HKUSTGZ-ROBOMASTER-PNX/RM25_SC5.5_OpenSource/README.md

# __RM2025赛季香港科技大学（广州）PnX战队 超级电容控制板开源文档__

# __目录__

- [__RM2025赛季香港科技大学（广州）PnX战队 超级电容控制板开源文档__](#rm2025赛季香港科技大学广州pnx战队-超级电容控制板开源文档)
- [__目录__](#目录)
  - [__序言__](#序言)
  - [__超级电容控制基本原理__](#超级电容控制基本原理)
  - [__工程原理图设计__](#工程原理图设计)
    - [__供电部分__](#供电部分)
    - [__MCU部分__](#mcu部分)
    - [__模拟部分__](#模拟部分)
    - [__DCDC部分__](#dcdc部分)
  - [__工程PCB设计__](#工程pcb设计)
    - [__区域划分__](#区域划分)
    - [__功率部分__](#功率部分)
    - [__供电部分和模拟部分__](#供电部分和模拟部分)
    - [__其他部分__](#其他部分)
  - [__代码设计__](#代码设计)
    - [__基本架构__](#基本架构)
    - [__外设配置__](#外设配置)
      - [__时钟__](#时钟)
      - [__HRTIM__](#hrtim)
      - [__ADC__](#adc)
      - [__其他外设__](#其他外设)
    - [__控制部分__](#控制部分)
      - [__Debug模式和拟合计算__](#debug模式和拟合计算)
      - [__闭环控制__](#闭环控制)
      - [__Buck与Buck-Boost与Boost切换__](#buck与buck-boost与boost切换)
  - [__测试纪录__](#测试纪录)
    - [__供电纹波__](#供电纹波)
    - [__栅极驱动__](#栅极驱动)
    - [__SW振荡__](#sw振荡)
    - [__自举电容__](#自举电容)
  - [__加工焊接测试流程__](#加工焊接测试流程)
    - [__PCB+SMT加工要求__](#pcbsmt加工要求)
    - [__焊接测试顺序__](#焊接测试顺序)
  - [__问答讨论__](#问答讨论)
  - [__版本迭代__](#版本迭代)

## __序言__

本项目为RM2025赛季香港科技大学（广州）PnX战队南部区域赛上车版本超电电容控制板（以下简称超电）开源。项目关键词：极高转换效率，低静态功耗。

PnX战队的英雄机器人、全向轮步兵、并联腿步兵、哨兵上安装了此版本超电，全向轮步兵和并联腿步兵经过电控调试后具备场上快速移动和飞坡能力。
针对RM25赛季的底盘20000J总能量限制，本项目重点优化了静态功率和转换效率，实测可以实现实现空载0.8W（24V输入，25.1V输出，所有功能与上车时相同），全负载范围97.6%效率（24V输入，12V输出，去除线损，45W-200W），峰值98.2%(24V输入，12V输出，去除线损，100W)，20A最大输出电流。

本项目为某队21年未开源版本超电的终极升级版，某队21年在没有超电的情况下惜败于湖北站3V3决赛后，笔者痛定思痛花2个月时间，参考安和科技F334 BuckBoost Demo板，完成了初版超电的软硬件设计，初版只有8A最大电流、1.7W空载功率、93%左右效率，在21赛季处于够用水平，但是不符合25赛季的性能要求。
经过多个版本迭代优化，最终在5.5版本实现了所需功能，版本迭代记录在文档中有详细记录。

***

##  __超级电容控制基本原理__

本项目的超级电容控制基于理想情况（忽略所有内阻）下的2个前提条件：

    1.电容端的电压可以通过输入电压和BuckBoost占空比直接计算
    2.电容端的功率可以通过电容端电压变化速率（dv/dt）直接控制

条件1不能理解，输出电压本来就可以通过输入电压和占空比直接计算，考虑到元器件和PCB内阻带来的压降，实测值和理论值会有一点点误差。

条件2不难证明，按照南方科技大学2024技术方案开源，电容端功率 $P = CV \frac{dV}{dt}$，其中$C$为容组电容大小，$V$为容组电压，在固定控制频率$f$下 $dt$可以转化为$\Delta{t}= \frac{1}{f}$，因此方程转化为$\Delta{V}=\frac{P}{CVf}$，这样对应任意的所需电容功率$P$，都可以计算出对应的$\Delta{V}$，最终根据条件1计算出占空比的变化$\Delta{\eta}$。

理论计算的结果就是功率控制可以由等式计算得来，无需使用PID等反馈控制方法。实际上因为存在能量损失和采样误差，最好还是以理论公式为前馈，使用PID补足误差。

*** 

## __工程原理图设计__

###  __供电部分__

供电比较常规，没有使用隔离电源或者电荷泵之类的花活。从Chassis口引24V经过一个SS210的二极管做防反接，这里没有直接在Bat输入口使用NMOS或者PMOS之类做更复杂的防反接保护，是为了避免引入额外损耗。过二极管得到的24V只用于降10V给板子上其他部分供电，所以电流很小，损耗可以忽略不计，防反接只是为了避免把MCU全部干穿，万一反接了还是依靠电池本身的短路保护。

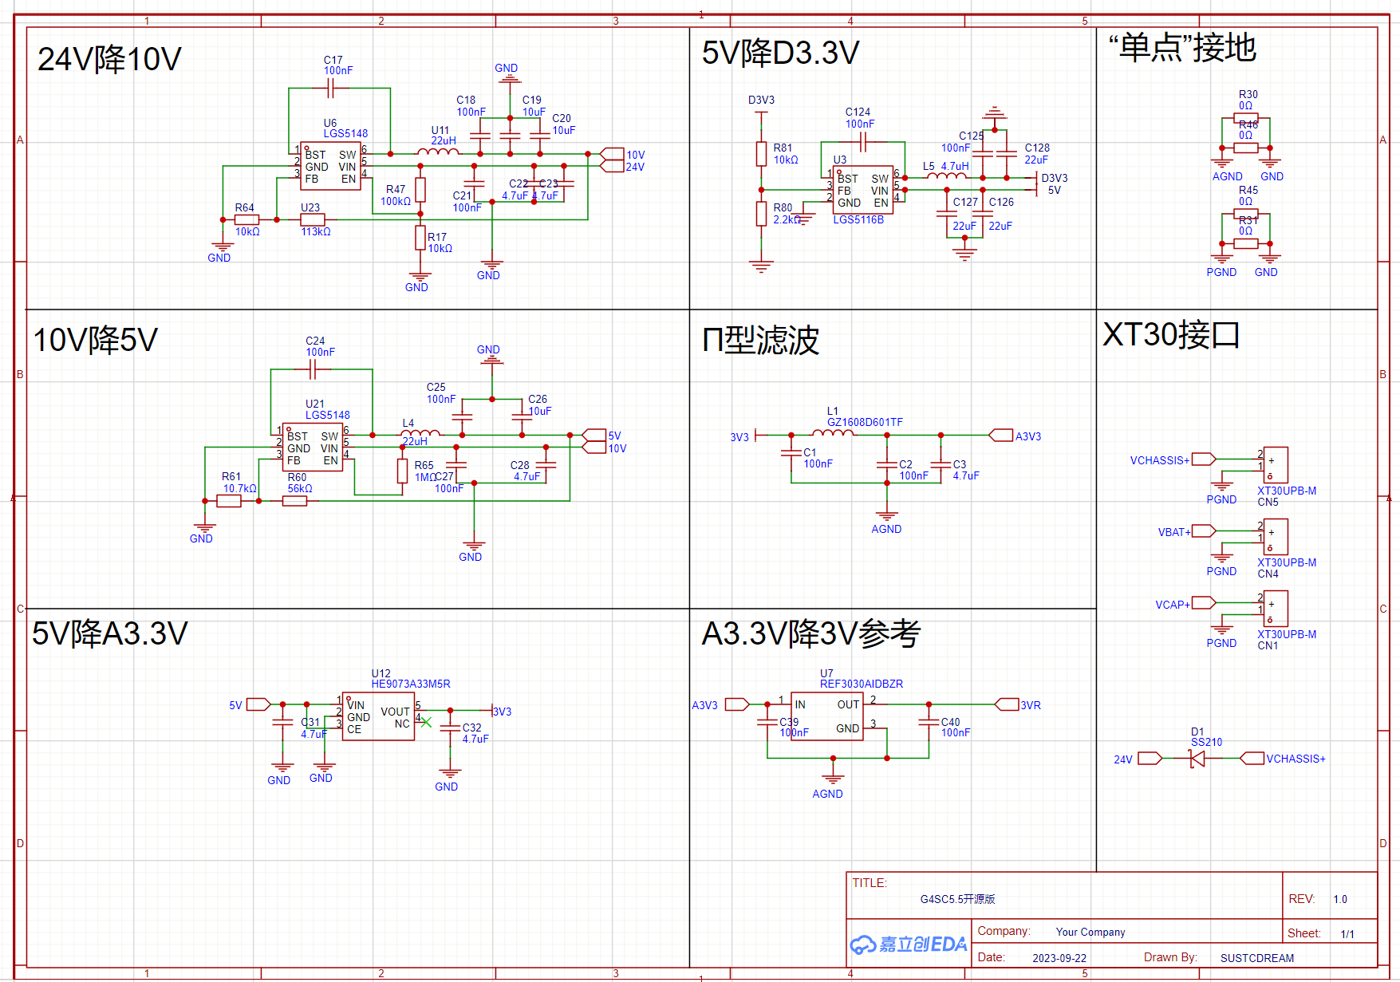
[picture p1: 图片/Markdown图片/2供电.png]
  

24V降10V和10V降5V都使用了国产LGS5148，主要是看重它48V耐压和极高的轻载效率，有群友说测得轻载下纹波非常大，甚至干扰了栅极驱动，本工程中没有出现这类问题，详情请见测试纪录部分。10V主要用于MOS栅极驱动供电，5V主要用于CAN通讯，<span style="color: red;">注意</span>24V降10V需要设置EN分压，大概设置到17V左右启动即可，从根源上避免推车等意外上电情况。注意LGS5148曾经发生过断货，如果实在买不到可以用SY8301替代。

5V降D3V3使用了同厂商的LGS5116B，主要是因为更便宜、有现货、在其他设计中使用了、买了很多没用完，D3V3是5.5版本新加的设计，之前一直是LDO出3V3。D3V3专门给MCU供电，可以略微降低静态功耗和减少对模拟部分的干扰，有些开源设计中担心24V降10V降5V降3V3的连续3个Buck降压会引入很大的纹波，本工程中没有出现这类问题，详情请见测试纪录部分。

5V降3V3使用了国产LDO HE9073A33M5R，它的PSRR在100KHz以上显著好于AMS1117，比RT9193好一点点，比TI的LP5907差一些，因为Vref+有专门的芯片提供，这里影响不大。

3V3经过Π型滤波后得到A3V3，提供给各个模拟部分供电。A3V3再过REF3030得到3V参考电压，暂时找不到性价比相对REF3030更好的替代品。

这里解释一下为什么模拟部分的供电比较复杂，按照TI的文档给出的公式，ADC总噪声中可以通过供电部分优化的是供电噪声和电压基准噪声，供电噪声受PSRR作用而一般影响不大，所以LDO部分相对随意，而电压基准噪声非常关键所以要专门处理。

  

各自用2个0Ω电阻做PGND、GND、AGND之间单点连接，所谓“单点”只是区域和区域之间的泛指，用2个电阻主要是为了防止虚焊或者电阻失效情况，具体设计在PCB部分。

***

###  __MCU部分__

MCU部分比较常规，G474相对于F334在性能、价格、开发难度的综合指标上更优，G4的Pinout都比F3更合理，而且F334没有独立的Vref+引脚。<span style="color: red;">注意</span>G474RBT6比G474CBT6便宜，5.5版本改为G474CBT6完全是为了缩尺寸。

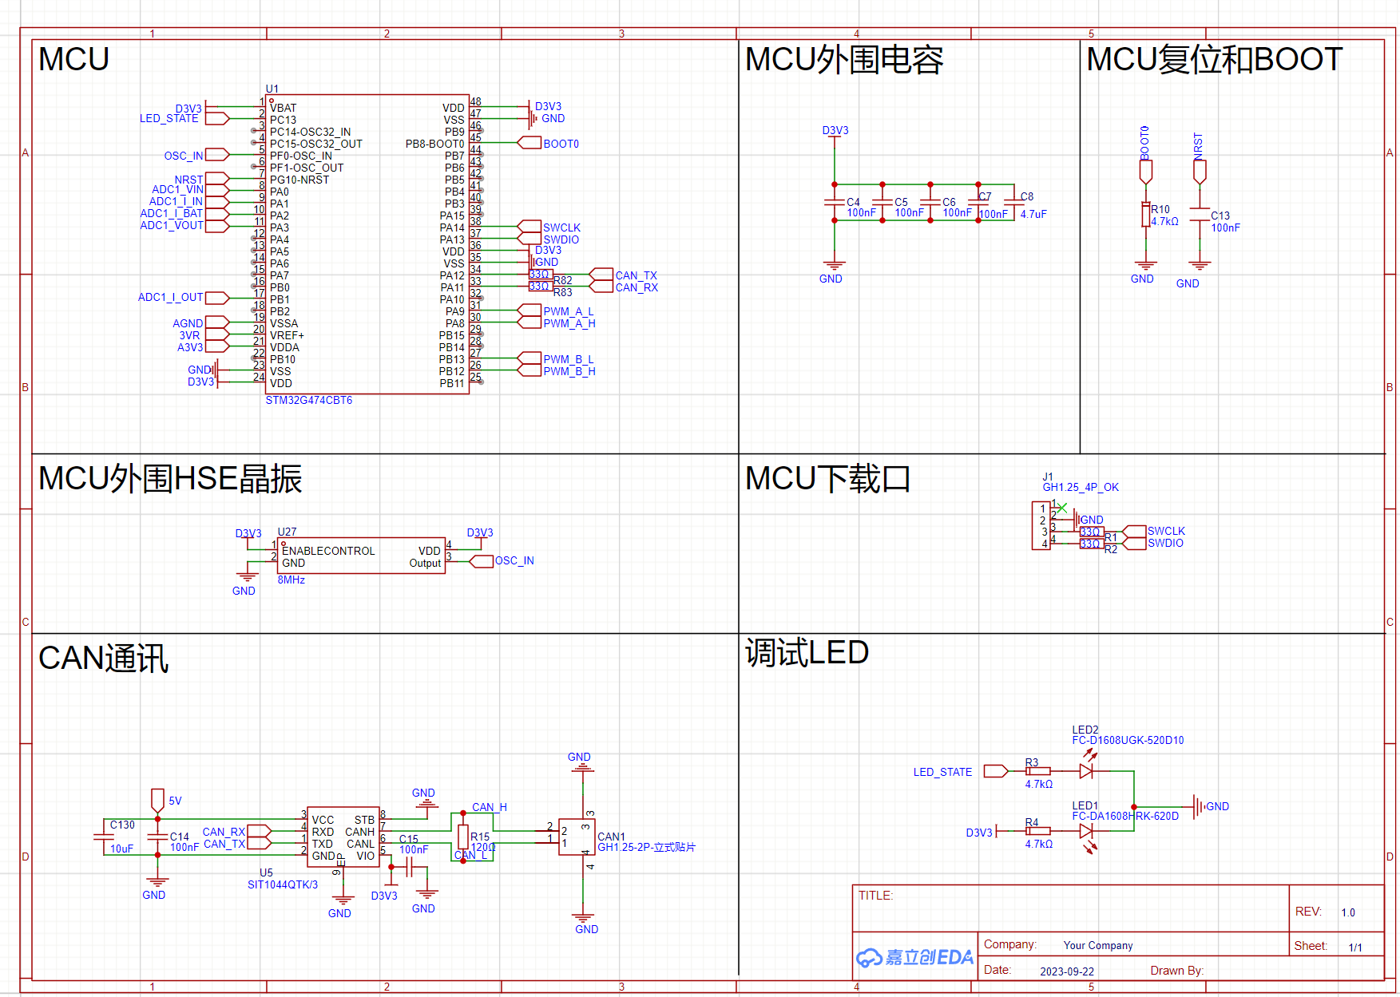
[picture p2: 图片/Markdown图片/4MCU.png]
  

HSE使用了8MHz有源晶振，主要是因为某队某年的第一版超电用无源晶振不起振，代码上临时改为HSI，后续替换为有源晶振但是代码忘记改回去了，直到2年后才发现。无源晶振便宜很多而且EMI友好，有兴趣可以改用无源晶振。

SWCLK和SWDIO串了33Ω电阻，实测可以明显提高DCDC开启时的Debug连接稳定性和代码下载成功率。外置BOOT0下拉电阻和NRST滤波电容，这里没有使用按键复位，主要是为了避免调试过程中手欠，系统复位需要通过Debug或者上下电。供电LED和调试LED用于指示系统状态，消耗不到0.1W静态功耗得到2个独立关键状态指示是完全可以接受的，某些情况下可以通过抓LED高低电平计算CPU占用率。

CAN收发器使用了国产SIT1044QTK/3，5V供电，3.3Vio，QFN小封装，面向未来的5Mbps CAN-FD，不使用NXP完全是因为立创商城要签什么出口禁制声明。1042相对1044的CAN_H CAN_L耐压更高（±70V相对于±40V），如果有48V系统会考虑使用SIT1042。

***

###  __模拟部分__

模拟部分上了点狠活，虽然超电的控制精度要求和STM32G474不到11 ENOB的ADC不需要这么高规格的电压电流采样。

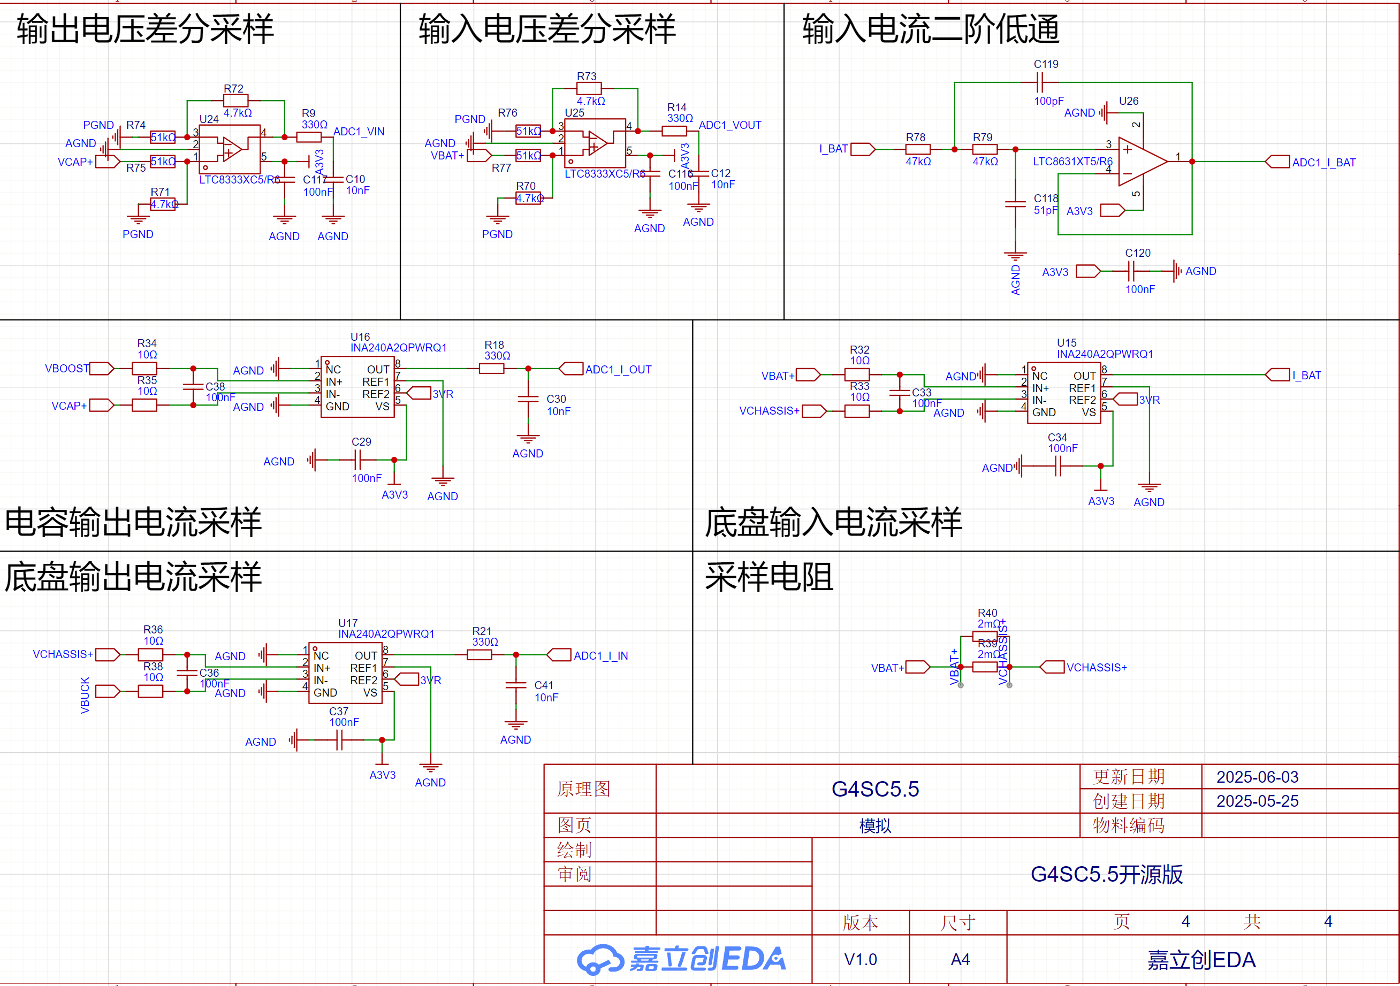
[picture p3: 图片/Markdown图片/5模拟.png]


电压采样有三种方案，电阻分压、电阻分压接电压跟随器、差分放大电路，电阻分压方案因为对ADC采样不友好(输入阻抗太大)；使用MCU内置运放或者外置运放搭建电压跟随器可以改善阻抗问题，但是大电流下受GND压差影响会产生一点点误差；差分放大电路配合layout设计可以提高采样精度和线性度，这种方案对运放的性能要求比较高，一般是用Vos低的精密运放，一些开源设计使用的是OPA2350UA/2K5，相对于LM321这类普通运放，Vos从TYP 2mV降低到了150μV，但是OPA2350UA/2K5的带宽还是太大了(38MHz)，如果使用先积集成(国产小ADI)的LTC8333XC5/R6，Vos可以降到3μV，同时350kHZ的带宽也够用。注意使用高精度低温漂电阻。

电流采样使用常规的INA240A2，万一TB上便宜货某天买不到了再考虑换CSA240或者TPA2296F。输入端加了点基本没用的差模滤波，采样电阻是2个0805 0.5W并联，相当于1个反极性的0810 1W电阻，换0612电阻会好焊接一些，但是有点贵，检测电流范围±30A，分辨率约0.015A(按ADC12bits计算)。<span style="color: red;">注意</span>INA240的输出能力极弱，如果接RC低通滤波可能需要调大截止频率(调大电阻，调小电容)，按照手册数据，输出电流最好不超过2mA，否则会直接震荡，表现为输出3V到0V的锯齿波。DCDC输入电流和电容端输出电流不参与控制，48kHz截止频率一阶RC完全够用。输入电流采样非常重要，按TI的文档搭了个二阶Sallen-Key低通滤波，截止频率约47kHz，运放要求压摆率0.88V/μs 带宽4.7MHz，实际选型为8.5V/μs 9MHz的LTC8631XT5/R6，滤波效果可能不明显，但是能极大提高INA240的输出能力。

***

###  __DCDC部分__

DCDC部分非常常规，没有多管并联，没有TOLL，没有隔离电源，没有电荷泵，没有GaN，没有多项，没有铝基板。CSD18540(或HYG025N06LS1C2)+SLM27211+PQ2918的性能目前足够满足RM的需求。(忽略原理图中的BSC028N06NS)

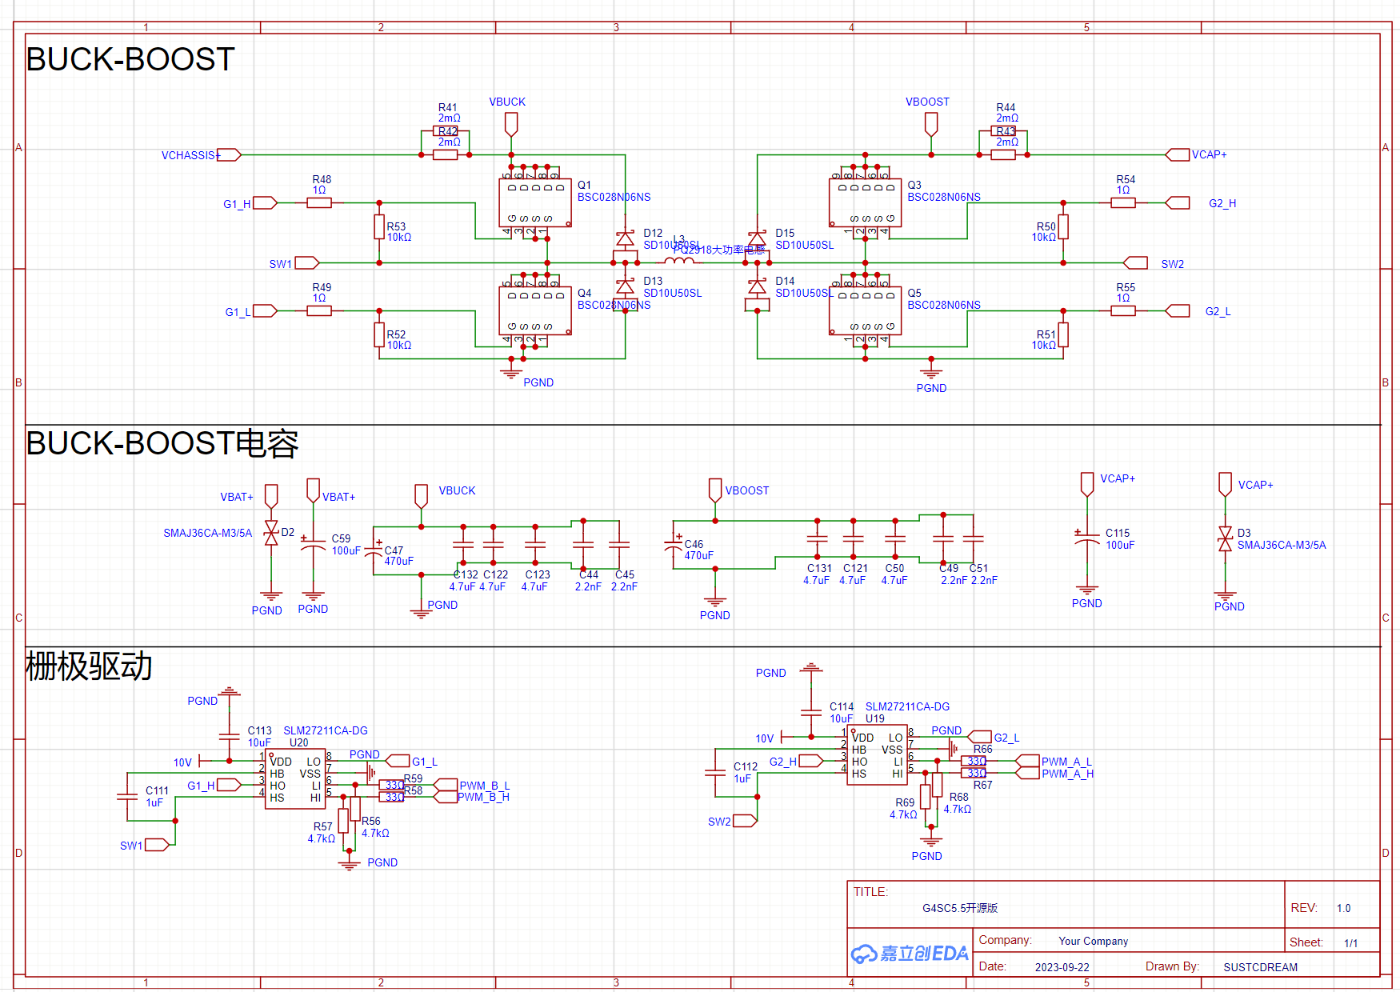
[picture p4: 图片/Markdown图片/6DCDC.png]


<span style="color: red;">注意</span>海量个例表明UCC27211有严重的UVLO问题，表现为上管驱动波形不正常，作为十多年前的老芯片，TI官方也不推荐在新设计中使用UCC27211，尤其是TB上几乎无法买到低价正品。好在有国产SLM27211可以直接等效替换，或者说SLM27211可以视为完全正常的UCC27211。如果有新设计，用MPS的也行。

<span style="color: red;">注意</span>栅极驱动的三个原理图设计问题：自举电容给多大？电源去耦电容给多大？VSS怎么接？自举电容理论上可以通过开关频率和MOS参数计算，实测100kHz开关频率下CSD18540加10kΩ栅极下拉的自举电容在330nF到1μF都可以正常驱动，这里取1μF以适配Boot Refresh功能；惯例上电源去耦电容取自举电容的10倍，也就是10μF；VSS一定要接GND，听起来就和机器人一定要能动一样是句废话，但是如果分割了PGND和GND（即使不分割，后续PCB设计还会碰到这个问题），VSS接哪里就变成选择输入PWM回路优先，还是栅极驱动回路优先。从Innoscience的驱动设计制导中不难看出，栅驱的VSS和下管S极越近越好（或者说回路越短越好，上管S级和栅驱HS同理），栅极VSS必然接PGND。栅驱输入串了33Ω，再加点下拉电阻，PGND和GND单点连接合理的情况下不会出问题。

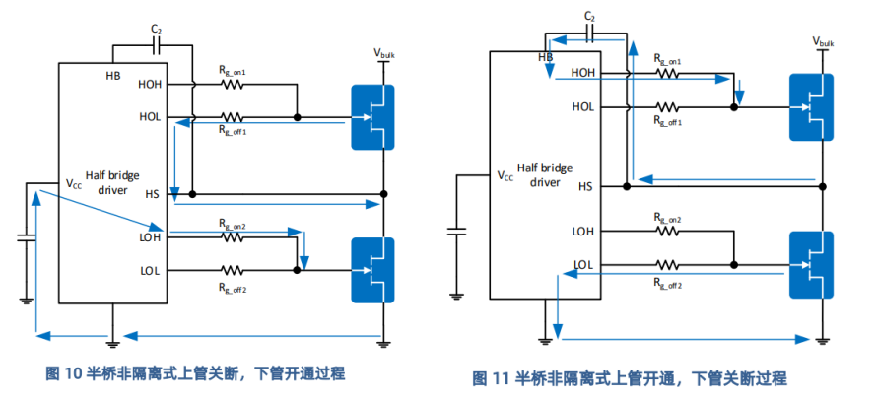
[picture p5: 图片/Markdown图片/7栅极驱动.png]


BUCK-BOOST输入输出电容的最小容值可以根据设计的纹波大小和开关频率进行计算，实际上只要PCB上空间充足，大部分方案都是2倍冗余以上的堆料王。放多少电容才够？放什么类型的电容？电容位置是怎样排列的？都是值得深思的问题，这里提供两种理解思路。

假设MOS开关足够快，考虑到输入电源回路的寄生参数，可以把输入电容当成滤波器（去耦电容），用于消除MOS开关的方波干扰，方波傅里叶变换出低频、中频、高频部分，考虑到电容的ESL和ESR参数，电解电容的ESL和ESR偏大（固态电容是上位替代，ESR小很多），只在低频范围有明显效果；MLCC的ESL相对小，和封装与频率有关，一般是1206封装在中频作用，0603封装在高频作用，如果要追求最好的高频效果，需要使用C0G材质0603封装。方波傅里叶变换的幅值是低频>中频>高频，所以电容容量也是对应递减。考虑到PCB寄生参数，远近关系也是电解最远，小封装MLCC最近。

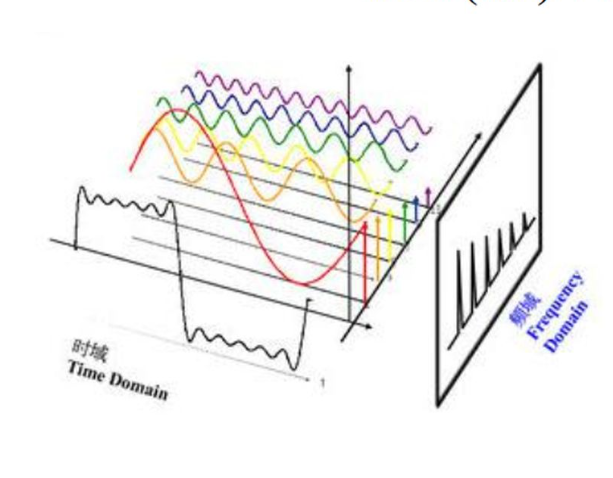
[picture p6: 图片/Markdown图片/8方波.png]


另一种思路更加直接，根据纹波电流来设计电容作用（滤波电容用法）。模型代替大脑，公式代替思考，直接使用最强电源设计工具TI Power Stage Desiger Tool。

输入超电参数，得到Cin的RMS Current，打开Tool->Capacitor Calculator，分别套用固态电容、1206 MLCC、0603 MLCC的参数（ESL为估计值），得到各自的RMS Current。
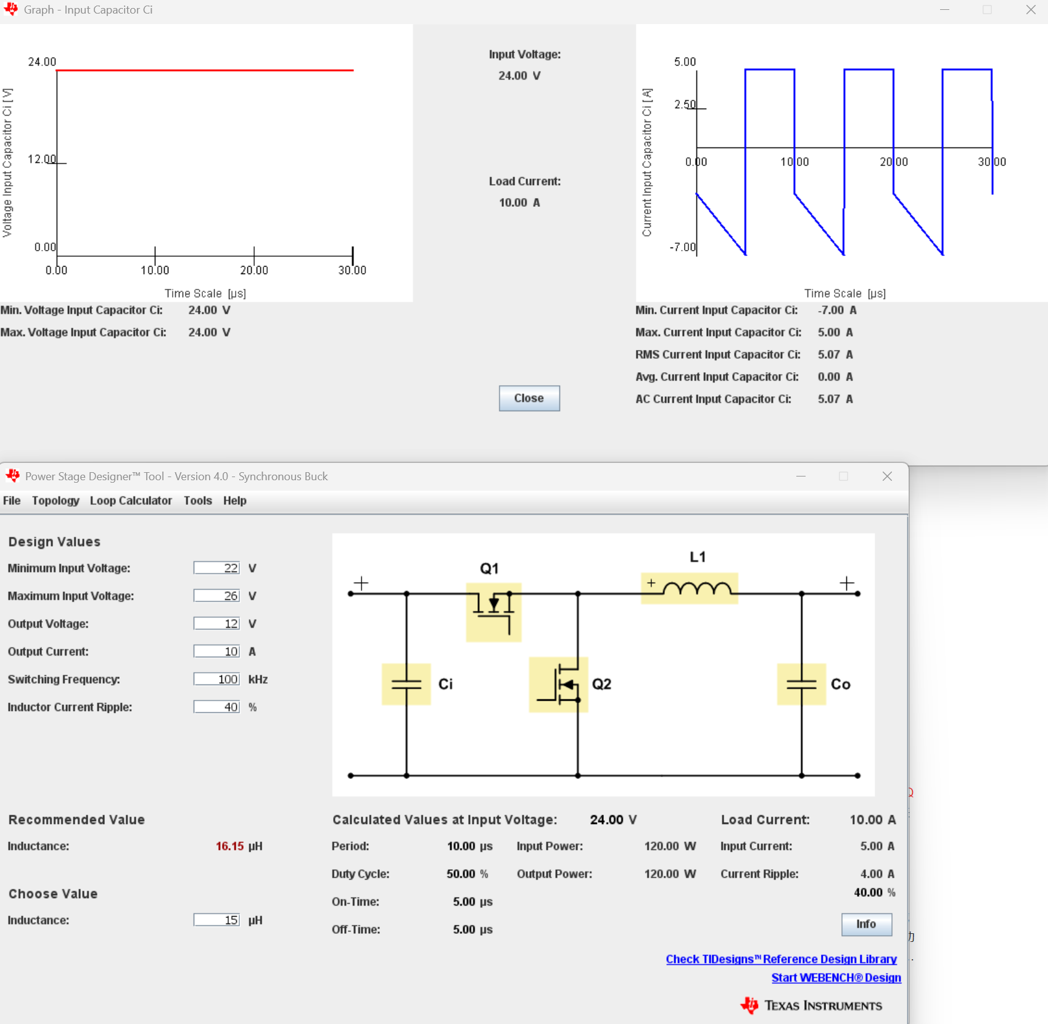
[picture p7: 图片/Markdown图片/9Cin.png]

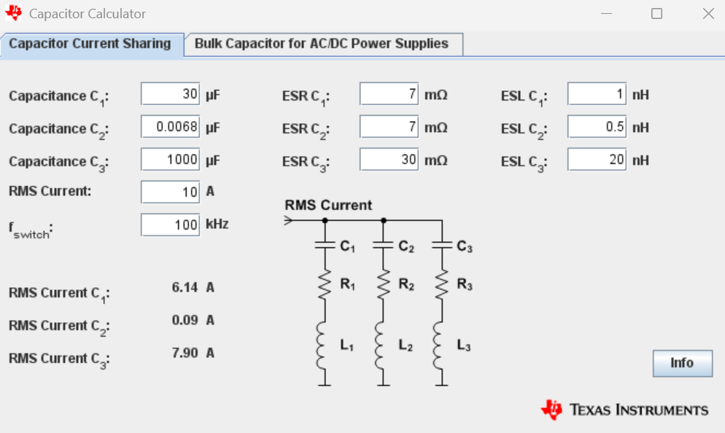
[picture p8: 图片/Markdown图片/10CinCurrent.png]


主要是固态电容和大封装MLCC的纹波电流比较大，查阅各自数据手册，额定纹波电流不够就并联。以此类推，本项目采用1000uF * 1+4.7uF * 3+2.2nF * 2的设计，具体物料在BOM表中，忽略原理图中的型号。

MOS部分比较常规，串联1Ω的作为占位符，根据实测波形进行调整，下拉10kΩ保证安全，4个TO-277肖特基二极管辅助续流和分担MOS压力（一般是放在Buck下管和Boost上管，双向就全放了），大部分方案的MOS选型趋同于使用白嫖物料、拆机CSD18540或者全新HYG025N06LS1C2，新系列和新结构的MOS一般性能更好，而且MOS价格可能与市场供求关系有关，不是越贵越强。

不用花太多时间在MOS选型上，一般是定个耐压，然后选个平衡价格、内阻、栅极电荷的物料。<span style="color: red;">注意</span>有些国产型号的参数虚标（主要是Qg），有些国产型号的Gate Charge Characteristics与手册参数不符（点名表扬SP60N02BGNK，图上44nC，手册101nC）。

 型号 | 耐压/V | Typ.导通内阻@10V/mΩ |Typ. 栅极电荷@10V/nC|工艺|
| :-----:| :----: | :----: | :----: | :----: |
| HYG025N06LS1C2 |60 | 2.1| 59.5 | SGT |
| HYG022N04LS1C2 |40 | 2.2| 29 | SGT |
| CSD18540Q5B |60 | 1.8 | 41 | NexFET™ |
| BSC066N06NS |60 | 5.5 | 17 | Trench  |
| BSC028N06NS |60 | 2.5 | 37 | Trench  |
| WSD40120DN56G |40 | 1.4 | 45 | SGT  |

电感选型比较简单，计算公式、TI设计工具或者MPS官网选型工具算出来都是100kHZ对应10~15μH，然后选个额定电流和温升电流都够的就行。某些情况下，电感可以充当MOS的散热片，本项目使用SER2918H-153。

 型号 | 封装 | 内阻/mΩ |额定电流@30%drop/A|温升电流@ΔT=40℃/A|
| :-----:| :----: | :----: | :----: | :----: |
| 凯必达PQ2918-15μh |PQ2918 | 5(实测1.4)| 21 | 30 |
| SER2918H-153 |PQ2918 | 2.6| 21.9 | 28 |
| FXL2213-150-M |SMD,23.5x22mm| 6.12 | 18 | 26 |
| PD2923B-153KL | PD2923,插件 | 2.2 | 24.4 | 28 |

***

##  __工程PCB设计__

PCB设计只设置了两个硬性要求：PCB可以使用任意角度通过两个装甲支架间并用螺丝固定，可以用嘉立创四层券免费打样。使用立创EDA（专业版）绘制，实际的PCB尺寸为68mm*45mm，有3个M3固定孔，顶层底层元器件丝印编号放不下就全删了，在位号图里。

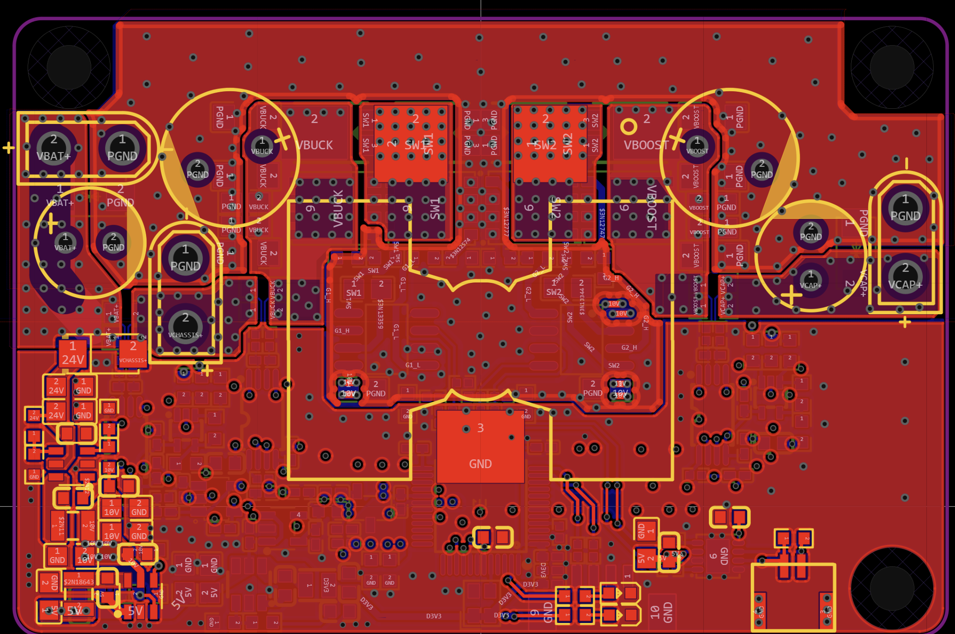
[picture p9: 图片/Markdown图片/11Top.png]

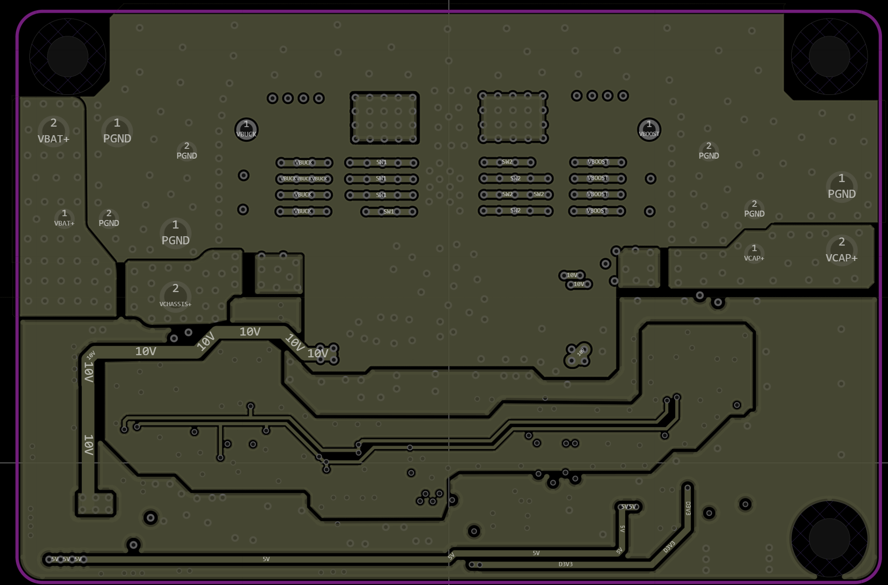
[picture p10: 图片/Markdown图片/12In1.png]

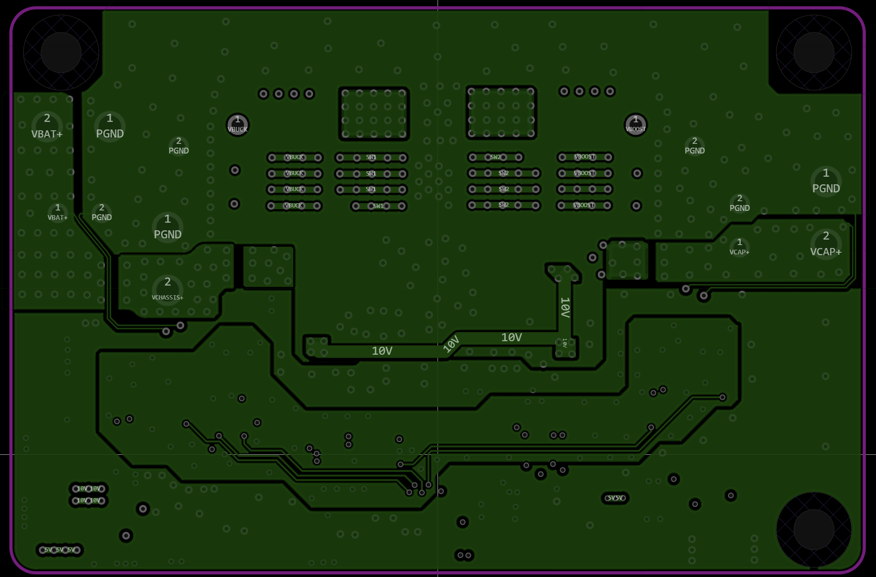
[picture p11: 图片/Markdown图片/13In2.png]

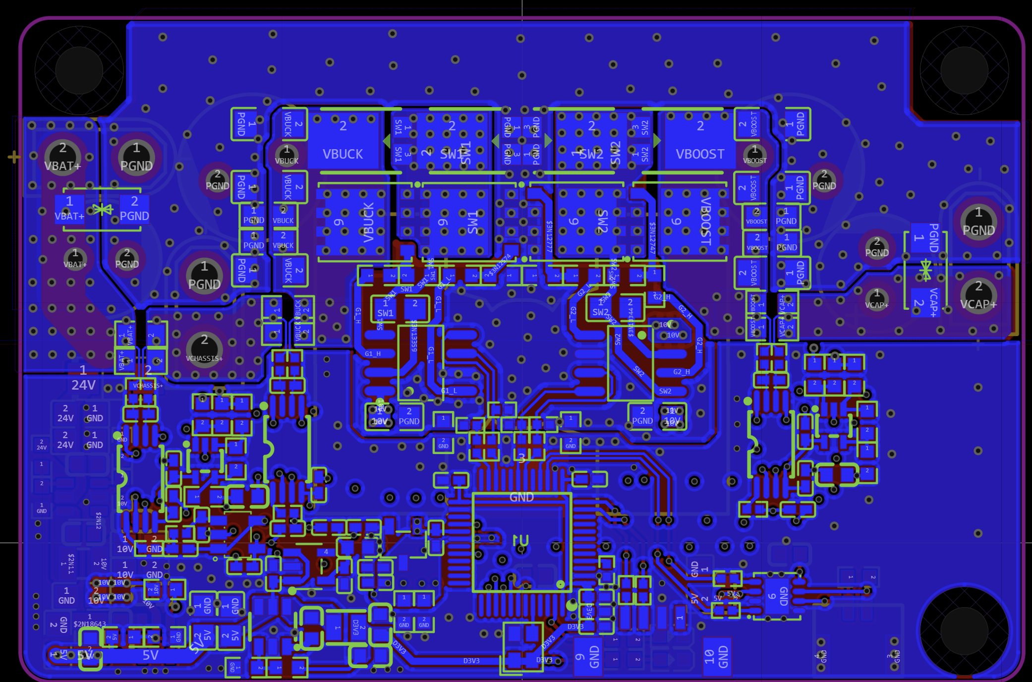
[picture p12: 图片/Markdown图片/14Bottom.png]


***

###  __区域划分__

区域划分涉及到元器件布局和之后走线铺铜的优先级。区域的优先级为功率>模拟>>供电>其他。尤其是功率部分和模拟部分，二者之间设计上尽可能分隔，完全没有相邻或者重叠的部分。

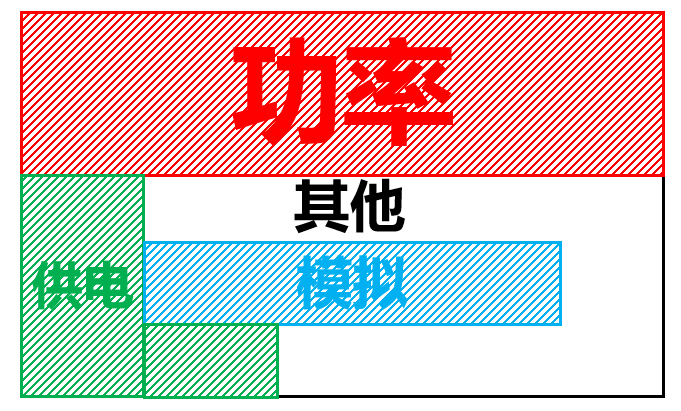
[picture p13: 图片/Markdown图片/15PCB布局.png]


***

###  __功率部分__

功率部分参考Innoscience的《InnoGaN Layout 设计指导》和《InnoGaN热设计指导》中的思路和数据，魔改了一下TI的《Improve High-Current DC/DC Regulator EMI Performance for Free With Optimized Power Stage Layout》中的布局。所谓垂直功率回路（TI称Vertically Oriented Switching Loop）就是上管、下管和电容排成一列，下管GND和电容GND在两端，靠大量过孔走内层GND连接，Innoscience没给具体布局样例（目前没有DFN5*6封装的低压GaN），TI给了具体样例。

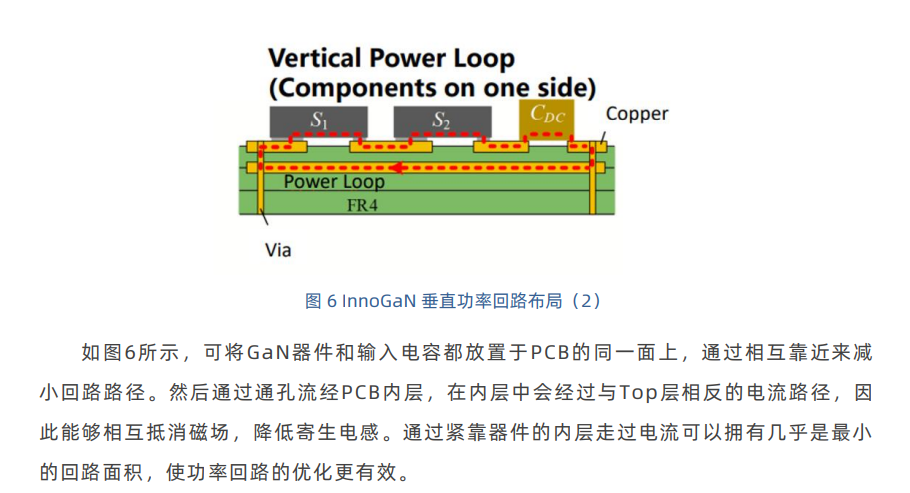
[picture p14: 图片/Markdown图片/16Inno.png]

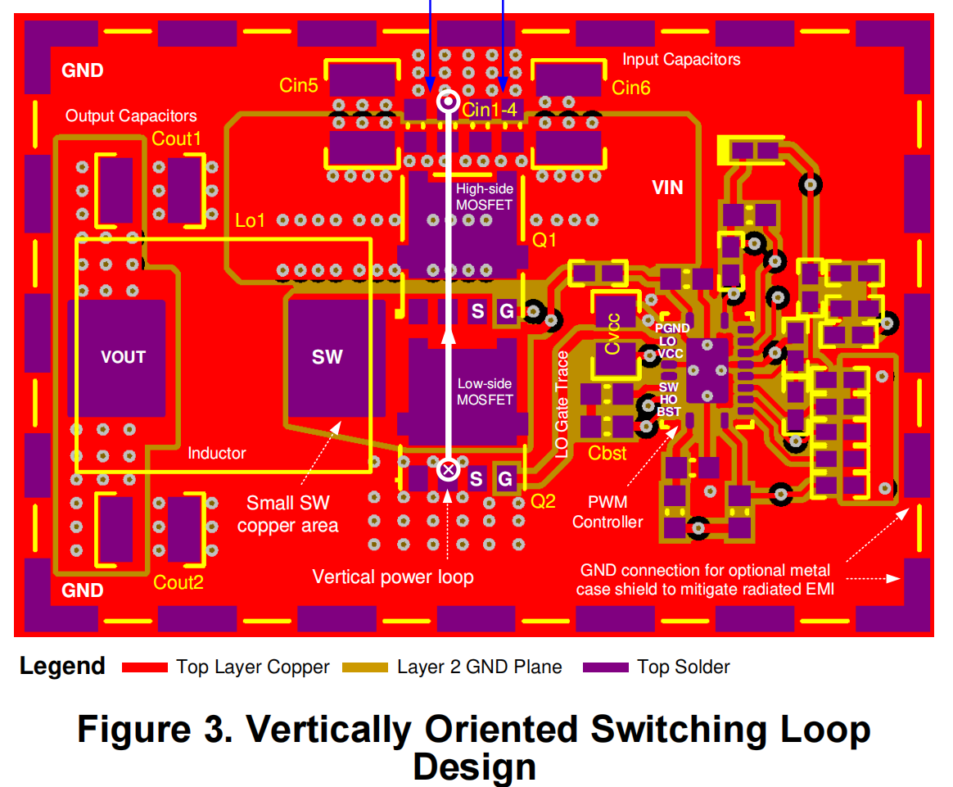
[picture p15: 图片/Markdown图片/17TI.png]


实际设计中进行了一些调整。众所周知，嘉立创不加钱的情况是内层是0.5Oz，正常情况下不适合走电源，而Innoscience和TI的设计中只用到了两层，对四层板来说有点浪费，所以本项目实际上是对称设计，即两个内层都走GND，两个外层都铺回路；同时也在外层保留了正常规格的平面回路，以分担内层的过电流压力。实际设计中有一个很大的问题，为了配合电感和MOS不在一面的设计，以及把底面的回路导到正面，MOS上打了一堆过孔（过孔数量和尺寸与热设计有关），结果把两个内层的GND平面切的稀碎。综合考虑后暂时维持这个设计，如果有后续版本会考虑删掉一半过孔，再进行对比测试。

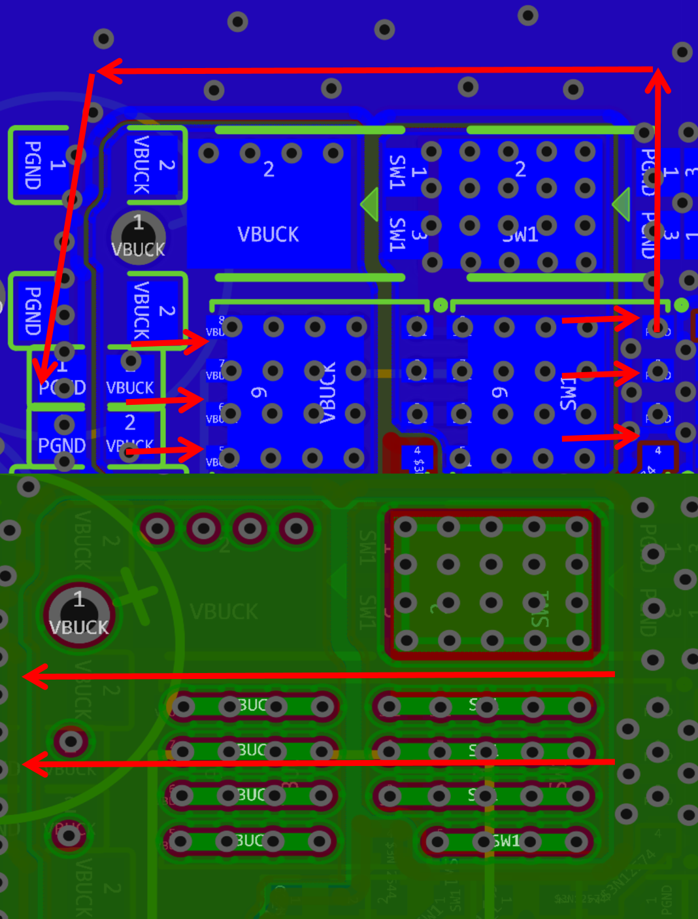
[picture p16: 图片/Markdown图片/19Loop.png]


栅极驱动想办法降低环路电感，有些开源设计只管驱动输出到MOS栅极的布线，忽视了上管栅极到SW、下管栅极到GND的布线。

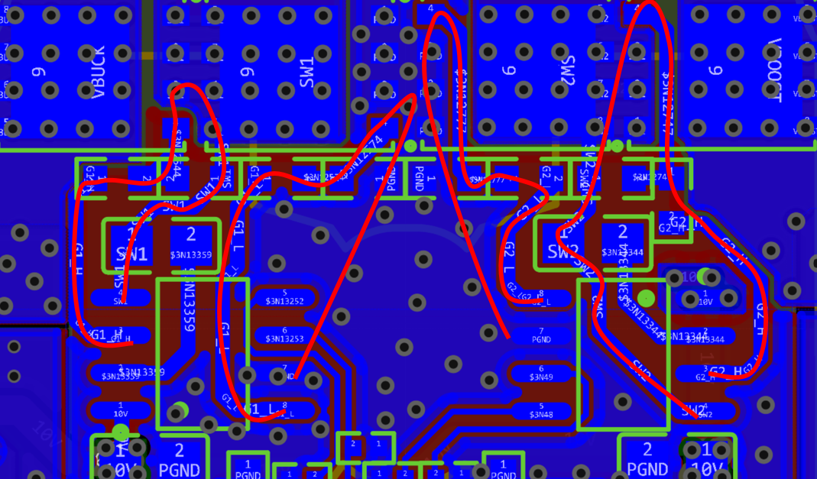
[picture p17: 图片/Markdown图片/20Driver.png]


***

###  __供电部分和模拟部分__

24V降10V、10V降5V、5V降3.3V的供电部分为了避让功率和模拟部分，以L型布局放在了板子边缘，5V降3.3V放背面主要是怕被正面的2918大电感干扰，总的来说就是妥协layout换空间。

模拟部分首先考虑的是STM32的PINOUT设计，STM32G474系列可以很自然的分出数字部分和模拟部分，考虑到多对VDD和VSS，数字部分还可以进一步细分。底层和两个内层都遵循这个原则，顶层使用完整GND进行屏蔽，一层内层走模拟供电和参考电压，一层内层走模拟信号，内层铺AGND，如果有数字部分导线经过模拟区域，使用AGND交替进行屏蔽，这样做的好处是最大限度减少功率部分和数字信号部分对模拟部分的干扰。

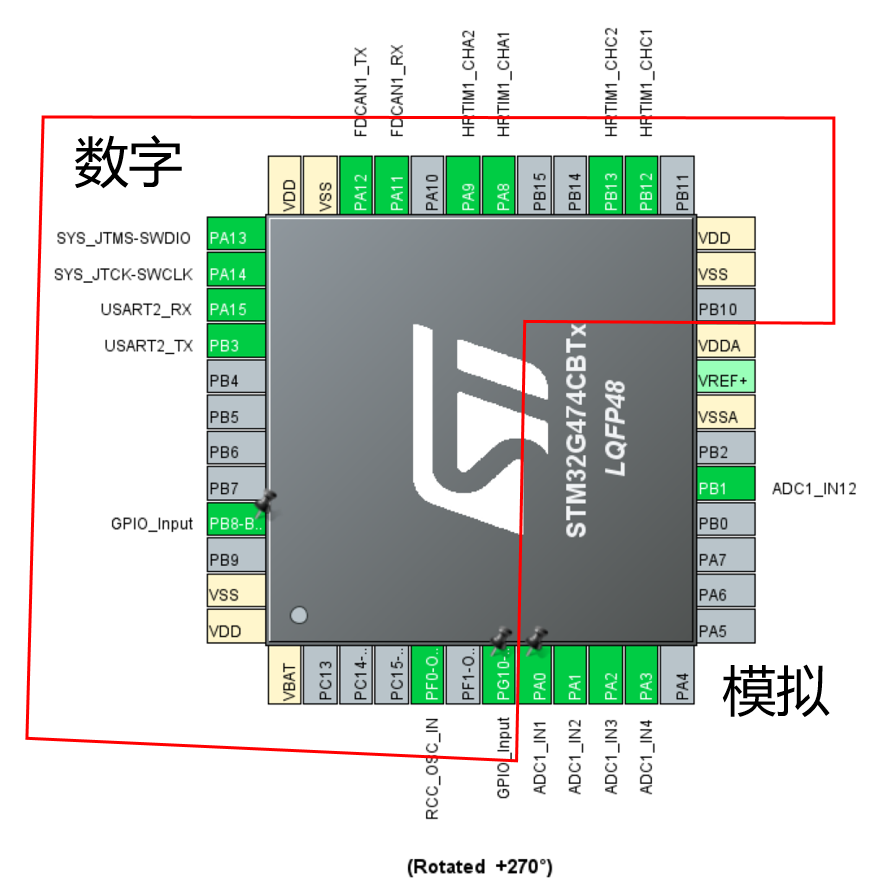
[picture p18: 图片/Markdown图片/21STM32.png]

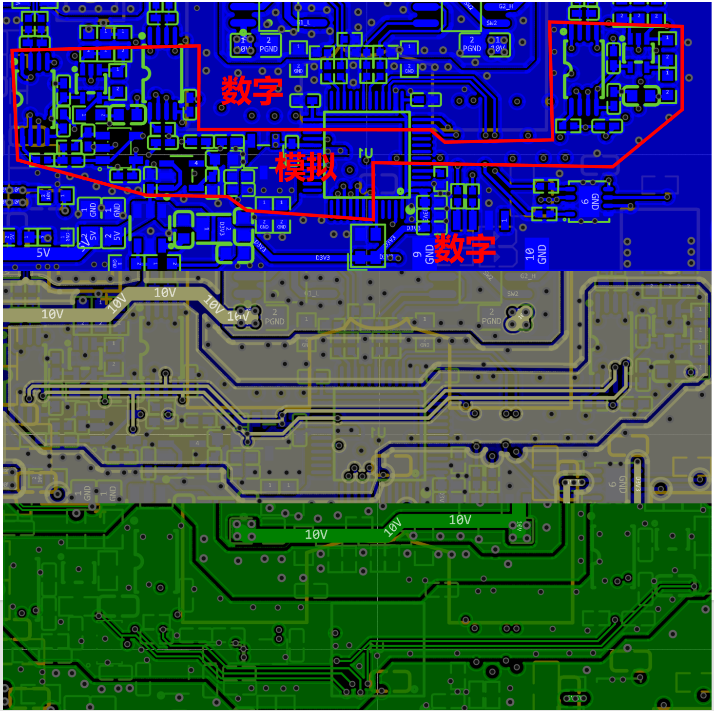
[picture p19: 图片/Markdown图片/22AD.png]


电压采样和电流采样都走的开尔文接法，电压采样注意连接大电容两脚附近或者XT30两脚附近，否则会失去差分的意义。

***

###  __其他部分__

GH1.25打一排过孔，可以大大强化连接强度，防止被拽下来，适用于所有分电板。
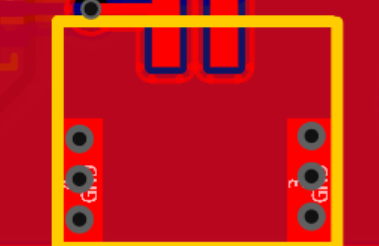
[picture p20: 图片/Markdown图片/23GH125.png]


正反面阻焊开窗，插件阻焊拓展到0.5mm，可以增强焊接后的过流能力，以及防止插件虚焊，适用于所有分电板。
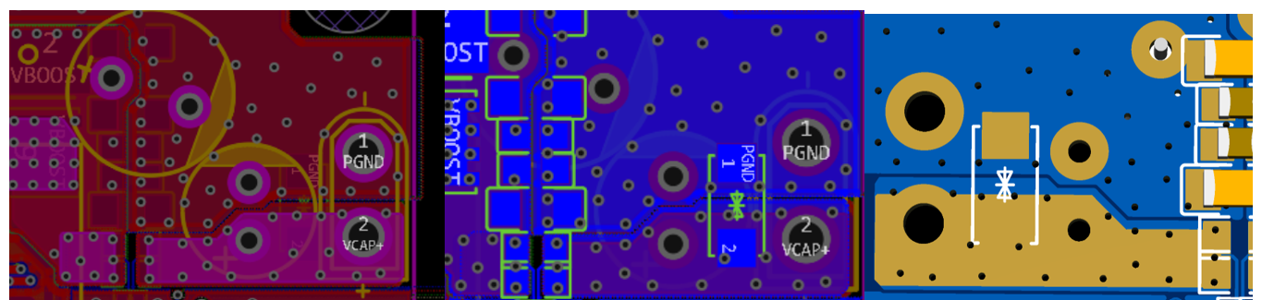
[picture p21: 图片/Markdown图片/24Z.png]


固定孔位留足禁止区域（M3孔位留直径6），就算机械安装在碳板上，把PCB拧爆都不会导电。对机械友好的PCB圆角边缘，和整数毫米的孔位间距。
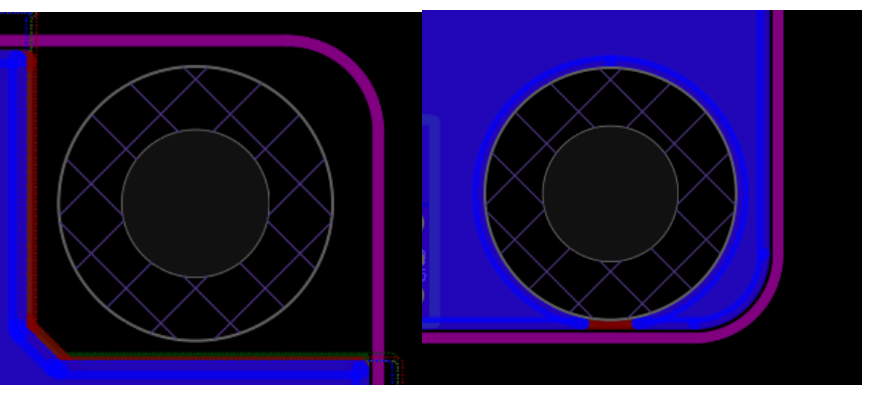
[picture p22: 图片/Markdown图片/25M3.png]

***

##  __代码设计__

代码部分迟迟没有开源，是因为原版代码只是实现了控制功能，代码架构和控制方法基本上没有参考价值，在外设配置和中断设计上存在很大问题，例如因为搞不定Hrtim触发ADC，单独开了一个TIM；因为感觉控制计算时间不可控可能影响Hrtim运行，单独开了另一个TIM的50K中断里放控制代码；因为ADC采样时间点不确定导致电感纹波电流干扰严重，只能把ADC触发频率改为1/7开关频率，使用软件滤波处理；因为搞不定FDCAN的过滤器所以没开，板间通信中无关的数据也会触发超电CAN中断;为了减少开关损耗，开了Hrtim的100KHz中断控制输出，达到近似于上管常开的效果，但是比较浪费性能。

总结以上问题，最主要是没有很好利用Hrtim本身的硬件功能。如果能够利用Hrtim的Burst mode控制输出，利用Hrtim的某些event触发ADC采样，可以极大的简化外设配置，同时提高性能。主要困难在于LL库配置Hrtim的这些功能基本上没有代码可以参考，实际上是靠看手册查寄存器反查代码的方法，还遇到了很多奇妙问题。

***

### __基本架构__

代码结构比较松散，ADC采样计算、功率控制、板间通讯分别在不同的中断里执行。控制部分其实可以整合进HRTIM的repetition中断里，但是HRTIM的配置和控制部分执行频率一直在修改，单独开个Timer8方便调试。

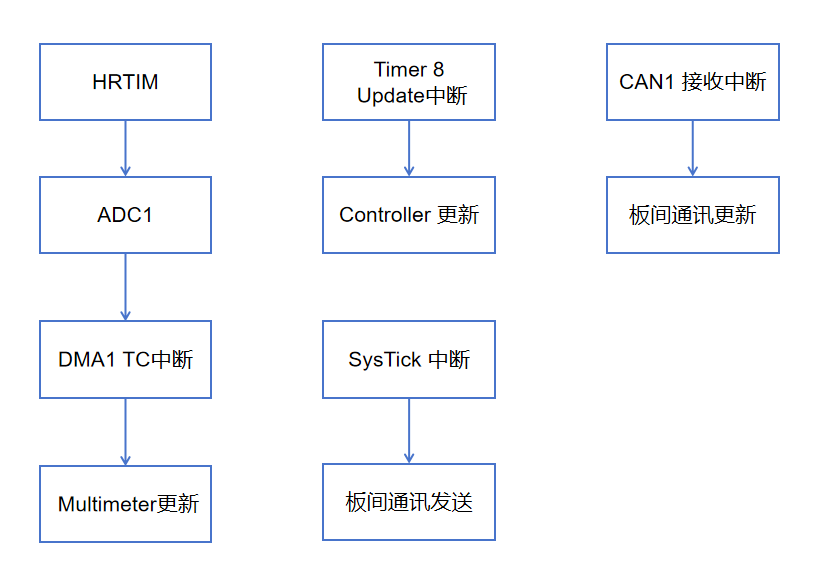
[picture p23: 图片/Markdown图片/33中断.png]

<center>中断</center>
<br><br>
由于外设之间的组合关系和部分外设特殊的配置要求，外设的初始化和使能顺序有严格的要求(在具体外设配置部分简要说明)，如果需要调整相关代码，建议自己画一块G474的最小系统板，不要直接在超电控制板上更改外设部分。

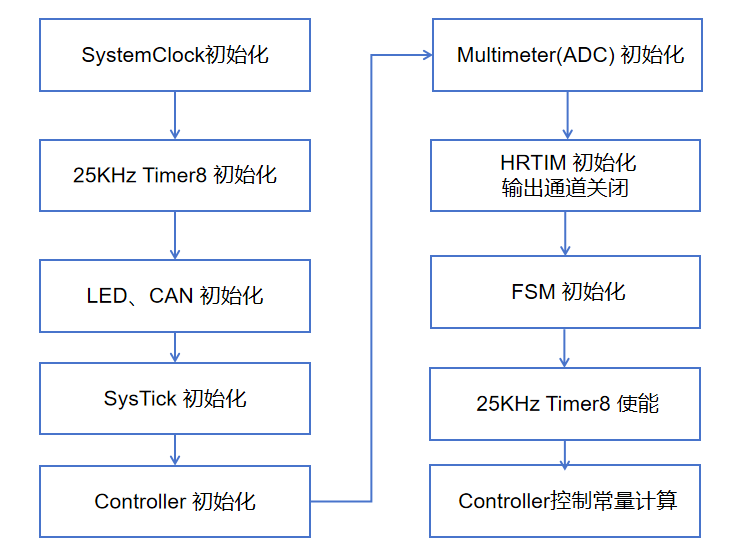
[picture p24: 图片/Markdown图片/34初始化.png]

<center>外设初始化</center>
<br><br>

控制部分代码由cpp编写，把继承、多态等特性去掉后，本质上C with class和纯C + struct差不多。还是简要说明一些概念以便理解：controller指的是升降压控制器（步兵上就是底盘控制器、云台控制器之类），controller总揽外设以外的所有控制部分；FSM指有限状态机，FSM是controller中的一个组件，负责功率环、电流环的执行和切换。

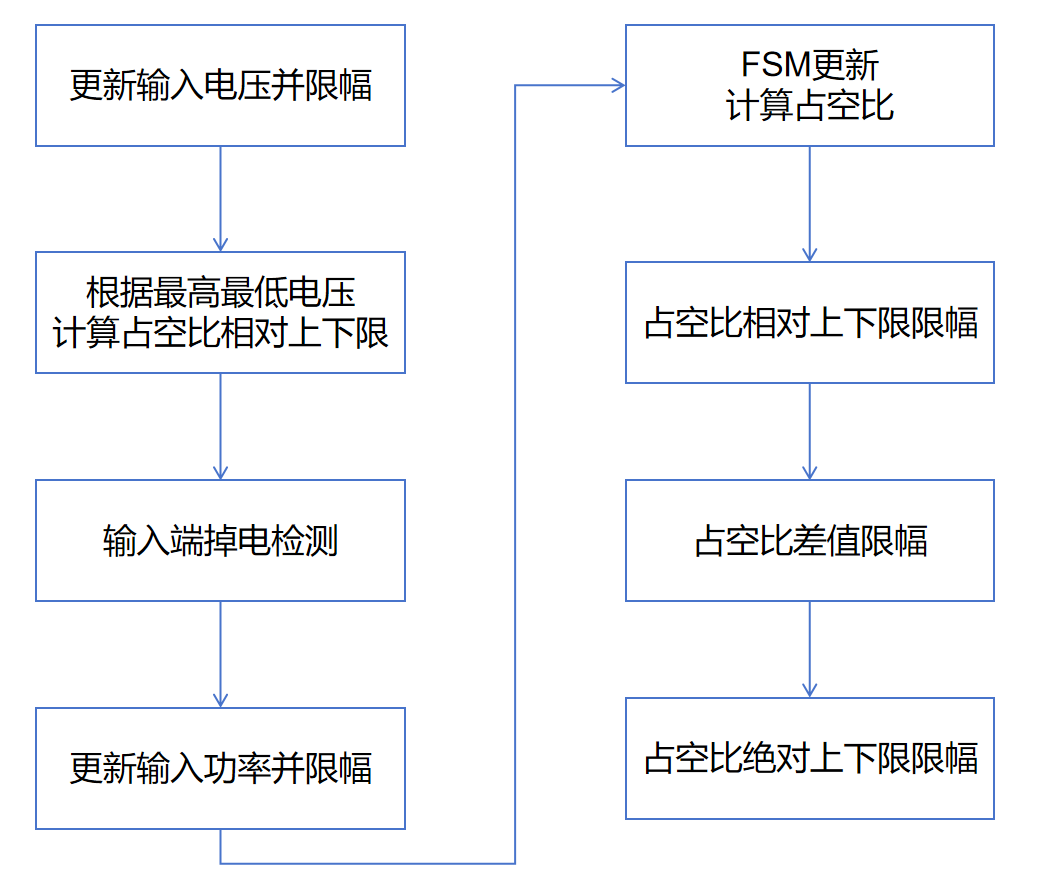
[picture p25: 图片/Markdown图片/35controller.png]

<center>controller执行</center>
<br><br>
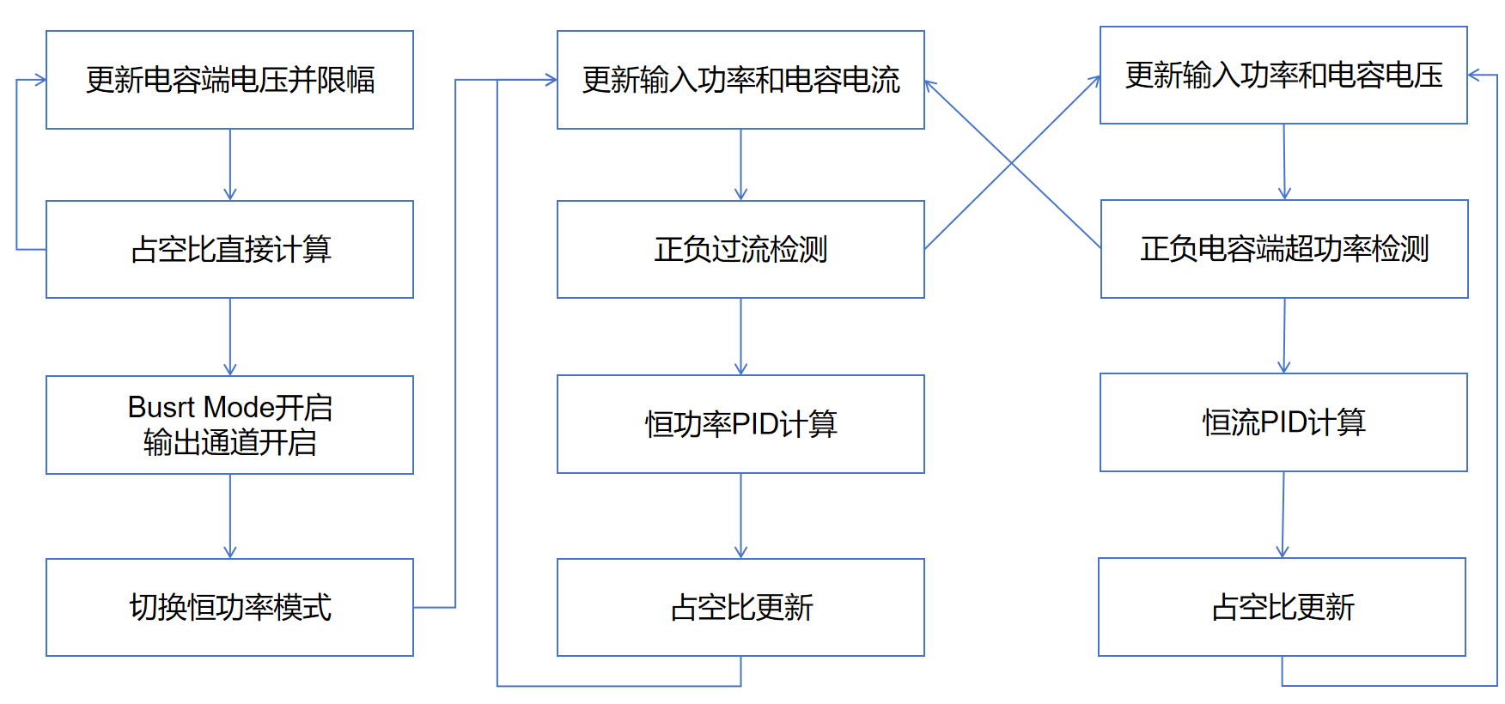
[picture p26: 图片/Markdown图片/36FSM.png]

<center>FSM执行</center>

***

###  __外设配置__

#### __时钟__

众所周知，STM32外设耗电量与时钟频率成正比，而耗电大户HRTIM在CubeMX的时钟下限为100MHz(实际上应该可以更低)，从省电又不损失太低性能的角度分析，配置SYSCLK为100MHz可以达到极限省电同时满足控制要求（F334的72MHz都够用）。将主时钟从170MHz降低到100MHz还有3个好处：可以从Range1 Boost模式（Vcore = 1.28V）切换到Range1模式（Vcore = 1.2V），进一步省电；ADC时钟从4分频 42.5MHz提高到 2分频 50MHz，提高采样速度；从Flash Latency 4降低到Flash Latency 3，减少频率降低带来的计算性能损失。详细时钟配置在main.cpp的SystemClock_Config中。

***

####  __HRTIM__

HRTIM（高分辨率定时器）是ST数字电源系列（F334，G474，H743）最核心的外设，单纯使用HRTIM或者将HRTIM和ADC、COMP组合都可以实现数字电源控制。但是ST的HRTIM好像有什么大病，有些关键的功能非常难用，不知道是硬件bug还是feature。

本项目配置HRTIM为fHRTIM = 100MHz，16倍频得到fHRCK = 1.6GHz，4倍频得到fDTG = 400MHz(即死区时基为2.5ns)，Master Timer Period = Timer A Period = Timer C Period = 16000，得到PWM频率为 100KHz，Burst Mode下 RUN:IDLE = 1:15，即常开侧开关频率降低至1/16即6.25KHz同时占空比提高，其他配置此处不赘述，下面具体说明Burst Mode配置。

理论上HRTIM的功能可以参考下图（以HPM6P00为例），理论上Burst的功能和后续部分不会出现什么干扰


<center>PWMv2</center>
<br><br>

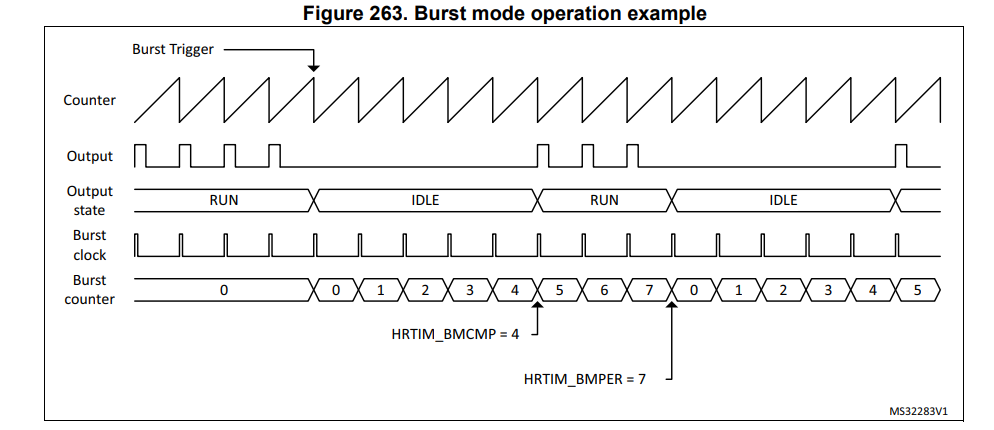
[picture p27: 图片/Markdown图片/39Burst.png]

<center>Burst在RUN:IDLE = 3:5下的功能</center>
<br><br>

而在STM32G474下Burst Controller处在一个“我很神秘”的老六位置，结果就是Burst的配置会同时干扰前面部分Set/reset corssbar中对死区时间的控制，和后面部分Output stage对初始空闲状态输出电平的控制。建议在最小系统板上使用逻辑分析仪或示波器调试。

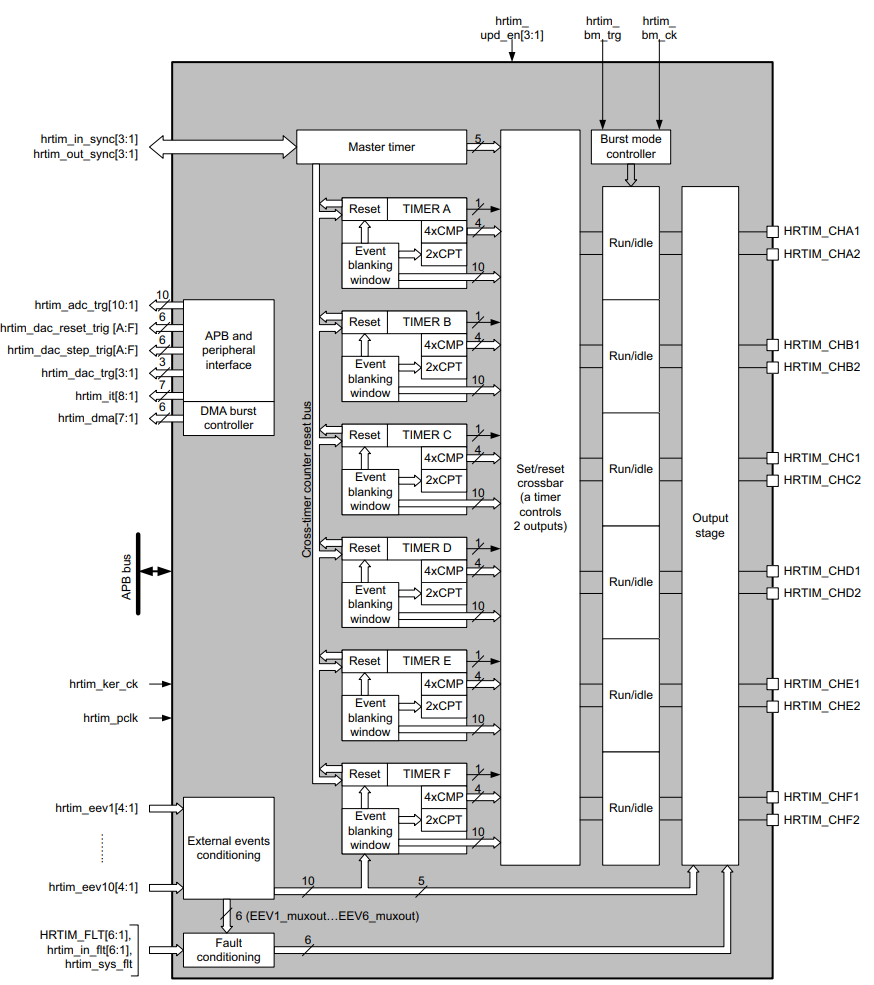
[picture p28: 图片/Markdown图片/38ST.png]

<center>HRTIM</center>
<br><br>

Burst对死区时间的干扰主要为原有死区时间减小和其他地方出现本不该有的死区，具体表现如下，后面的死区直接消失了，同时高电平时间被延长。

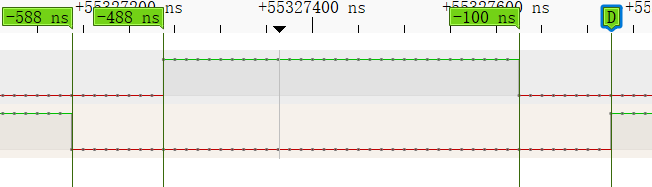
[picture p29: 图片/Markdown图片/40DT1.png]

<center>TA1 TA2 正常死区</center>

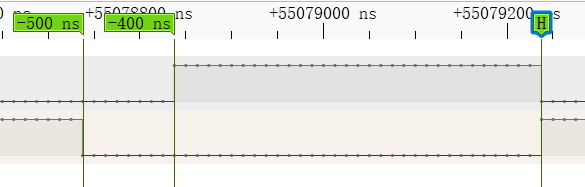
[picture p30: 图片/Markdown图片/41DT2.png]

<center>TA1 TA2 异常死区</center>
<br><br>

通过设置LL_HRTIM_OUT_SetBMEntryMode(HRTIM1, LL_HRTIM_OUTPUT_TA1, LL_HRTIM_OUT_BM_ENTRYMODE_DELAYED) 和 LL_HRTIM_OUT_SetBMEntryMode(HRTIM1, LL_HRTIM_OUTPUT_TA2, LL_HRTIM_OUT_BM_ENTRYMODE_DELAYED)可以实现正常的死区时间，大致原理是Deadtime和Burst之间存在相互覆盖的问题，设置Deadtime的优先级更高即可，在官方手册28.3.10和28.3.15中有具体说明。

实际上此功能在Timer A和Timer C中有不一样的表现（可能和Set Reset的顺序有关），在Timer C中进行以上设置反而会触发问题，表现为第一个死区时间偏短，之后一段时间莫名其妙插入一个正常死区。不进行配置反而正常，但是会略微影响Timer A和Timer C的时序，破坏中心对齐。（ST官方：我不希望用户拿到我的芯片可以直接使用）



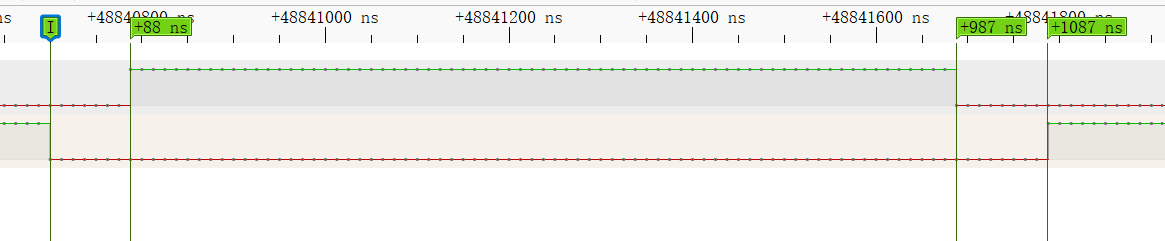
[picture p31: 图片/Markdown图片/43DT4.png]



<center>TC1 TC2 异常死区</center>

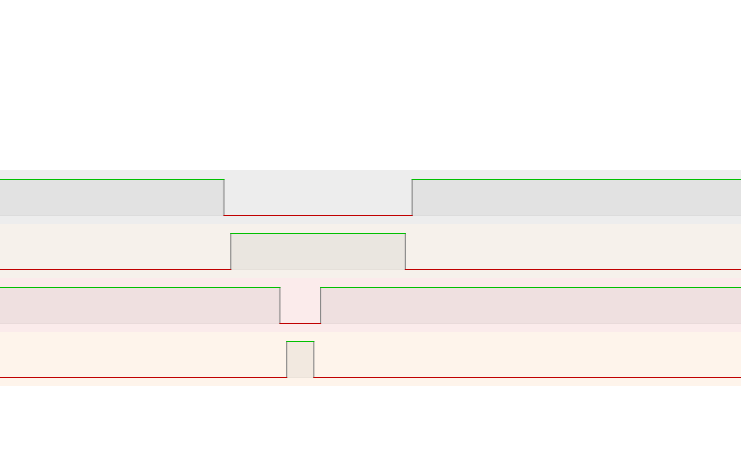
[picture p32: 图片/Markdown图片/47OUT3.png]

<center>中心不对齐</center>
<br><br>

Burst对输出电平的干扰主要为，初始化后未使能Output时电平不受控拉高，导致上管或下管直接开启。大致原因为Burst的LL_HRTIM_OUT_SetIdleLevel会直接覆盖掉输出，即使Output没有使能。解决方法就是调整Burst Mode的初始化顺序，单独拎出来放到最后一步，和使能Output一起执行

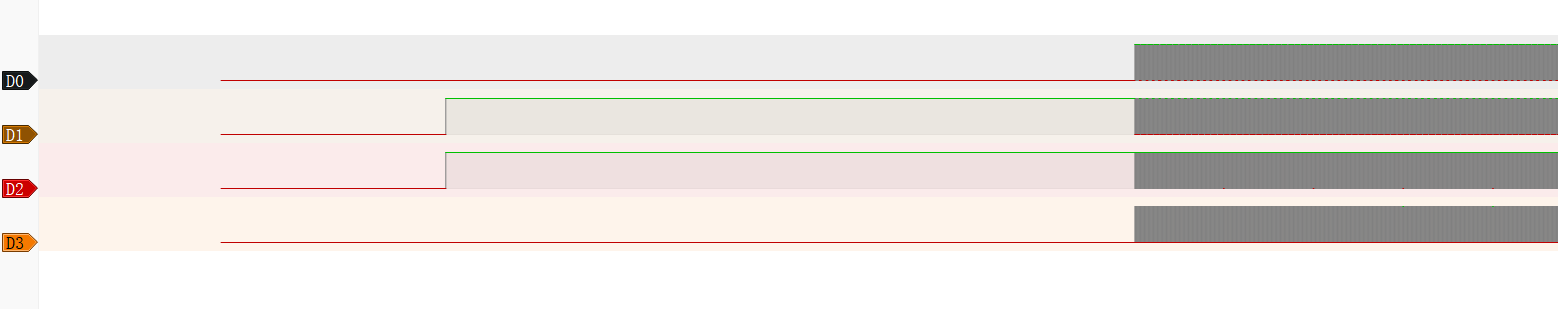
[picture p33: 图片/Markdown图片/45OUT1.png]

<center>异常输出</center>

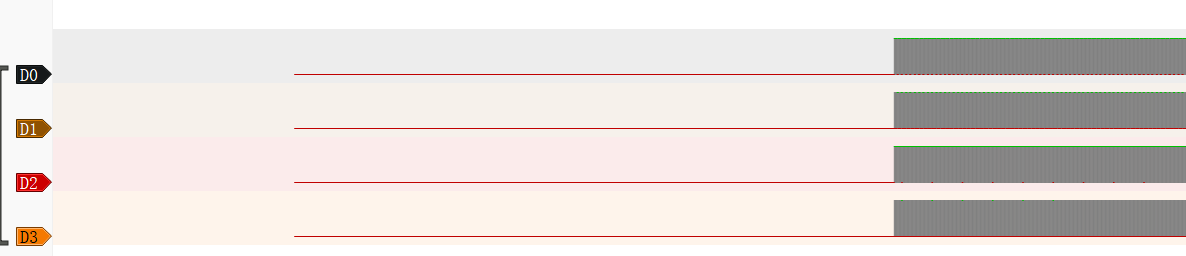
[picture p34: 图片/Markdown图片/46OUT2.png]

<center>正常输出</center>
<br><br>

***

####  __ADC__

ADC配置为HRTIM的master period触发，按照HRTIM的配置，应该是采样点设置在Boost上管开启的中点，理论上可以较准确的避开MOS开关和电感充放电时的电流电压波动。

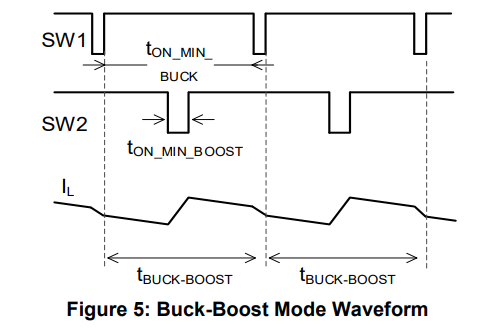
[picture p35: 图片/Markdown图片/48IL.png]

<center>电感电流</center>
<br><br>

采样配置上采用了比较特殊的规则，设置rank数为5并开启scan mode，开启discontinuous mode并设置为1 rank，即每次ADC触发时只采样转换1个通道，具体功能如下

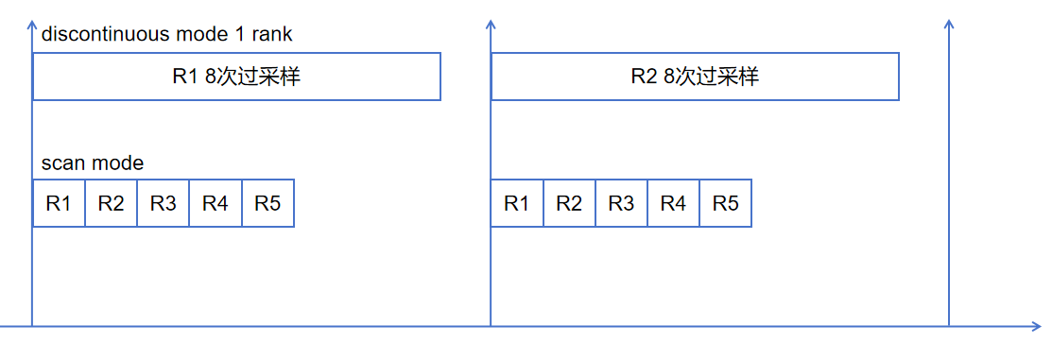
[picture p36: 图片/Markdown图片/49ADC.png]

<center>ADC采样</center>
<br><br>

这种配置的好处在于可以兼顾regular通道的scan功能并使用DMA自动传输，同时开启过采样功能提高ADC的ENOB，最终效果就是稍微加点软件滤波后，可以实现电压采样0.01V@0~35V和电流采样0.02A@±30A左右的精度，接近12bits的理论值，代价就是5次ADC触发才有1次DMA传输和计算，实际上采样更新频率是20KHz。改进方法就是把对应输入电流采样的PA1引脚从ADC1_IN1改为ADC2_IN2并配置ADC2，对功率控制最重要的输入电流独享100KHz更新，理论上可以提高控制响应速度。暂时还没有比较评估开启ADC2的必要性。

***

####  __其他外设__

FDCAN没什么好说的，时序算一算再开AutoRetransmission就行，filter很有用但是没开，等电控组的主控配好了再抄。

***

### __控制部分__

#### __Debug模式和拟合计算__

在BuckBoostController.cpp有debug_flag和debug_check_flag两个调试开关。设置debug_flag为true可以启用固定占空比调试模式，输出电压受debug_pwm_set控制（范围为29000到12500，在24V输入下对应输出电压为3.5V到25.2V左右）。设置debug_check_flag为true控制关闭掉电检测功能。

在新板子焊好后，设置debug_pwm_set为29000，开启两个调试开关后编译下载代码，重新上电后如果一切正常，可以测得输出电压为3.5V，可以开始拟合ADC和控制部分参数。

ADC部分需要拟合5个参数，输入电压、输出电压、BAT输入电流，DCDC输入电流，电容输出电流。每个参数取5个点位（例如输入电压取22.00V、23.00V、24.00V、25.00V、26.00V），使用$y = a*x+b$ 进行拟合，$y$为实际值，$x$为ADC读数滤波后测量值。在测试记录中有某次拟合测试的Mathematica文件PDF版，用python、excel或者其他什么软件工具都可以。

除了拟合ADC部分，还要拟合占空比和输入电压、输出电压的3个公式，都是$f(a,b)=c$，分别为$f(\eta，V_{in})=V_{buckout}、f(\eta，V_{in})=V_{boostout}、f(\Delta V_{out},V_{in})=\Delta \eta$，前两个分别用于直接计算最低电压和最高电压对应占空比，只算一个公式也行，另一个计算会有0.1V左右误差。最后一个公式目前没有实装，需要配合功率的前馈控制使用，至少要等到26赛季联盟赛实际上车测试后才会更新。这种多参数的拟合方法和ADC基本相同，详细过程在南方科技大学2024年开源技术报告里有，这里不再赘述。

***

#### __闭环控制__

闭环控制部分比较简单，过完初始化后，有限状态机里放了两个状态模式，输入功率控制模式实际上是输入电流控制，输出电流控制模式实际上是动态输出功率控制，这样两套PID的参数基本相同。具体计算过程中的正负号不要动，示波器接电流探头简单调调PID就行。

有限状态机里每个状态有4个函数，Init()，Enter()，Execute()，Exit()，其中Init()在Controller::Init()中执行，Execute()在Controller::Update()中buckBoostFsm.Update()执行，当发生ChangeState()时，先执行上一个状态的Exit()，然后马上执行当前状态的Enter()。理论上可以把很复杂的机器人控制行为分解成很多个状态相互组合，在超电控制上有点大炮打蚊子。

目前开源部分的代码只是在可调电源和电子负载上进行过测试，实际上车效果无法完全保证，预计12月底可能会更新一版实装前馈计算和完整板间通信的版本。

***

#### __Buck与Buck-Boost与Boost切换__

在实现近似上管常开的过程中，也遇到了和港科24开源一样的问题，在Buck上管常开切换到Boost上管常开的过程中（或者反向切换），不可避免的出现电压跳变。解决方法就是添加一个Buck-Boost中间状态，微调两个半桥的占空比实现电压平滑过渡。具体代码在bsp_hrtim_set中。同时还包含了Burst mode的调节。

***

##  __测试纪录__

###  __供电纹波__

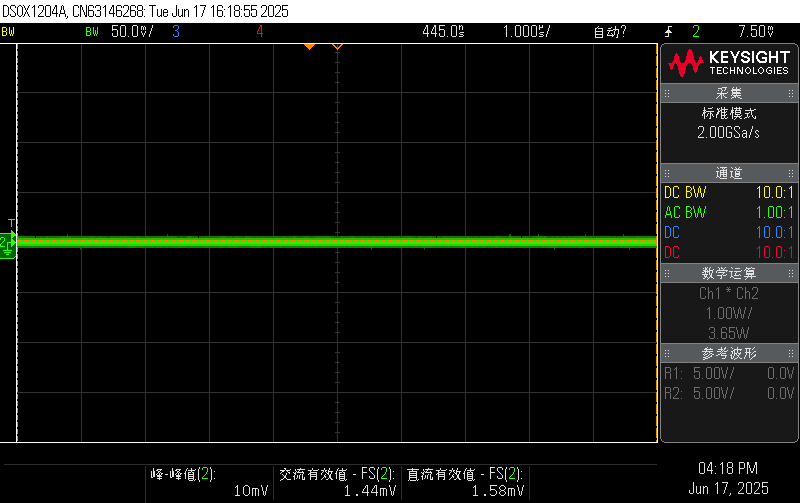
[picture p37: 图片/示波器截图/纹波/底噪.png]

<center>底噪</center>

<br><br>

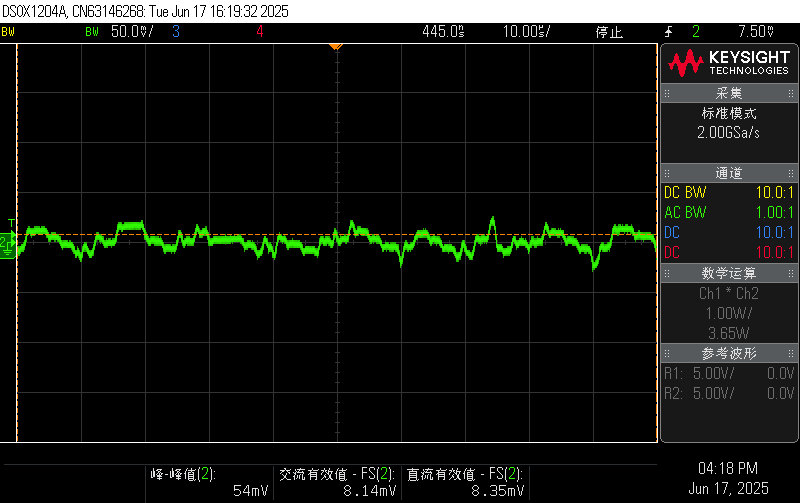
[picture p38: 图片/示波器截图/纹波/10V.png]

<center>10V输出电容</center>

<br><br>

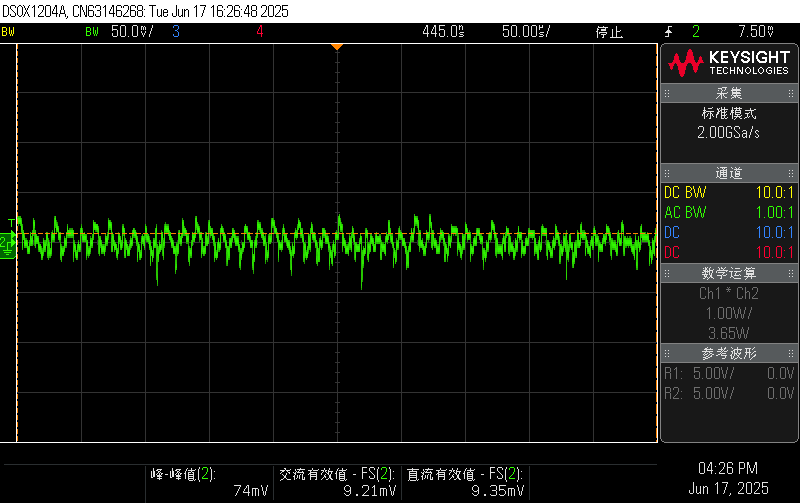
[picture p39: 图片/示波器截图/纹波/10V栅极驱动滤波电容.png]

<center>10V栅极驱动滤波电容</center>

<br><br>

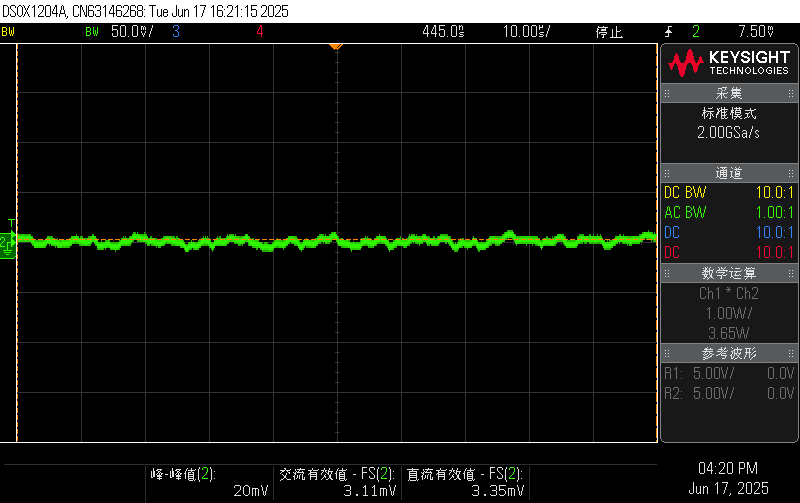
[picture p40: 图片/示波器截图/纹波/5V.png]

<center>5V输出电容</center>

<br><br>

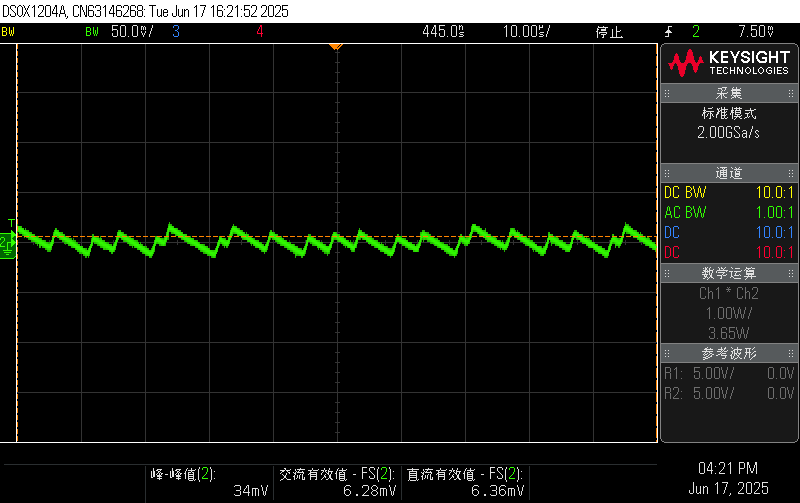
[picture p41: 图片/示波器截图/纹波/D3V3.png]

<center>D3V3输出电容</center>

<br><br>

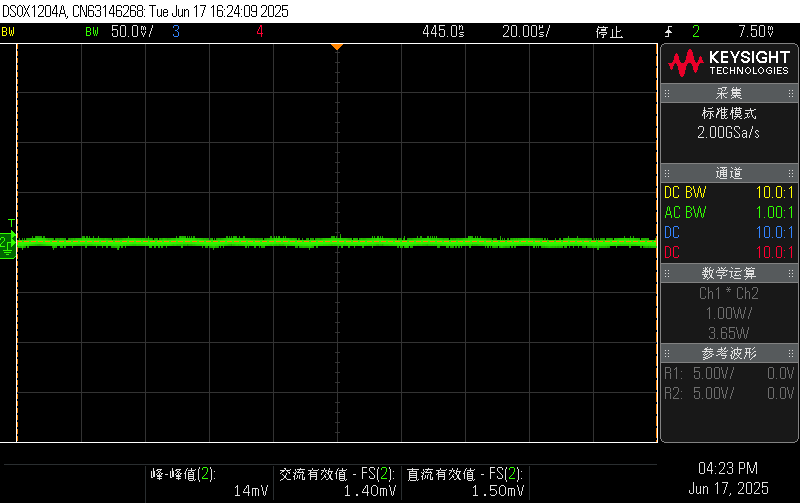
[picture p42: 图片/示波器截图/纹波/A3V3.png]

<center>A3V3输出电容</center>

<br><br>

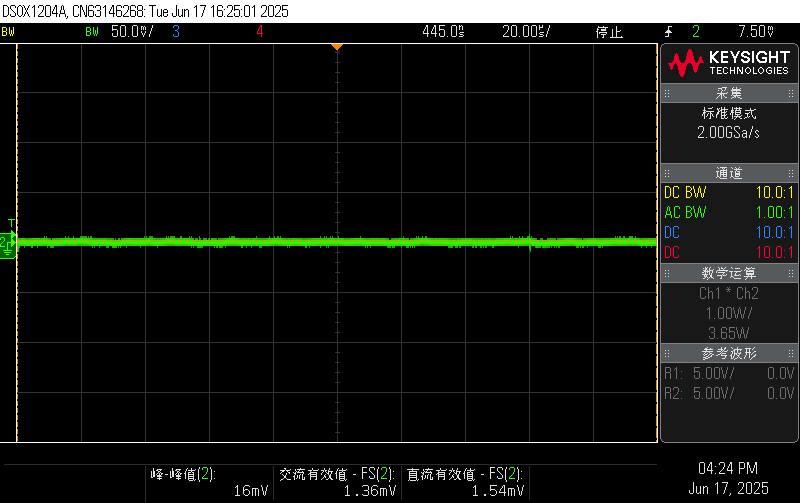
[picture p43: 图片/示波器截图/纹波/3V.png]

<center>3V参考电压输出电容</center>

***

###  __栅极驱动__

以下测试均为旧版代码，新版代码尚未完全测试

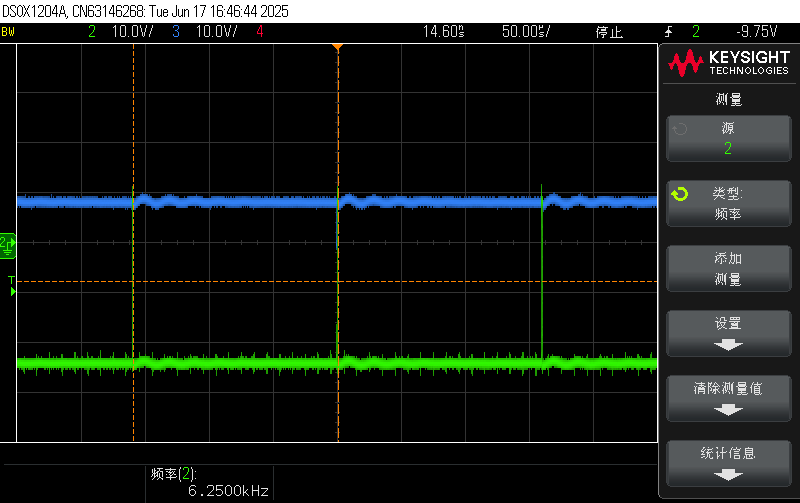
[picture p44: 图片/示波器截图/栅极驱动/Buck1.png]

<center>Buck多周期</center>

<br><br>

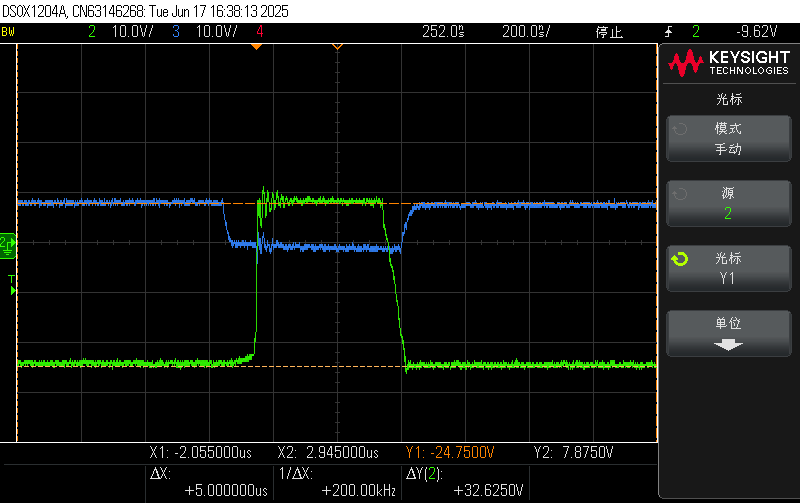
[picture p45: 图片/示波器截图/栅极驱动/Buck2.png]

<center>Buck单周期</center>

<br><br>

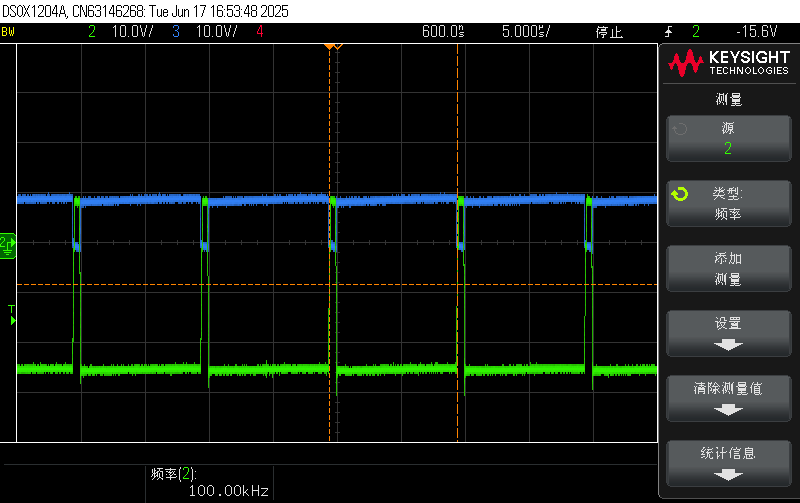
[picture p46: 图片/示波器截图/栅极驱动/Boost1.png]

<center>Boost多周期</center>

<br><br>

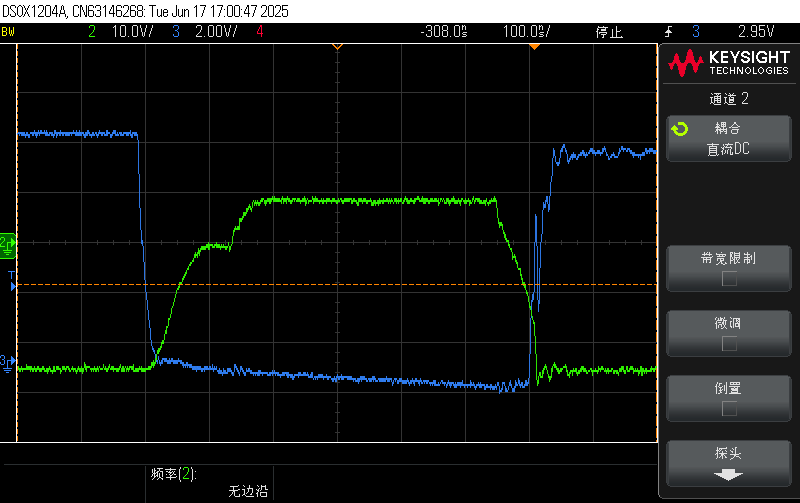
[picture p47: 图片/示波器截图/栅极驱动/Boost2.png]

<center>Boost单周期</center>

***

###  __SW振荡__

***

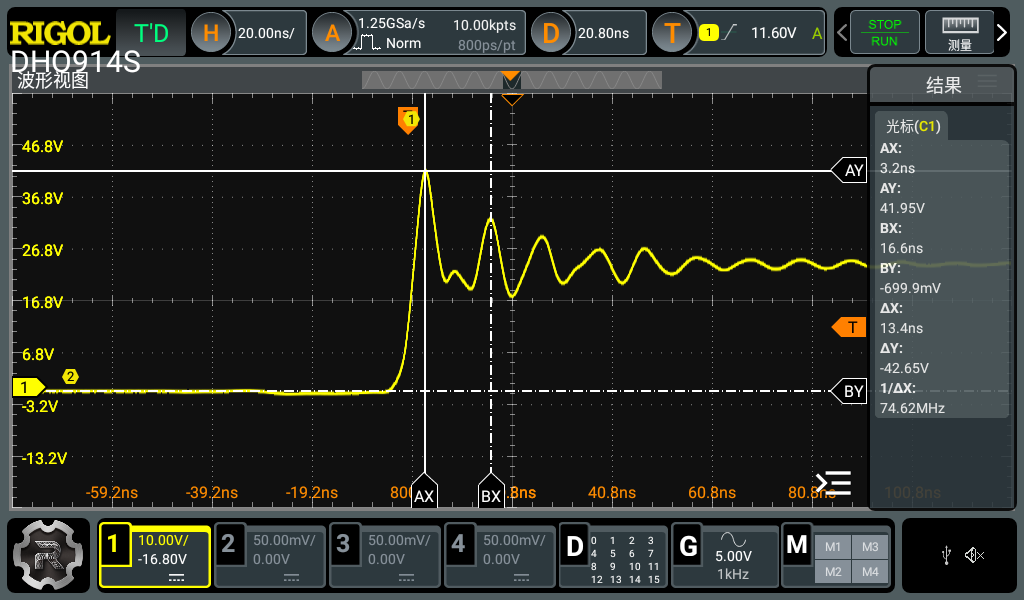
[picture p48: 图片/示波器截图/SW节点/4.1.png]

<center>GaN 4.1版本不加C0G</center>

<br><br>

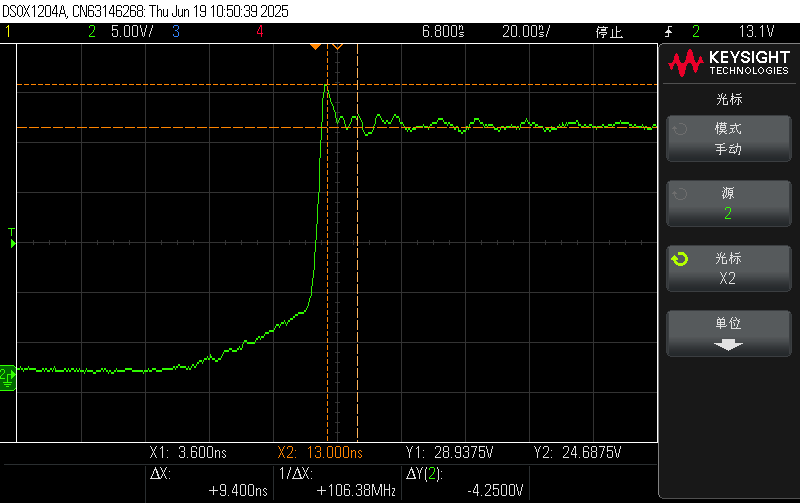
[picture p49: 图片/示波器截图/SW节点/5.5.png]

<center>5.5版本加C0G</center>

***

###  __自举电容__

***

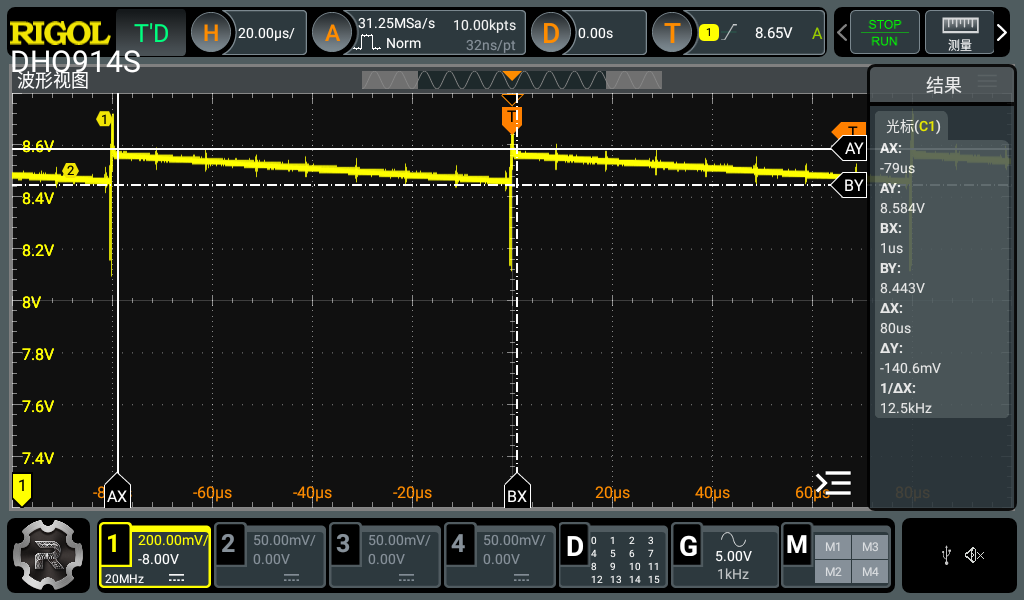
[picture p50: 图片/示波器截图/自举电容/D8.png]

<center>8分频</center>

<br><br>

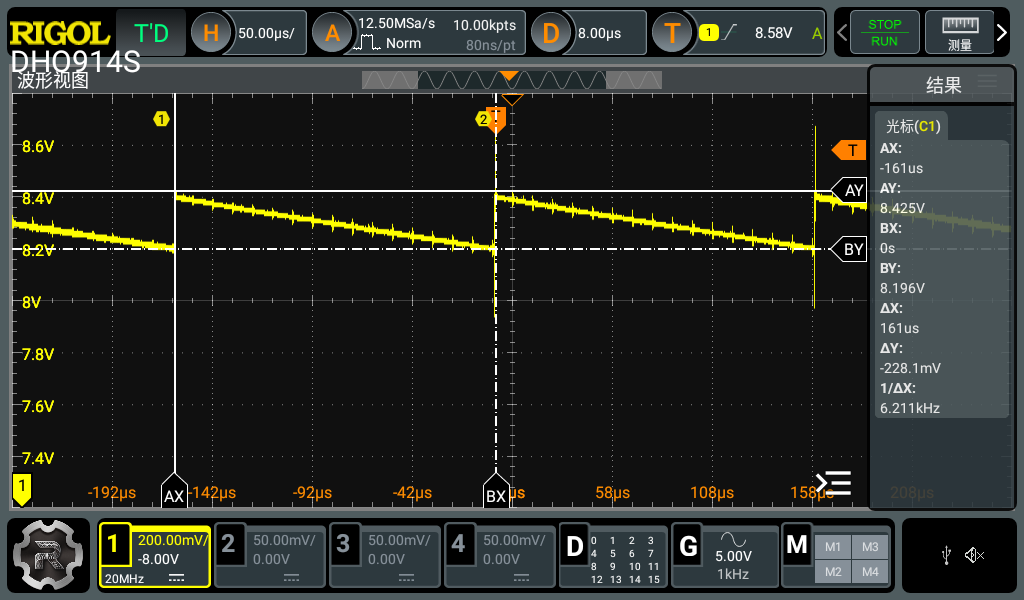
[picture p51: 图片/示波器截图/自举电容/D16.png]

<center>16分频</center>

<br><br>

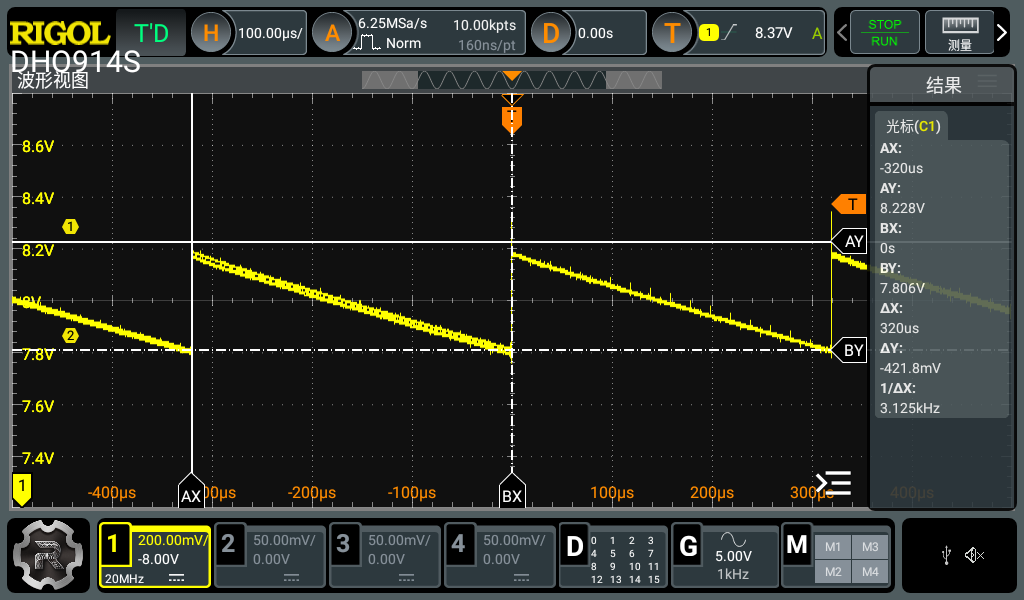
[picture p52: 图片/示波器截图/自举电容/D32.png]

<center>32分频</center>

<br><br>

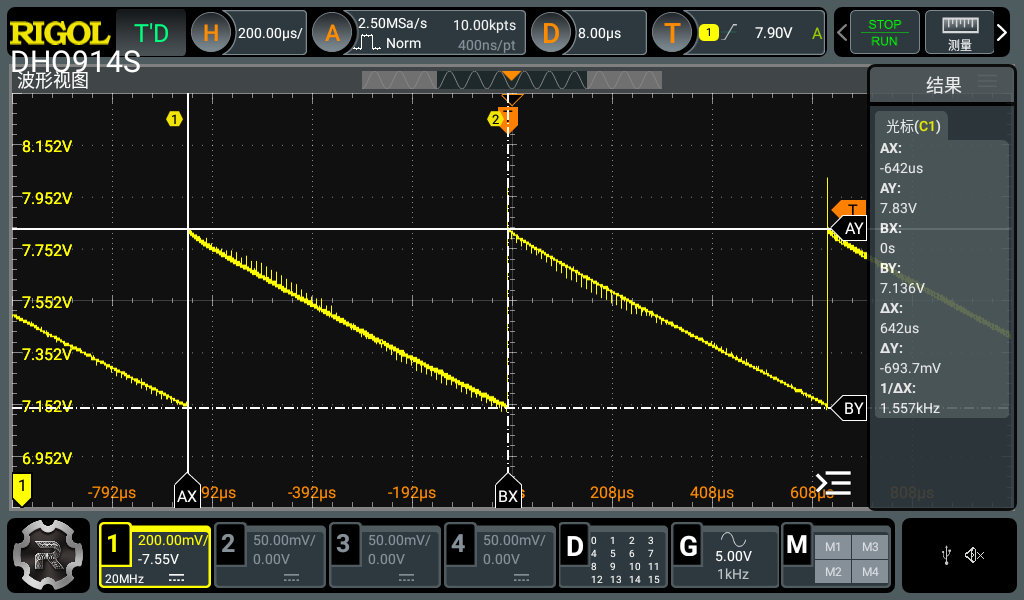
[picture p53: 图片/示波器截图/自举电容/D64.png]

<center>64分频</center>

<br><br>

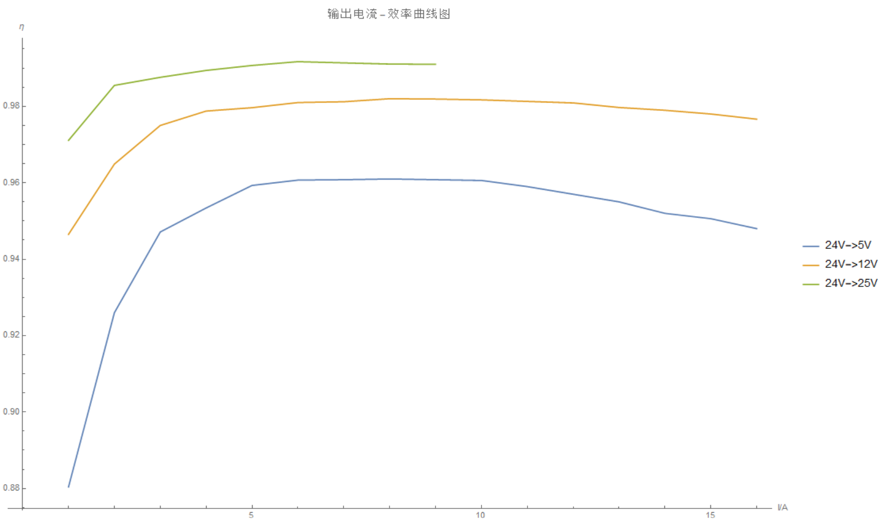
[picture p54: 图片/Markdown图片/32效率.png]

<center>转换效率图</center>

***

##  __加工焊接测试流程__

本项目的PCB集成度较高，大量使用小封装或不好焊接的元器件，焊盘上到处是过孔，焊接难度非常大，5.4和5.2的成品率只有80%，5.5在改小尺寸和换0402后更难，推荐使用SMT贴+热床+热风枪+电烙铁的组合进行焊接，第一块板子焊一点测一点。确认第一块焊接测试无误后，可以批量焊接测试。

***

### __PCB+SMT加工要求__

嘉立创SMT经济贴对PCB有隐藏要求，只能用全默认（四层FR4、1.6mm厚、7628层压、绿色、外层1Oz 内层0.5Oz），理论上 1.2mm厚、3313层压、外层2Oz 内层1Oz的性能会更好，但是每个选项都要加钱，超电一个赛季就发不到20片，难以平摊成本。沉金可用可不用，焊接前沉金板保质期长，喷锡板需要放干燥柜内保存，焊接后都一样。

SMT经济贴的优势是基础库免换料费，常规容组在基础库内都可以找到，一些非常规物料（高精度低温飘电阻之类）如果用量大也可以贴，一个型号加20元换料费分摊到每个器件上用不了几毛钱。标准贴太贵了暂不考虑。

在不考虑16-15券、免费打样券、SMT券等优惠的情况下，10块超电的PCB+SMT+物料的费用约为150元。具体物料在工程文件/发加工文件下。

***

### __焊接测试顺序__

使用SMT经济贴或者纯手焊的焊接顺序基本相同，基本遵循先小后大、先低后高、先简单后复杂的原则，但是部分元器件焊接涉及到工具切换需要专门说明。本战队使用BK811风枪焊台+BK946恒温加热台+鹿仙子主板夹具，焊锡膏为凯利顺183℃中温有铅锡浆，助焊剂为维修佬X6。如果有条件可以换个好点的风枪，万用表换特尖头，电烙铁换刀头。

<br><br>

第一步，使用热风枪+夹具，正面24V降10V、10V降5V、电池端XT30焊接。焊接后测试24V、10V、5V是否短路。
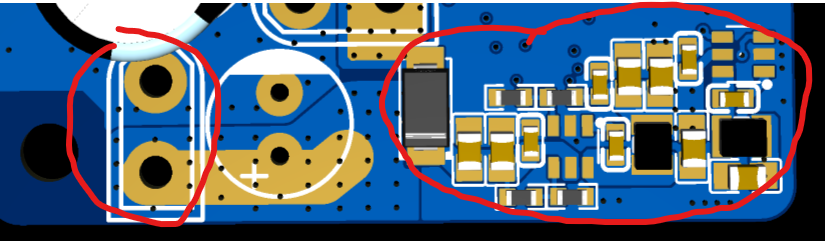
[picture p55: 图片/Markdown图片/26焊接1.png]


<br><br>

第二步，使用热风枪+夹具，背面5V降D3V3、5V降A3V3、A3V3降3V，电池端采样电阻、0Ω接地电阻焊接。焊接后测试D3V3、A3V3、3V是否短路。如果第一步第二步均正常，可调电源设置为24V 0.2A上电测试，测量24V、10V、5V、D3V3、A3V3、3V电压。
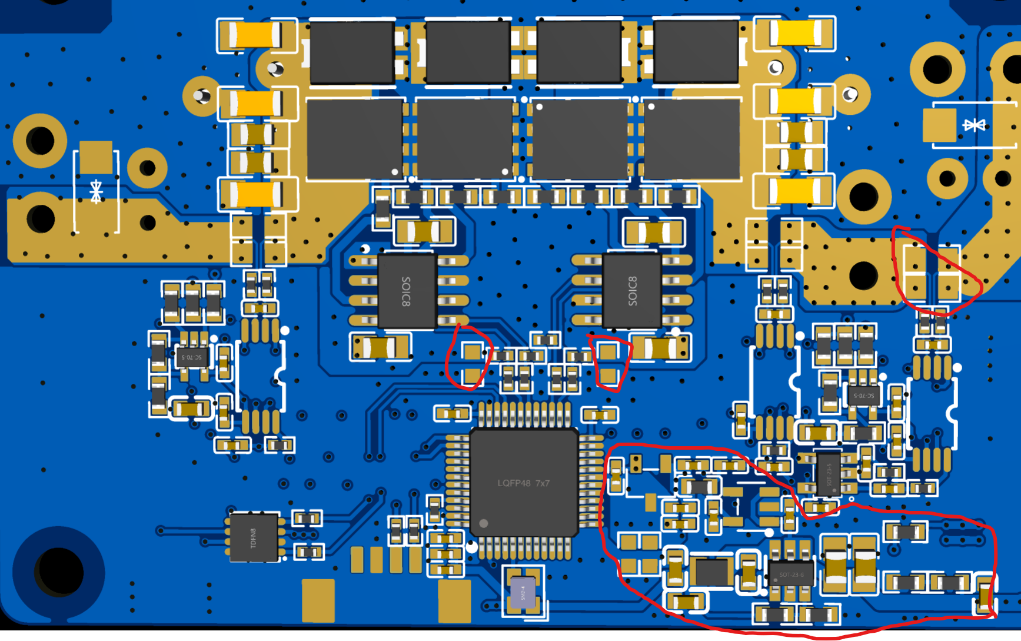
[picture p56: 图片/Markdown图片/27焊接2.png]


<br><br>

第三步，使用热风枪+夹具，背面其余采样电阻、模拟部分焊接。上电测量模拟部分输出电压。
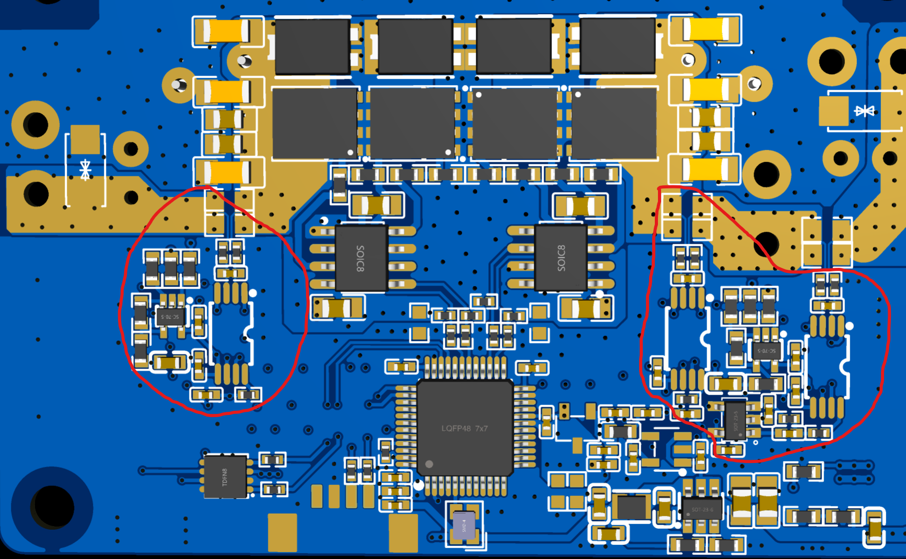
[picture p57: 图片/Markdown图片/28焊接3.png]


<br><br>

第四步，使用热风枪+夹具，背面正面MCU部分焊接，换电烙铁用助焊剂和拖锡法清理MCU引脚上多余锡（如果担心正面的GH1.25座不好焊，可以在第一步用加热台预热+风枪）。代码切换为test模式（固定占空比、无保护），烧录后在Keil Debug模式下观察ADC采样值是否符合测量值，使用示波器观察HRTIM输出波形是否正常、观察CAN波形是否正常。
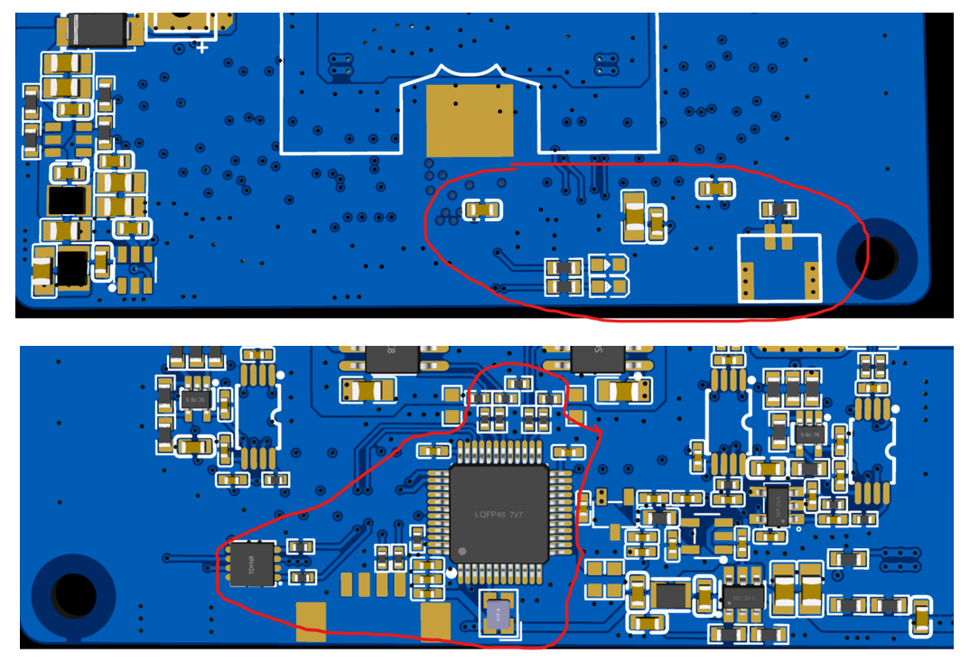
[picture p58: 图片/Markdown图片/29焊接4.png]


<br><br>

第五步，使用热风枪+夹具，背面栅极驱动焊接。上电观察可调电源功率（正常应该不到0.5W），示波器观察各个栅极波形。
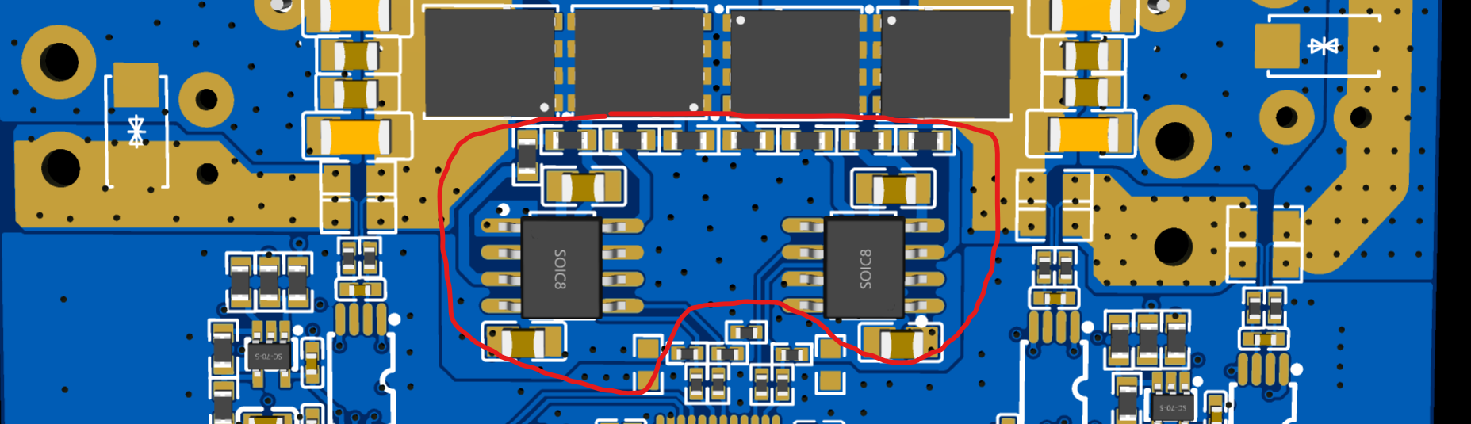
[picture p59: 图片/Markdown图片/30焊接5.png]


<br><br>

第六步，<span style="color: red;">注意</span>此步使用了不推荐的非常规方法，常规热风枪或者电烙铁拖锡因为导热太快而难以正常焊接。加热台调至220℃，使用如图所示的手法（因为已经焊了一个XT30，无法全部放上加热台），背面MOS、电容和二极管焊接，等待冷却至室温后，万用表切二极管档，测量Vboost和SW、Vbuck和SW之间正向反向压降。
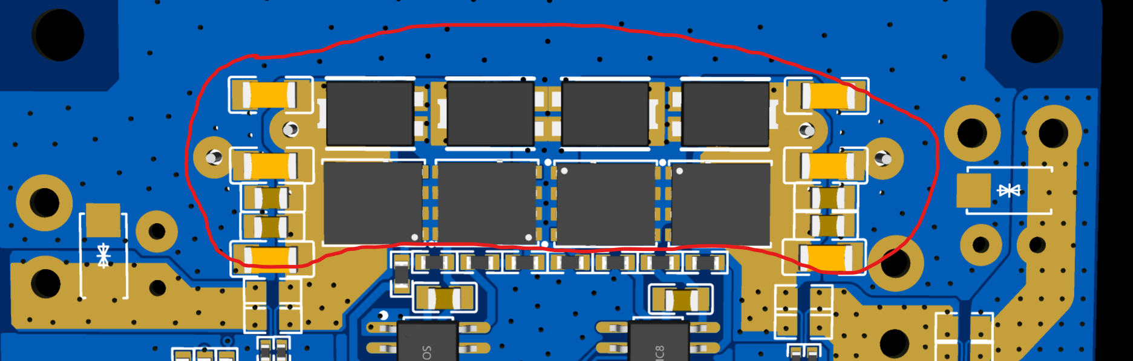
[picture p60: 图片/Markdown图片/31焊接6.png]

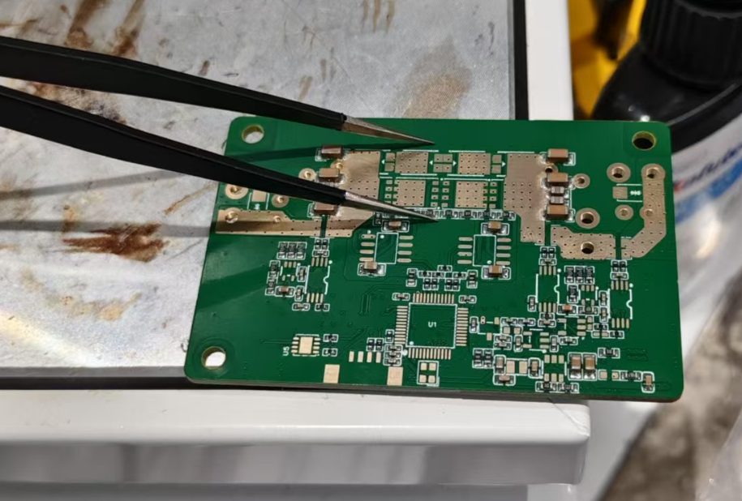
[picture p61: 图片/Markdown图片/32焊接7.png]


<br><br>

第七步，<span style="color: red;">注意</span>焊接电感时导热散热能力过强，需要加热台或者热风枪辅助。使用电烙铁，焊接插件电容、大电感、输入输出TVS、剩余XT30，测量XT30端是否短路，上电观察可调电源功率（正常应该不到1W），万用表测量电容端电压（Test模式代码正常应该3.5V左右），可调电源设置为24V 1A，电容端接电子负载测试5A CC是否正常。

***

##  __问答讨论__

1.为什么搞这么复杂？

答：5.5版本为23赛季、24赛季和25赛季近两年半迭代的最终产物，实际上24赛季联盟赛版本非常简陋，迭代过程中在原理图电路和PCB上增加了很多没有广泛使用的试验型设计，不是很推荐完全照抄开源版本，最好根据自身需求选择性使用。

2.为什么没有使用多相、电荷泵、隔离电源之类的设计？

答：有尝试过倍相芯片+DrMOS，测试性能不佳，结合理论计算和其他学校开源测试结果，多相设计没有明显优点（最大功率受限于超电管理模块电流限制），而在空载静态功耗上相对偏大。隔离电源和电荷泵都会导致更复杂的电路和更大的静态功耗（相对于纯软件方法）。

3.未来的优化方向大概在哪里？

答：在规则修改容组最大容量和超电管理模块最大电流前，超电的最大功率和最大电流没有进一步提高的意义，未来重点优化方向在和底盘控制、动能回收、无线充电的适配上。

***

##  __版本迭代__

 版本号 | 内容 | PCB发加工时间 |
| :-----:| :----: | :----: |
| 1.0 | 参考21年版本，换G474，MOS双管并联，霍尔电流采样。炸了，怀疑是UCC27211问题 | 2023-08-16 |
| 2.0 | 栅极驱动换EG3014S，MOS换TO-252。发现PGND和GND连接有问题（上了个共模电感），飞根粗线后正常，性能一般 | 2023-09-01 |
| 3.0 | 重画24V降12V部分（换LGS5148），栅极驱动换SLM27211，换普通DFN5*6 MOS，电压采样换差分运放，电流采样换INA240A2，感觉画出来可能没用，PCB没画完 | 无 |
| GaN 4.0 | 3.0的供电和采样，ISG3201合封半桥，3.0和GaN4.0之间画了2板炸完了，确定一定要加4个续流二极管 | 2023-11-23|
| GaN 4.1 | 输入输出电容多塞2个4.7nF 0805 C0G MLCC和1个3.3nF 0603 C0G MLCC，改善SW波形。24联盟赛上车版本，焊了3块，重庆站预检录前10分钟推车炸了1块，剩的2块全装车上打完联盟赛 | 2024-01-14|
| GaN 5.0 | 换4层板大幅缩尺寸，LCEDA标准版卡爆了换专业版，尝试分割PGND、GND、AGND，上REF3030作为参考电压，开关频率提高到300KHz，电感换6.8uH，只焊了1块作为测试 | 2024-04-22 |
| GaN 6.0&GaN 6.1 | 换分立GaN HEMT(INN100FQ025A)，尝试按英诺赛科的layout指导，做内外层垂直功率回路，6.0封装错了，只焊了1块作为测试，感觉性能一般 | 2024-06-18 |
| 5.0 | 感觉GaN性价比太低，批量后没有前途，使用3.0的原理图 + GaN 6.1的layout设计，焊了1块，多次上电后炸了输入MLCC(纯手焊的歪歪扭扭，可能内部有应力，上电电压尖峰击穿短路) | 2024-07-08 |
| 5.1 | 前面的忘了，中间的忘了，后面的忘了，没画完| 无 |
| 5.2 | 紧急把输入输出的4.7uF 1206 MLCC 换成100uF 固态电容，MOS换HYG025N06LS1C2 ，电控新生培训某天推车炸了| 2024-07-22 |
| 5.3 | 前面的忘了，中间的忘了，后面的忘了，没画完| 无 |
| 5.4 | 发现GaN 4.1和5.2炸的原因，推车时底盘电机泵升电压启动了超电（LGS5148 4.5V启动），占空比计算错误然后MOS炸了，修改24V降10V EN电压到17V左右，电压采样换国产精密运放，MOS换CSD18540，单面经济贴，25联盟赛上车版本| 2024-11-21 |
| 5.5 | 加LGS5116B做5V降D3V3，和LDO的A3V3分离，采输入电流的INA240输出接运放二阶滤波，MCU的RBT6换CBT6，大部分0603电容电阻换0402，尺寸缩一圈，单面经济贴，25区域赛上车版本| 2025-03-14 |
|  | 更新外设配置和代码，已知问题：没有上车测试，没有实装前馈控制，输入电流采样噪声偏大，最高电压拟合公式有误差，板间通信部分还没有更新| 2025-10-22 |
