HKUSTGZ-ROBOMASTER-PNX/RM25_SC5.5_OpenSource/图片/时序和控制.pptx

SystemClock初始化

Multimeter(ADC) 初始化

25KHz Timer8 初始化

HRTIM 初始化
输出通道关闭

LED、CAN 初始化

FSM 初始化

SysTick 初始化

25KHz Timer8 使能

Controller 初始化

Controller控制常量计算

## Slide 2

HRTIM

Timer 8
Update中断

CAN1 接收中断

ADC1

Controller 更新

板间通讯更新

DMA1 TC中断

SysTick 中断

Multimeter更新

板间通讯发送

## Slide 3

更新输入电压并限幅

FSM更新
计算占空比

根据最高最低电压
计算占空比相对上下限

占空比相对上下限限幅

输入端掉电检测

占空比差值限幅

更新输入功率并限幅

占空比绝对上下限限幅

## Slide 4

更新电容端电压并限幅

更新输入功率和电容电流

更新输入功率和电容电压

占空比直接计算

正负过流检测

恒功率PID计算

正负电容端超功率检测

恒流PID计算

Busrt Mode开启
输出通道开启

切换恒功率模式

占空比更新

占空比更新

## Slide 5

discontinuous mode 1 rank

R1 8次过采样

scan mode

R2 8次过采样

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
