HKUSTGZ-ROBOMASTER-PNX/RM25_SC5.5_OpenSource/代码/README.md

# RM25_SCV5.5
RM25赛季超电V5.5以及之后版本固件
因为V5.5版本MCU从STM32G474RBT6更换为封装更小的STM32G474CBT6，引脚定义和外设配置有修改，与之前版本代码不通用
