HKUSTGZ-ROBOMASTER-PNX/RM25_SC5.5_OpenSource/测试记录/V5.5.pdf

In[13]:= Iin = {{16 360, 0.03917}, {16 630, 0.5113},
{16 913, 1.0413}, {17 270, 1.6896}, {17 595, 2.277}};
IDCin = {{16 306, 0.039 - 0.039}, {16 670, 0.63 - 0.039}, {17 013, 1.22 - 0.039}, {17 357, 1.81 - 0.039}, {17 705, 2.39 - 0.039}};
IOUT = {{16 879, 1}, {17 435, 2.0}, {17 995, 3}, {18 555, 4}};
Vin = {{22 073, 22}, {23 075, 23}, {24 086, 24}, {25 091, 25}, {26 094, 26}};
Vout =
{{3587, 3.5985}, {8111, 8.1043}, {11 127, 11.1089}, {20 187, 20.121}, {25 246, 25.160}};

In[5]:=
求拟合

FindFit[Vin, a * x + b, {a, b}, x]

Out[5]= {a → 0.000994232, b → 0.0551241}

In[6]:=
显示

Show[
绘制点集

ListPlot[Vin,
绘图样式

PlotStyle →
红色

Red],

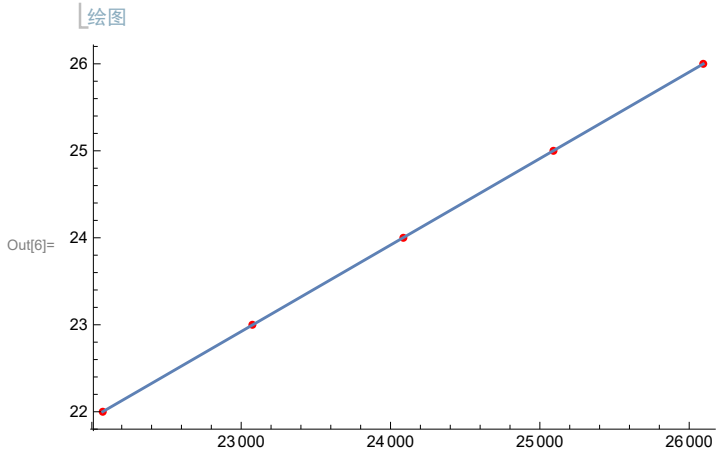
[picture p62: figure]
Out[6]=

Plot[a x + b /. {a → 0.000994232, b → 0.0551241}, {x, 22 073, 26 094}]]

In[7]:=
求拟合

FindFit[Vout, a * x + b, {a, b}, x]

Out[7]= {a → 0.000995368, b → 0.0301716}

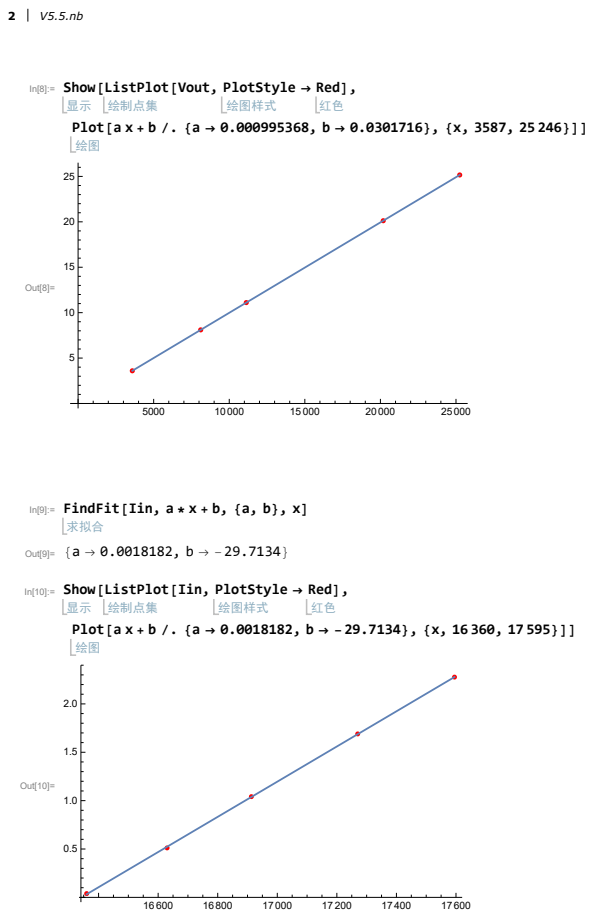
[picture p63: page 2]
Show[; 绘制点集; ListPlot[Vout,; 绘图样式; PlotStyle →; Red],; Plot[a x + b /. {a → 0.000995368, b → 0.0301716}, {x, 3587, 25 246}]]; Out[8]=; 求拟合; FindFit[Iin, a * x + b, {a, b}, x]; Out[9]= {a → 0.0018182, b → -29.7134}; ListPlot[Iin,; Plot[a x + b /. {a → 0.0018182, b → -29.7134}, {x, 16 360, 17 595}]]; Out[10]=

In[17]:=
求拟合

FindFit[IDCin, a * x + b, {a, b}, x]

Out[17]= {a → 0.00168764, b → -27.5283}

In[18]:=
显示

Show[
绘制点集

ListPlot[IDCin,
绘图样式

PlotStyle →
红色

Red],

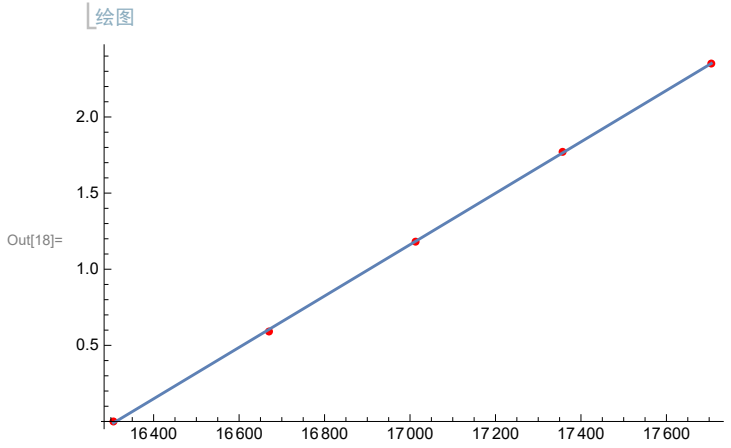
[picture p64: figure]
Out[18]=

Plot[a x + b /. {a → 0.00168764, b → -27.5283}, {x, 16 306, 17 705}]]

In[19]:=
求拟合

FindFit[IOUT, a * x + b, {a, b}, x]

Out[19]= {a → 0.00178954, b → -29.2036}

V5.5.nb 3

In[20]:=
显示

Show[
绘制点集

ListPlot[IOUT,
绘图样式

PlotStyle →
红色

Red],

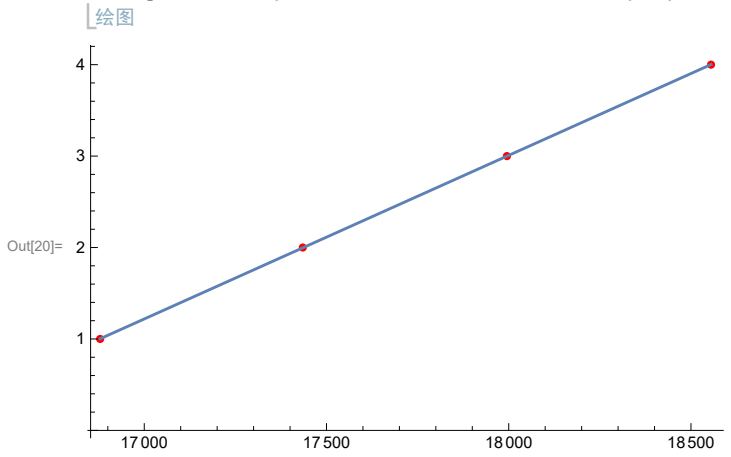
[picture p65: figure]
Out[20]=

Plot[a x + b /. {a → 0.00178954, b → -29.2036}, {x, 16 879, 18 555}]]

### 4 V5.5.nb
