HKUSTGZ-ROBOMASTER-PNX/RM25_SC5.5_OpenSource/图片/Markdown图片/18Buck.png

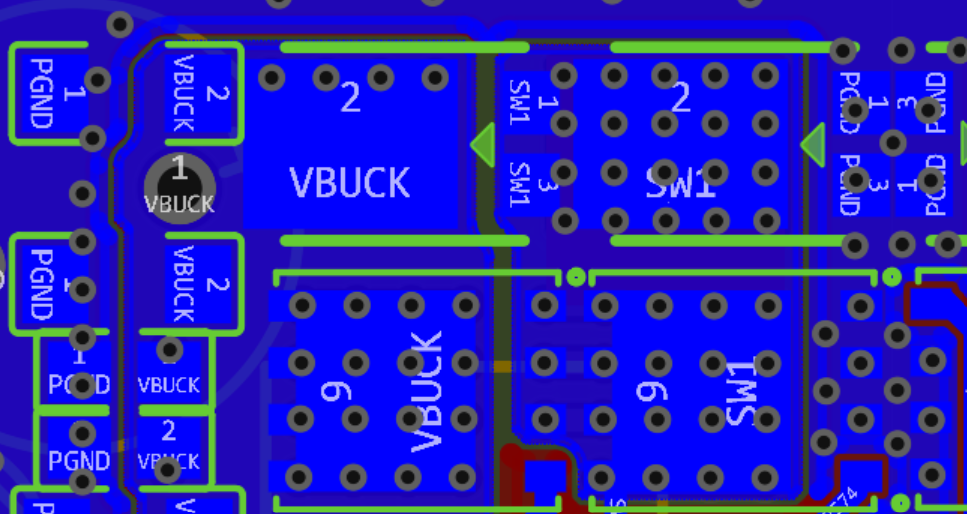
图片/Markdown图片/18Buck.png
