HKUSTGZ-ROBOMASTER-PNX/RM25_SC5.5_OpenSource/工程文件/发加工文件/BOM_G4SC5.5_PCB_G4SC5.5_2025-03-14.xlsx

No. | Quantity | Comment | Footprint | Manufacturer Part | Manufacturer | Supplier Part | Supplier | Symbol | Unique ID | Device | Primary Category | Secondary Category | JLCPCB Part Class | Designator | Name | Value
1 | 1 | 1MΩ | R0603 | 0603WAF1004T5E | UNI-ROYAL(厚声) | C22935 | LCSC |  | gge6 | 0603WAF1004T5E | 电阻 | 贴片电阻 | Basic Part | R65 | 1MΩ | 1MΩ
2 | 1 | 2.2kΩ | R0603 | 0603WAF2201T5E | UNI-ROYAL(厚声) | C4190 | LCSC |  | gge95 | 0603WAF2201T5E | 电阻 | 贴片电阻 | 基础库 | R80 | 2.2kΩ | 2.2kΩ
6 | 1 | 22uF | C0603 | CL10A226MQ8NRNC | SAMSUNG(三星) | C59461 | LCSC |  | gge94 | CL10A226MQ8NRNC | 电容 | 贴片电容(MLCC) | 基础库 | C128 | 22uF | 22uF
8 | 1 | 56kΩ | R0603 | 0603WAF5602T5E | UNI-ROYAL(厚声) | C23206 | LCSC |  | gge2 | 0603WAF5602T5E |  |  | Basic Part | R60 | 56kΩ | 56kΩ
9 | 1 | 100kΩ | R0603 | 0603WAF1003T5E | UNI-ROYAL(厚声) | C25803 | LCSC |  | gge31e3135edb69f0f2 | 0603WAF1003T5E |  |  | Basic Part | R47 | 100kΩ | 100kΩ
12 | 1 | 120Ω | R0603 | 0603WAF1200T5E | UNI-ROYAL(厚声) | C22787 | LCSC |  | ggefe89d0632cfce75f | 0603WAF1200T5E |  |  | Basic Part | R15 | 120Ω | 120Ω
29 | 2 | 1uF | C0805 | CL21B105KBFNNNE | SAMSUNG(三星) | C28323 | LCSC |  | gge26,gge27 | CL21B105KBFNNNE |  |  | Basic Part | C111,C112 | 1uF | 1uF
30 | 2 | 4.7kΩ | R0603 | 0603WAF4701T5E | UNI-ROYAL(厚声) | C23162 | LCSC |  | ggeba2c6d155e7fd301,ggefdc86a4b576d9e98 | 0603WAF4701T5E |  |  | Basic Part | R3,R4 | 4.7kΩ | 4.7kΩ
31 | 2 | 10nF | C0402 | CL05B103KB5NNNC | SAMSUNG(三星) | C15195 | LCSC |  | gge34,gge35 | CL05B103KB5NNNC |  |  | Basic Part | C30,C41 | 10nF | 10nF
32 | 2 | 10nF | C0603 | 0603B103K500NT | FH(风华) | C57112 | LCSC |  | gge4f4f44e0f3f4179e,ggeded7fa78bc7b56b3 | 0603B103K500NT | 电容 | 贴片电容(MLCC) | Basic Part | C10,C12 | 10nF | 10nF
33 | 2 | 10uF | C0805 | CL21A106KAYNNNE | SAMSUNG(三星) | C15850 | LCSC |  | gge28,gge29 | CL21A106KAYNNNE_C15850 |  |  | Basic Part | C113,C114 | 10uF | 10uF
34 | 2 | 22uF | C0805 | CL21A226MAQNNNE | SAMSUNG(三星) | C45783 | LCSC |  | gge92,gge93 | CL21A226MAQNNNE | 电容 | 贴片电容(MLCC) | 基础库 | C126,C127 | 22uF | 22uF
36 | 2 | 47kΩ | R0402 | 0402WGF4702TCE | UNI-ROYAL(厚声) | C25792 | LCSC |  | gge69,gge70 | 0402WGF4702TCE | 电阻 | 贴片电阻 | 基础库 | R78,R79 | 47kΩ | 47kΩ
38 | 2 | 330Ω | R0402 | 0402WGF3300TCE | UNI-ROYAL(厚声) | C25104 | LCSC |  | gge2c2bd6494a226445,gge9f0f69446307b72d | 0402WGF3300TCE |  |  | Basic Part | R18,R21 | 330Ω | 330Ω
39 | 2 | 330Ω | R0603 | 0603WAF3300T5E | UNI-ROYAL(厚声) | C23138 | LCSC |  | gge6f4c4beafd605d3e,ggea32210a39874d8f8 | 0603WAF3300T5E |  |  | Basic Part | R9,R14 | 330Ω | 330Ω
47 | 4 | 0Ω | R0603 | 0603WAF0000T5E | UNI-ROYAL(厚声) | C21189 | LCSC |  | gge35ead26b1f534b2d,gge504d78dd9c6bce36,gged95cef4c112fab61,ggee1ff5f341293d410 | 0603WAF0000T5E |  |  | Basic Part | R30,R31,R45,R46 | 0Ω | 0Ω
48 | 4 | 1Ω | R0603 | 0603WAF100KT5E | UNI-ROYAL(厚声) | C22936 | LCSC |  | gge2d766f40a4335307,gge5bf562507efcf1d7,ggee3d1fc734e2f54e5,ggee7981f979911b5a2 | 0603WAF100KT5E |  |  | Basic Part | R48,R49,R54,R55 | 1Ω | 1Ω
49 | 4 | 2.2nF | C0805 | CL21C222JBFNNNE | SAMSUNG(三星) | C28260 | LCSC |  | gge7c8b4ea4f5cd0e60,gge118d86ab78277960,gge235be86bb6fc1d7e,ggee6a2564287a8d074 | CL21C222JBFNNNE |  |  | Basic Part | C44,C45,C49,C51 | 2.2nF | 2.2nF
50 | 4 | 4.7kΩ | R0603 | RT0603BRD074K7L | YAGEO(国巨) | C513565 | LCSC |  | gge45,gge46,gge47,gge48 | RT0603BRD074K7L | 电阻 | 贴片电阻 |  | R70,R71,R72,R73 | 4.7kΩ | 4.7kΩ
51 | 4 | 4.7uF | C0402 | CL05A475MP5NRNC | SAMSUNG(三星) | C23733 | LCSC |  | gge7c674fedd66d7165,gge81bd40e117bce9fd,ggead7e9e1612356ddb,ggec9655d0faea7d93e | CL05A475MP5NRNC |  |  | Basic Part | C3,C8,C31,C32 | 4.7uF | 4.7uF
52 | 4 | 10uF | C0805 | GRM21BR61H106KE43L | muRata(村田) | C440198 | LCSC |  | gge9,gged2625f4b4bd439ef,gged2625f4b4bd439ef_1,ggedeb55bbe20a101cf | GRM21BR61H106KE43L |  |  | Basic Part | C19,C20,C26,C130 | 10uF | 10uF
53 | 4 | 51kΩ | R0603 | RT0603BRD0751KL | YAGEO(国巨) | C861458 | LCSC |  | gge49,gge50,gge51,gge52 | RT0603BRD0751KL | 电阻 | 贴片电阻 |  | R74,R75,R76,R77 | 51kΩ | 51kΩ
56 | 5 | 4.7kΩ | R0402 | 0402WGF4701TCE | UNI-ROYAL(厚声) | C25900 | LCSC |  | gge21,gge22,gge39,gge40,gge41bc0941336b1513 | 0402WGF4701TCE |  |  | Basic Part | R10,R56,R57,R68,R69 | 4.7kΩ | 4.7kΩ
58 | 6 | 4.7uF | C1206 | 1206B475K500NT | FH(风华) | C29823 | LCSC |  | gge7f35450ac3171d20,gge7f35450ac3171d20_1,gge7f35450ac3171d20_2,gge7f35450ac3171d20_3,gge7f35450ac3171d20_4,gge7f35450ac3171d20_5 | 1206B475K500NT |  |  | Basic Part | C50,C121,C122,C123,C131,C132 | 4.7uF | 4.7uF
59 | 6 | 10Ω | R0402 | 0402WGF100JTCE | UNI-ROYAL(厚声) | C25077 | LCSC |  | gge2a749333ff046792,gge8baa08d7e5aba54b,gge09b5d20ca7f211f8,ggeb194e0acfda1a6b2,ggec2b1ac93f1b829aa,ggef6ab9d224d8127a8 | 0402WGF100JTCE |  |  | Basic Part | R32,R33,R34,R35,R36,R38 | 10Ω | 10Ω
60 | 7 | 10kΩ | R0603 | 0603WAF1002T5E | UNI-ROYAL(厚声) | C25804 | LCSC |  | gge4fa47d9933b7f325,gge6c3f7c8647f8fdaa,gge6d8c533e5000f77b,gge14,gge96,gge04567ddb9a74dded,ggee408a3475b5e99c3 | 0603WAF1002T5E |  |  | Basic Part | R17,R50,R51,R52,R53,R64,R81 | 10kΩ | 10kΩ
61 | 8 | 33Ω | R0402 | 0402WGF330JTCE | UNI-ROYAL(厚声) | C25105 | LCSC |  | gge0e69257913149112,gge0e69257913149112_1,gge23,gge24,gge37,gge38,ggefa394caafc8878d8,ggefa394caafc8878d8_1 | 0402WGF330JTCE |  |  | Basic Part | R1,R2,R58,R59,R66,R67,R82,R83 | 33Ω | 33Ω
62 | 11 | 100nF | C0603 | CC0603KRX7R9BB104 | YAGEO(国巨) | C14663 | LCSC |  | gge1,gge4,gge4ecb0e327d389b20,gge5bc8fc857418e778,gge12,gge26a39bcafcc8ce7c,gge89,gge91,gge650bdd21373e6b88,gged9d0285421fe3ef0,gged99985aa138ce050 | CC0603KRX7R9BB104 |  |  | Basic Part | C13,C14,C15,C17,C18,C21,C24,C25,C27,C124,C125 | 100nF | 100nF
63 | 17 | 100nF | C0402 | CL05B104KO5NNNC | SAMSUNG(三星) | C1525 | LCSC |  | gge1d5760b797ec8f9e,gge8,gge10,gge13a89193d8b1553f,gge40b9579d8b7007e5,gge43,gge44,gge502f502ad563d68c,gge31805176722bbd0a,ggea2c5d49bc5dde298,ggeb4693cfd16d534cd,ggecc1d00c51cc12124,ggecc82bf2c2e22e605,gged297efe67d2e4f89,ggeddb24290f1520f2b,ggeec3dca617b0ff934,ggeec3dca617b0ff934_1 | CL05B104KO5NNNC |  |  | Basic Part | C1,C2,C4,C5,C6,C7,C29,C33,C34,C36,C37,C38,C39,C40,C116,C117,C120 | 100nF | 100nF
