HKUSTGZ-ROBOMASTER-PNX/RM25_SC5.5_OpenSource/工程文件/原理图和PCB/SCH_G4SC5.5_2025-06-03.pdf

MCU | MCU外围电容 | MCU复位和BOOT

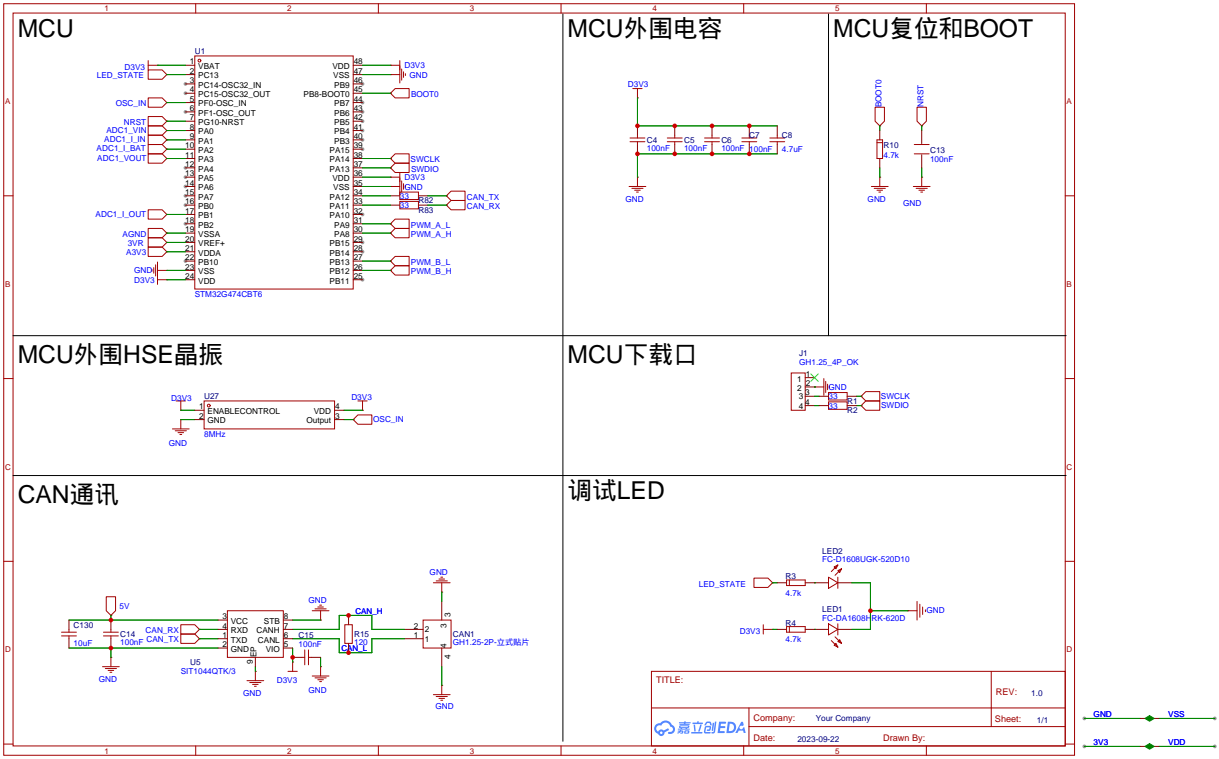
[picture p69: page 1]

# 24V降10V

# 5V降D3.3V

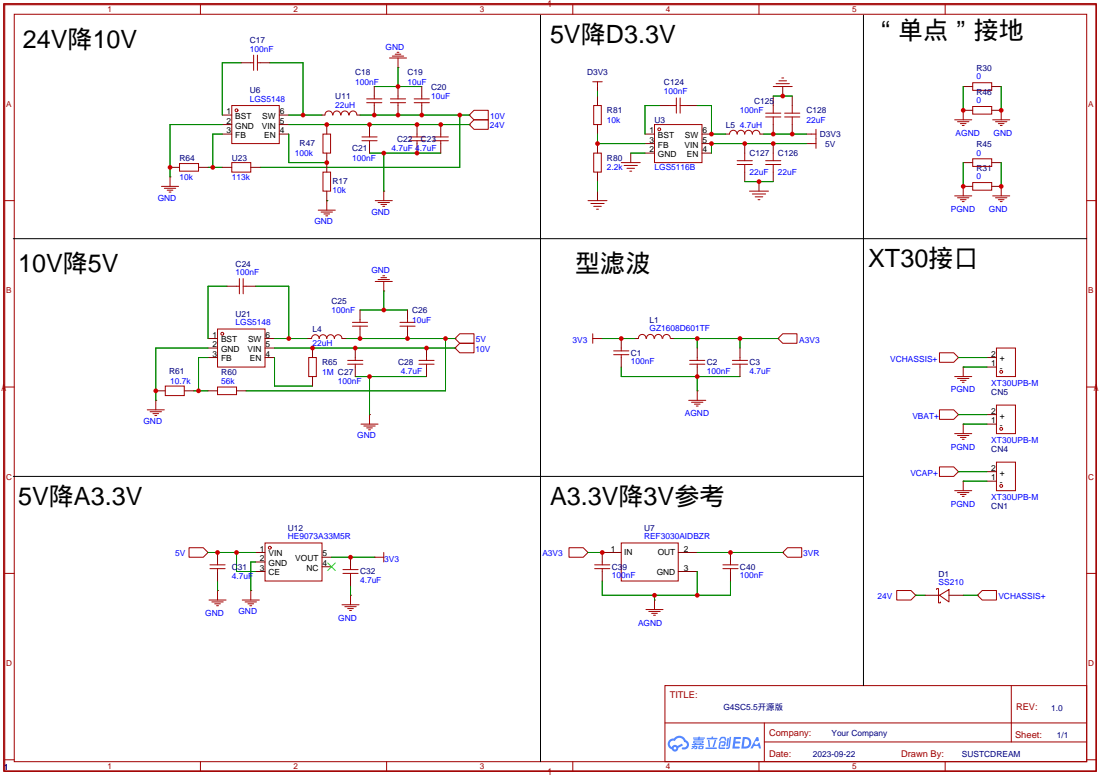
[picture p70: page 2]

# BUCK-BOOST

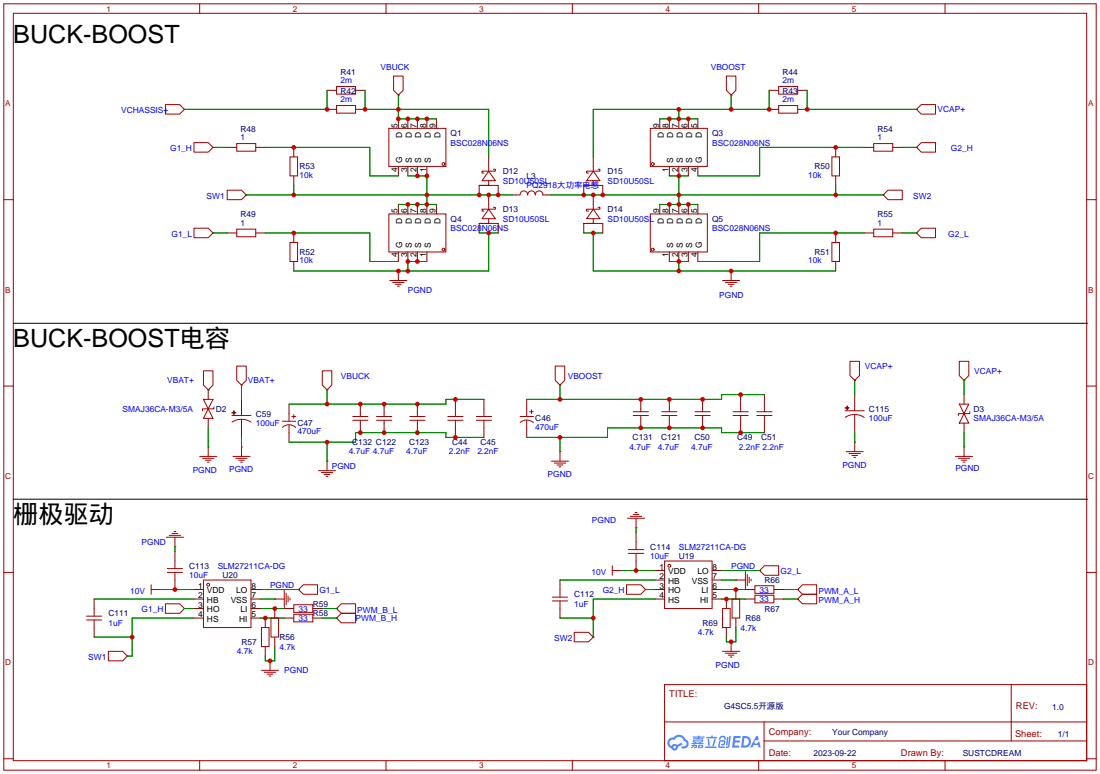
[picture p71: page 3]

# AGND A³V³

输出电压差分采样 | 输入电压差分采样 | 输入电流二阶低通

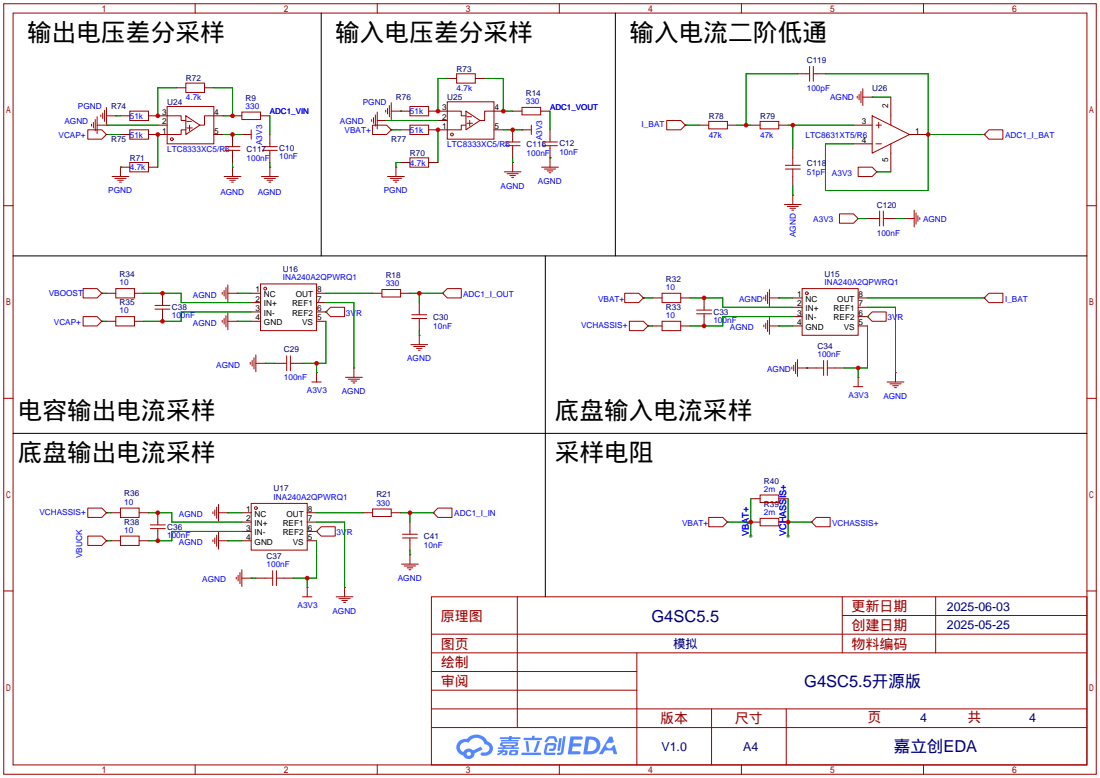
[picture p72: page 4]
