HKUSTGZ-ROBOMASTER-PNX/RM25_SC5.5_OpenSource/工程文件/位号图/G4SC5.5底面.pdf

D2

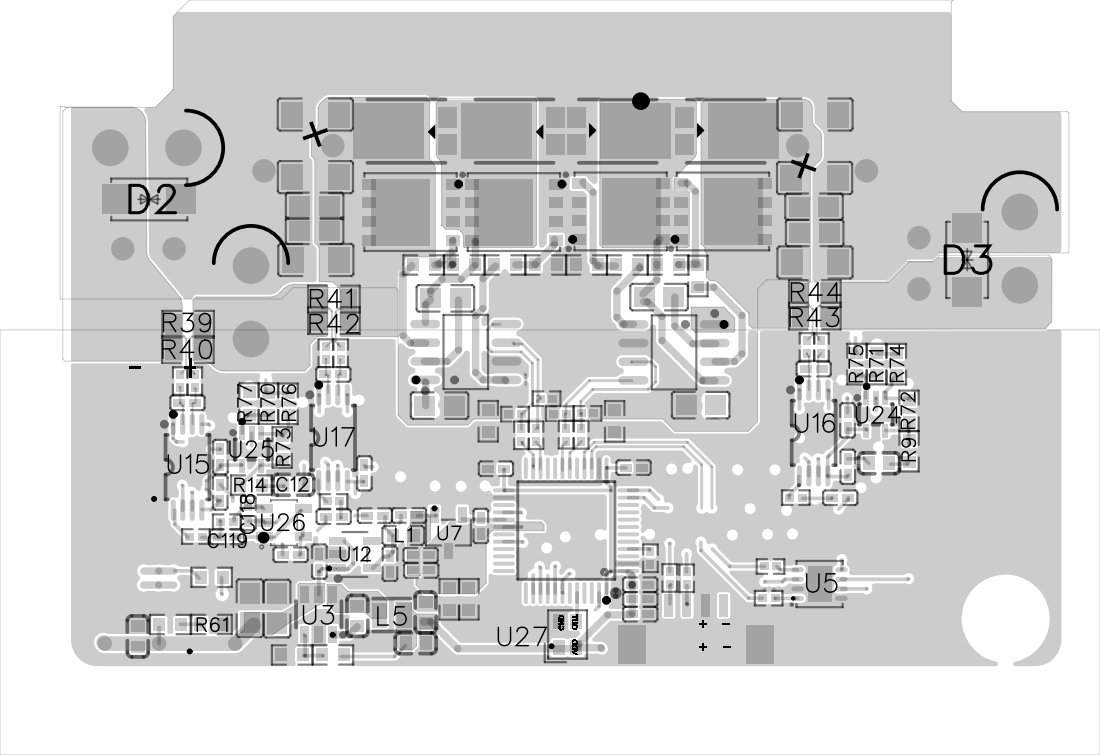
[picture p73: page 1]
