HKUSTGZ-ROBOMASTER-PNX/RM25_SC5.5_OpenSource/工程文件/位号图/G4SC5.5顶面.pdf

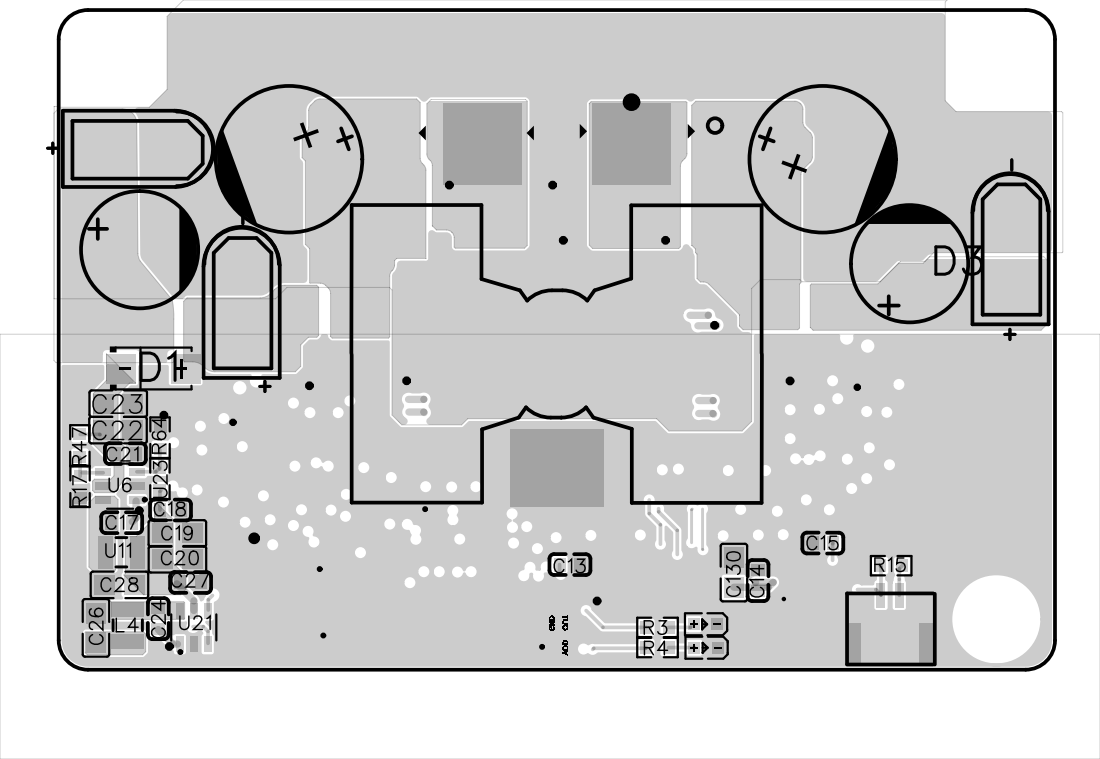
[picture p74: page 1]
