HKUSTGZ-ROBOMASTER-PNX/RM25_SC5.5_OpenSource/(list of files, drawings)

Other design files:
工程文件/原理图和PCB/ProPrj_G4SC5.5开源版.epro
