HKUSTGZ-ROBOMASTER-PNX/RM25_SC5.5_OpenSource/代码/Core/MAIN/main.cpp

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
/* Includes ------------------------------------------------------------------*/
#include "main.h"

/* USER CODE BEGIN Includes */

#include "bsp_adc.h"
#include "bsp_20k_tim.h"
#include "bsp_led.h"
#include "bsp_hrtim.h"
#include "bsp_can.h"
#include "BuckBoostController.hpp"

void SystemClock_Config(void);

BuckBoostController buckBoostController;

extern "C" void FDCAN1_IT0_IRQHandler(void);

void FDCAN1_IT0_IRQHandler(void)
{
  HAL_FDCAN_IRQHandler(&hfdcan1);
}

FDCAN_RxHeaderTypeDef RxHeader1;
uint8_t can_rxbuf2[8];

void HAL_FDCAN_RxFifo0Callback(FDCAN_HandleTypeDef *hfdcan, uint32_t RxFifo0ITs)
{
  if (HAL_FDCAN_GetRxMessage(hfdcan, FDCAN_RX_FIFO0, &RxHeader1, can_rxbuf2) != HAL_OK)
  {
    Error_Handler();
  }

  if (hfdcan == &hfdcan1)
  {
    if (RxHeader1.Identifier == 0xC5)
    {
      buckBoostController.supercap_set_packet.Receive(can_rxbuf2);
    }
  }
}
uint32_t c1 = 0,c2 = 2;
uint32_t delta = 0;
uint64_t tim8_count = 0;

extern "C" void TIM8_UP_IRQHandler(void)
{
	c1 = TIM8->CNT;
	buckBoostController.Update();
	LL_TIM_ClearFlag_UPDATE(TIM8);
	c2 = TIM8->CNT;
	
	tim8_count++;
	
	delta = c2-c1;
}

extern "C" void SysTick_Handler(void)
{
  if(buckBoostController.supercap_fdb_packet.m_send_flag==true)
  {
    buckBoostController.supercap_fdb_packet.Send();
  }
}

uint32_t dma1_count = 0;

extern "C" void DMA1_Channel1_IRQHandler(void)
{
	dma1_count++;
  buckBoostController.multimeter.ADC1Calu();
  LL_DMA_ClearFlag_TC1(DMA1);
}

extern "C" void DMA1_Channel2_IRQHandler(void)
{
  uint32_t dma2_count = 0;
  buckBoostController.multimeter.ADC2Calu();
  LL_DMA_ClearFlag_TC2(DMA1);
}

extern "C" void DMA1_Channel3_IRQHandler(void)
{
  buckBoostController.multimeter.ADC3Calu();
  LL_DMA_ClearFlag_TC3(DMA1);
}

/* USER CODE END 0 */

/**
 * @brief  The application entry point.
 * @retval int
 */
int main(void)
{
  LL_APB2_GRP1_EnableClock(LL_APB2_GRP1_PERIPH_SYSCFG);
  LL_APB1_GRP1_EnableClock(LL_APB1_GRP1_PERIPH_PWR);

  NVIC_SetPriorityGrouping(NVIC_PRIORITYGROUP_2);

  NVIC_SetPriority(SysTick_IRQn, NVIC_EncodePriority(NVIC_GetPriorityGrouping(), 15, 0));

  LL_PWR_DisableUCPDDeadBattery();
  SystemClock_Config();

  for (int i = 0; i < 1000;)
  {
    i++;
  }

  bsp_20k_tim_init();
  bsp_led_init();
  bsp_can1_init();

  SysTick->CTRL |= SysTick_CTRL_TICKINT_Msk; // Enable SysTick Interrupt
  SysTick->LOAD = 100000000 / 1000;
  SysTick->CTRL |= SysTick_CTRL_ENABLE_Msk; // Enable SysTick

  buckBoostController.Init();

  while (1)
  {
  }
}

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
