HKUSTGZ-ROBOMASTER-PNX/RM25_SC5.5_OpenSource/代码/RM25_SC.ioc

Mcu.UserName=STM32G474CBTx
PA0.Signal=ADC1_IN1
PA1.Signal=ADC1_IN2
PA11.Signal=FDCAN1_RX
PA12.Signal=FDCAN1_TX
PA13.Signal=SYS_JTMS-SWDIO
PA14.Signal=SYS_JTCK-SWCLK
PA15.Signal=USART2_RX
PA2.Signal=ADC1_IN3
PA3.Signal=ADC1_IN4
PA8.Signal=HRTIM1_CHA1
PA9.Signal=HRTIM1_CHA2
PB1.Signal=ADC1_IN12
PB12.Signal=HRTIM1_CHC1
PB13.Signal=HRTIM1_CHC2
PB3.Signal=USART2_TX
PB8-BOOT0.Signal=GPIO_Input
PF0-OSC_IN.Signal=RCC_OSC_IN
PG10-NRST.Signal=GPIO_Input
