HKUSTGZ-ROBOMASTER-PNX/RM25_SC5.5_OpenSource/代码/Core/BSP/bsp_hrtim.c

#include "bsp_hrtim.h"
#include "stm32g4xx_ll_adc.h"
#include "stm32g4xx_ll_tim.h"

void bsp_hrtim_init(void)
{
  LL_GPIO_InitTypeDef GPIO_InitStruct = {0};

  LL_APB2_GRP1_EnableClock(LL_APB2_GRP1_PERIPH_HRTIM1);
  LL_HRTIM_ConfigDLLCalibration(HRTIM1, LL_HRTIM_DLLCALIBRATION_MODE_CONTINUOUS, LL_HRTIM_DLLCALIBRATION_RATE_3);

  /* Poll for DLL end of calibration */
#if (USE_TIMEOUT == 1)
  uint32_t Timeout = 10; /* Timeout Initialization */
#endif                   /*USE_TIMEOUT*/

  while (LL_HRTIM_IsActiveFlag_DLLRDY(HRTIM1) == RESET)
  {
#if (USE_TIMEOUT == 1)
    if (LL_SYSTICK_IsActiveCounterFlag()) /* Check Systick counter flag to decrement the time-out value */
    {
      if (Timeout-- == 0)
      {
        Error_Handler(); /* error management */
      }
    }
#endif /* USE_TIMEOUT */
  }

  LL_HRTIM_TIM_SetPrescaler(HRTIM1, LL_HRTIM_TIMER_MASTER, LL_HRTIM_PRESCALERRATIO_MUL16);
  LL_HRTIM_TIM_SetCounterMode(HRTIM1, LL_HRTIM_TIMER_MASTER, LL_HRTIM_MODE_CONTINUOUS);
  LL_HRTIM_TIM_SetPeriod(HRTIM1, LL_HRTIM_TIMER_MASTER, 0x3E80);
  LL_HRTIM_TIM_SetRepetition(HRTIM1, LL_HRTIM_TIMER_MASTER, 0x00);
  LL_HRTIM_TIM_DisableHalfMode(HRTIM1, LL_HRTIM_TIMER_MASTER);
  LL_HRTIM_TIM_SetInterleavedMode(HRTIM1, LL_HRTIM_TIMER_MASTER, LL_HRTIM_INTERLEAVED_MODE_DISABLED);
  LL_HRTIM_TIM_DisableStartOnSync(HRTIM1, LL_HRTIM_TIMER_MASTER);
  LL_HRTIM_TIM_DisableResetOnSync(HRTIM1, LL_HRTIM_TIMER_MASTER);
  LL_HRTIM_TIM_SetDACTrig(HRTIM1, LL_HRTIM_TIMER_MASTER, LL_HRTIM_DACTRIG_NONE);
  LL_HRTIM_SetADCTrigSrc(HRTIM1, LL_HRTIM_ADCTRIG_1, LL_HRTIM_ADCTRIG_SRC13_MPER);

  LL_HRTIM_TIM_DisablePreload(HRTIM1, LL_HRTIM_TIMER_MASTER);
  LL_HRTIM_TIM_SetUpdateGating(HRTIM1, LL_HRTIM_TIMER_MASTER, LL_HRTIM_UPDATEGATING_INDEPENDENT);
  LL_HRTIM_TIM_SetUpdateTrig(HRTIM1, LL_HRTIM_TIMER_MASTER, LL_HRTIM_UPDATETRIG_NONE);
  LL_HRTIM_TIM_SetBurstModeOption(HRTIM1, LL_HRTIM_TIMER_MASTER, LL_HRTIM_BURSTMODE_MAINTAINCLOCK);

  LL_HRTIM_ForceUpdate(HRTIM1, LL_HRTIM_TIMER_MASTER);

  /* Poll for DLL end of calibration */
#if (USE_TIMEOUT == 1)
  uint32_t Timeout = 10; /* Timeout Initialization */
#endif                   /*USE_TIMEOUT*/

  while (LL_HRTIM_IsActiveFlag_DLLRDY(HRTIM1) == RESET)
  {
#if (USE_TIMEOUT == 1)
    if (LL_SYSTICK_IsActiveCounterFlag()) /* Check Systick counter flag to decrement the time-out value */
    {
      if (Timeout-- == 0)
      {
        Error_Handler(); /* error management */
      }
    }
#endif /* USE_TIMEOUT */
  }

  LL_HRTIM_TIM_SetPrescaler(HRTIM1, LL_HRTIM_TIMER_A, LL_HRTIM_PRESCALERRATIO_MUL16);
  LL_HRTIM_TIM_SetCounterMode(HRTIM1, LL_HRTIM_TIMER_A, LL_HRTIM_MODE_CONTINUOUS);
  LL_HRTIM_TIM_SetPeriod(HRTIM1, LL_HRTIM_TIMER_A, 0x3E80);
  LL_HRTIM_TIM_SetRepetition(HRTIM1, LL_HRTIM_TIMER_A, 0x00);
  LL_HRTIM_TIM_SetUpdateGating(HRTIM1, LL_HRTIM_TIMER_A, LL_HRTIM_UPDATEGATING_INDEPENDENT);
  LL_HRTIM_TIM_SetCountingMode(HRTIM1, LL_HRTIM_TIMER_A, LL_HRTIM_COUNTING_MODE_UP);
  LL_HRTIM_TIM_SetDACTrig(HRTIM1, LL_HRTIM_TIMER_A, LL_HRTIM_DACTRIG_NONE);
  LL_HRTIM_TIM_DisableHalfMode(HRTIM1, LL_HRTIM_TIMER_A);
  LL_HRTIM_TIM_SetInterleavedMode(HRTIM1, LL_HRTIM_TIMER_A, LL_HRTIM_INTERLEAVED_MODE_DISABLED);
  LL_HRTIM_TIM_DisableStartOnSync(HRTIM1, LL_HRTIM_TIMER_A);
  LL_HRTIM_TIM_DisableResetOnSync(HRTIM1, LL_HRTIM_TIMER_A);
  LL_HRTIM_TIM_EnablePreload(HRTIM1, LL_HRTIM_TIMER_A);
  LL_HRTIM_TIM_SetUpdateTrig(HRTIM1, LL_HRTIM_TIMER_A, LL_HRTIM_UPDATETRIG_NONE | LL_HRTIM_UPDATETRIG_REPETITION | LL_HRTIM_UPDATETRIG_RESET);
  LL_HRTIM_TIM_SetResetTrig(HRTIM1, LL_HRTIM_TIMER_A, LL_HRTIM_RESETTRIG_MASTER_PER);
  LL_HRTIM_TIM_DisablePushPullMode(HRTIM1, LL_HRTIM_TIMER_A);
  LL_HRTIM_TIM_EnableDeadTime(HRTIM1, LL_HRTIM_TIMER_A);
  LL_HRTIM_TIM_SetBurstModeOption(HRTIM1, LL_HRTIM_TIMER_A, LL_HRTIM_BURSTMODE_MAINTAINCLOCK);
  LL_HRTIM_ForceUpdate(HRTIM1, LL_HRTIM_TIMER_A);
  LL_HRTIM_TIM_DisableResyncUpdate(HRTIM1, LL_HRTIM_TIMER_A);

  LL_HRTIM_OUT_SetPolarity(HRTIM1, LL_HRTIM_OUTPUT_TA1, LL_HRTIM_OUT_POSITIVE_POLARITY);
  LL_HRTIM_OUT_SetIdleMode(HRTIM1, LL_HRTIM_OUTPUT_TA1, LL_HRTIM_OUT_NO_IDLE);
  LL_HRTIM_OUT_SetIdleLevel(HRTIM1, LL_HRTIM_OUTPUT_TA1, LL_HRTIM_OUT_IDLELEVEL_INACTIVE);
  LL_HRTIM_OUT_SetFaultState(HRTIM1, LL_HRTIM_OUTPUT_TA1, LL_HRTIM_OUT_FAULTSTATE_NO_ACTION);
  LL_HRTIM_OUT_SetChopperMode(HRTIM1, LL_HRTIM_OUTPUT_TA1, LL_HRTIM_OUT_CHOPPERMODE_DISABLED);
  LL_HRTIM_OUT_SetOutputSetSrc(HRTIM1, LL_HRTIM_OUTPUT_TA1, LL_HRTIM_OUTPUTSET_TIMCMP4);
  LL_HRTIM_OUT_SetOutputResetSrc(HRTIM1, LL_HRTIM_OUTPUT_TA1, LL_HRTIM_OUTPUTSET_TIMCMP1);
  //LL_HRTIM_OUT_SetBMEntryMode(HRTIM1, LL_HRTIM_OUTPUT_TA1, LL_HRTIM_OUT_BM_ENTRYMODE_DELAYED);

  LL_HRTIM_OUT_SetPolarity(HRTIM1, LL_HRTIM_OUTPUT_TA2, LL_HRTIM_OUT_POSITIVE_POLARITY);
  LL_HRTIM_OUT_SetIdleMode(HRTIM1, LL_HRTIM_OUTPUT_TA2, LL_HRTIM_OUT_NO_IDLE);
  LL_HRTIM_OUT_SetIdleLevel(HRTIM1, LL_HRTIM_OUTPUT_TA2, LL_HRTIM_OUT_IDLELEVEL_INACTIVE);
  LL_HRTIM_OUT_SetFaultState(HRTIM1, LL_HRTIM_OUTPUT_TA2, LL_HRTIM_OUT_FAULTSTATE_NO_ACTION);
  LL_HRTIM_OUT_SetChopperMode(HRTIM1, LL_HRTIM_OUTPUT_TA2, LL_HRTIM_OUT_CHOPPERMODE_DISABLED);
  LL_HRTIM_OUT_SetOutputSetSrc(HRTIM1, LL_HRTIM_OUTPUT_TA2, LL_HRTIM_OUTPUTSET_TIMCMP1);
  LL_HRTIM_OUT_SetOutputResetSrc(HRTIM1, LL_HRTIM_OUTPUT_TA2, LL_HRTIM_OUTPUTSET_TIMCMP4);
  //LL_HRTIM_OUT_SetBMEntryMode(HRTIM1, LL_HRTIM_OUTPUT_TA2, LL_HRTIM_OUT_BM_ENTRYMODE_DELAYED);

  LL_HRTIM_DT_SetPrescaler(HRTIM1, LL_HRTIM_TIMER_A, LL_HRTIM_DT_PRESCALER_MUL4); // 1/400MHz 2.5ns
  LL_HRTIM_DT_SetRisingValue(HRTIM1, LL_HRTIM_TIMER_A, 14);                       // 2.5ns/unit
  LL_HRTIM_DT_SetRisingSign(HRTIM1, LL_HRTIM_TIMER_A, LL_HRTIM_DT_RISING_POSITIVE);
  LL_HRTIM_DT_SetFallingValue(HRTIM1, LL_HRTIM_TIMER_A, 14);
  LL_HRTIM_DT_SetFallingSign(HRTIM1, LL_HRTIM_TIMER_A, LL_HRTIM_DT_FALLING_POSITIVE);

  LL_HRTIM_TIM_SetPrescaler(HRTIM1, LL_HRTIM_TIMER_C, LL_HRTIM_PRESCALERRATIO_MUL16);
  LL_HRTIM_TIM_SetCounterMode(HRTIM1, LL_HRTIM_TIMER_C, LL_HRTIM_MODE_CONTINUOUS);
  LL_HRTIM_TIM_SetPeriod(HRTIM1, LL_HRTIM_TIMER_C, 0x3E80);
  LL_HRTIM_TIM_SetRepetition(HRTIM1, LL_HRTIM_TIMER_C, 0x00);
  LL_HRTIM_TIM_SetUpdateGating(HRTIM1, LL_HRTIM_TIMER_C, LL_HRTIM_UPDATEGATING_INDEPENDENT);
  LL_HRTIM_TIM_SetCountingMode(HRTIM1, LL_HRTIM_TIMER_C, LL_HRTIM_COUNTING_MODE_UP);
  LL_HRTIM_TIM_SetDACTrig(HRTIM1, LL_HRTIM_TIMER_C, LL_HRTIM_DACTRIG_NONE);
  LL_HRTIM_TIM_DisableHalfMode(HRTIM1, LL_HRTIM_TIMER_C);
  LL_HRTIM_TIM_SetInterleavedMode(HRTIM1, LL_HRTIM_TIMER_C, LL_HRTIM_INTERLEAVED_MODE_DISABLED);
  LL_HRTIM_TIM_DisableStartOnSync(HRTIM1, LL_HRTIM_TIMER_C);
  LL_HRTIM_TIM_DisableResetOnSync(HRTIM1, LL_HRTIM_TIMER_C);
  LL_HRTIM_TIM_EnablePreload(HRTIM1, LL_HRTIM_TIMER_C);
  LL_HRTIM_TIM_SetUpdateTrig(HRTIM1, LL_HRTIM_TIMER_C, LL_HRTIM_UPDATETRIG_NONE | LL_HRTIM_UPDATETRIG_REPETITION | LL_HRTIM_UPDATETRIG_RESET);
  LL_HRTIM_TIM_SetResetTrig(HRTIM1, LL_HRTIM_TIMER_C, LL_HRTIM_RESETTRIG_MASTER_PER);
  LL_HRTIM_TIM_DisablePushPullMode(HRTIM1, LL_HRTIM_TIMER_C);
  LL_HRTIM_TIM_EnableDeadTime(HRTIM1, LL_HRTIM_TIMER_C);
  LL_HRTIM_TIM_SetBurstModeOption(HRTIM1, LL_HRTIM_TIMER_C, LL_HRTIM_BURSTMODE_MAINTAINCLOCK);
  LL_HRTIM_ForceUpdate(HRTIM1, LL_HRTIM_TIMER_C);
  LL_HRTIM_TIM_DisableResyncUpdate(HRTIM1, LL_HRTIM_TIMER_C);

  LL_HRTIM_OUT_SetPolarity(HRTIM1, LL_HRTIM_OUTPUT_TC1, LL_HRTIM_OUT_POSITIVE_POLARITY);
  LL_HRTIM_OUT_SetIdleMode(HRTIM1, LL_HRTIM_OUTPUT_TC1, LL_HRTIM_OUT_NO_IDLE);
  LL_HRTIM_OUT_SetIdleLevel(HRTIM1, LL_HRTIM_OUTPUT_TC1, LL_HRTIM_OUT_IDLELEVEL_INACTIVE);
  LL_HRTIM_OUT_SetFaultState(HRTIM1, LL_HRTIM_OUTPUT_TC1, LL_HRTIM_OUT_FAULTSTATE_NO_ACTION);
  LL_HRTIM_OUT_SetChopperMode(HRTIM1, LL_HRTIM_OUTPUT_TC1, LL_HRTIM_OUT_CHOPPERMODE_DISABLED);
  LL_HRTIM_OUT_SetOutputSetSrc(HRTIM1, LL_HRTIM_OUTPUT_TC1, LL_HRTIM_OUTPUTSET_TIMCMP3);
  LL_HRTIM_OUT_SetOutputResetSrc(HRTIM1, LL_HRTIM_OUTPUT_TC1, LL_HRTIM_OUTPUTSET_TIMCMP2);

  LL_HRTIM_OUT_SetPolarity(HRTIM1, LL_HRTIM_OUTPUT_TC2, LL_HRTIM_OUT_POSITIVE_POLARITY);
  LL_HRTIM_OUT_SetIdleMode(HRTIM1, LL_HRTIM_OUTPUT_TC2, LL_HRTIM_OUT_NO_IDLE);
  LL_HRTIM_OUT_SetIdleLevel(HRTIM1, LL_HRTIM_OUTPUT_TC2, LL_HRTIM_OUT_IDLELEVEL_INACTIVE);
  LL_HRTIM_OUT_SetFaultState(HRTIM1, LL_HRTIM_OUTPUT_TC2, LL_HRTIM_OUT_FAULTSTATE_NO_ACTION);
  LL_HRTIM_OUT_SetChopperMode(HRTIM1, LL_HRTIM_OUTPUT_TC2, LL_HRTIM_OUT_CHOPPERMODE_DISABLED);
  LL_HRTIM_OUT_SetOutputSetSrc(HRTIM1, LL_HRTIM_OUTPUT_TC2, LL_HRTIM_OUTPUTSET_TIMCMP2);
  LL_HRTIM_OUT_SetOutputResetSrc(HRTIM1, LL_HRTIM_OUTPUT_TC2, LL_HRTIM_OUTPUTSET_TIMCMP3);

  LL_HRTIM_DT_SetPrescaler(HRTIM1, LL_HRTIM_TIMER_C, LL_HRTIM_DT_PRESCALER_MUL4);
  LL_HRTIM_DT_SetRisingValue(HRTIM1, LL_HRTIM_TIMER_C, 14); // gan 4
  LL_HRTIM_DT_SetRisingSign(HRTIM1, LL_HRTIM_TIMER_C, LL_HRTIM_DT_RISING_POSITIVE);
  LL_HRTIM_DT_SetFallingValue(HRTIM1, LL_HRTIM_TIMER_C, 14);
  LL_HRTIM_DT_SetFallingSign(HRTIM1, LL_HRTIM_TIMER_C, LL_HRTIM_DT_FALLING_POSITIVE);
	
	LL_HRTIM_TIM_SetPrescaler(HRTIM1, LL_HRTIM_TIMER_B, LL_HRTIM_PRESCALERRATIO_MUL16);
  LL_HRTIM_TIM_SetCounterMode(HRTIM1, LL_HRTIM_TIMER_B, LL_HRTIM_MODE_SINGLESHOT);
  LL_HRTIM_TIM_SetPeriod(HRTIM1, LL_HRTIM_TIMER_B, 0x3E80);
  LL_HRTIM_TIM_SetRepetition(HRTIM1, LL_HRTIM_TIMER_B, 0x00);
  LL_HRTIM_TIM_SetUpdateGating(HRTIM1, LL_HRTIM_TIMER_B, LL_HRTIM_UPDATEGATING_INDEPENDENT);
  LL_HRTIM_TIM_SetCountingMode(HRTIM1, LL_HRTIM_TIMER_B, LL_HRTIM_COUNTING_MODE_UP);
  LL_HRTIM_TIM_DisableHalfMode(HRTIM1, LL_HRTIM_TIMER_B);
  LL_HRTIM_TIM_SetInterleavedMode(HRTIM1, LL_HRTIM_TIMER_B, LL_HRTIM_INTERLEAVED_MODE_DISABLED);
  LL_HRTIM_TIM_DisableStartOnSync(HRTIM1, LL_HRTIM_TIMER_B);
  LL_HRTIM_TIM_DisableResetOnSync(HRTIM1, LL_HRTIM_TIMER_B);
  LL_HRTIM_TIM_EnablePreload(HRTIM1, LL_HRTIM_TIMER_B);
  LL_HRTIM_TIM_SetUpdateTrig(HRTIM1, LL_HRTIM_TIMER_B, LL_HRTIM_UPDATETRIG_NONE | LL_HRTIM_UPDATETRIG_REPETITION | LL_HRTIM_UPDATETRIG_RESET);
  LL_HRTIM_TIM_SetResetTrig(HRTIM1, LL_HRTIM_TIMER_B, LL_HRTIM_RESETTRIG_MASTER_CMP1);
  LL_HRTIM_TIM_DisablePushPullMode(HRTIM1, LL_HRTIM_TIMER_B);
  LL_HRTIM_TIM_SetBurstModeOption(HRTIM1, LL_HRTIM_TIMER_B, LL_HRTIM_BURSTMODE_MAINTAINCLOCK);
  LL_HRTIM_ForceUpdate(HRTIM1, LL_HRTIM_TIMER_B);
  LL_HRTIM_TIM_DisableResyncUpdate(HRTIM1, LL_HRTIM_TIMER_B);
	
	LL_HRTIM_TIM_SetCompare1(HRTIM1, LL_HRTIM_TIMER_MASTER, 4000);

  LL_AHB2_GRP1_EnableClock(LL_AHB2_GRP1_PERIPH_GPIOA);
  LL_AHB2_GRP1_EnableClock(LL_AHB2_GRP1_PERIPH_GPIOB);

  GPIO_InitStruct.Pin = LL_GPIO_PIN_12;
  GPIO_InitStruct.Mode = LL_GPIO_MODE_ALTERNATE;
  GPIO_InitStruct.Speed = LL_GPIO_SPEED_FREQ_HIGH;
  GPIO_InitStruct.OutputType = LL_GPIO_OUTPUT_PUSHPULL;
  GPIO_InitStruct.Pull = LL_GPIO_PULL_DOWN;
  GPIO_InitStruct.Alternate = LL_GPIO_AF_13;
  LL_GPIO_Init(GPIOB, &GPIO_InitStruct);

  GPIO_InitStruct.Pin = LL_GPIO_PIN_13;
  GPIO_InitStruct.Mode = LL_GPIO_MODE_ALTERNATE;
  GPIO_InitStruct.Speed = LL_GPIO_SPEED_FREQ_HIGH;
  GPIO_InitStruct.OutputType = LL_GPIO_OUTPUT_PUSHPULL;
  GPIO_InitStruct.Pull = LL_GPIO_PULL_DOWN;
  GPIO_InitStruct.Alternate = LL_GPIO_AF_13;
  LL_GPIO_Init(GPIOB, &GPIO_InitStruct);

  GPIO_InitStruct.Pin = LL_GPIO_PIN_8;
  GPIO_InitStruct.Mode = LL_GPIO_MODE_ALTERNATE;
  GPIO_InitStruct.Speed = LL_GPIO_SPEED_FREQ_HIGH;
  GPIO_InitStruct.OutputType = LL_GPIO_OUTPUT_PUSHPULL;
  GPIO_InitStruct.Pull = LL_GPIO_PULL_DOWN;
  GPIO_InitStruct.Alternate = LL_GPIO_AF_13;
  LL_GPIO_Init(GPIOA, &GPIO_InitStruct);

  GPIO_InitStruct.Pin = LL_GPIO_PIN_9;
  GPIO_InitStruct.Mode = LL_GPIO_MODE_ALTERNATE;
  GPIO_InitStruct.Speed = LL_GPIO_SPEED_FREQ_HIGH;
  GPIO_InitStruct.OutputType = LL_GPIO_OUTPUT_PUSHPULL;
  GPIO_InitStruct.Pull = LL_GPIO_PULL_DOWN;
  GPIO_InitStruct.Alternate = LL_GPIO_AF_13;
  LL_GPIO_Init(GPIOA, &GPIO_InitStruct);

  // LL_HRTIM_TIM_CounterEnable(HRTIM1, LL_HRTIM_TIMER_A);
  // LL_HRTIM_TIM_CounterEnable(HRTIM1, LL_HRTIM_TIMER_C);
  // LL_HRTIM_TIM_CounterEnable(HRTIM1, LL_HRTIM_TIMER_MASTER);

  // LL_TIM_EnableCounter(TIM1);

  // bsp_hrtim_set(26470);

  NVIC_SetPriority(HRTIM1_Master_IRQn, 0);
  NVIC_EnableIRQ(HRTIM1_Master_IRQn);
}

const static uint32_t HTTimPer = 0x3E80;
uint8_t burst_mode = 0;
static uint32_t PWM_PER_0_5 = 0.5f * HTTimPer;
uint32_t buck_duty, boost_duty;
uint32_t debug_boost_set = 100;

void bsp_hrtim_burst_on(void)
{
  LL_HRTIM_TIM_CounterDisable(HRTIM1, LL_HRTIM_TIMER_A);
  LL_HRTIM_TIM_CounterDisable(HRTIM1, LL_HRTIM_TIMER_C);
	LL_HRTIM_TIM_CounterDisable(HRTIM1, LL_HRTIM_TIMER_B);
  LL_HRTIM_TIM_CounterDisable(HRTIM1, LL_HRTIM_TIMER_MASTER);

  LL_HRTIM_BM_SetPeriod(HRTIM1, 5 - 1);
  LL_HRTIM_BM_SetCompare(HRTIM1, 4 - 1);
  LL_HRTIM_BM_SetMode(HRTIM1, LL_HRTIM_BM_MODE_CONTINOUS);
  LL_HRTIM_BM_SetClockSrc(HRTIM1, LL_HRTIM_BM_CLKSRC_TIMER_B);
  //LL_HRTIM_BM_SetTrig(HRTIM1, LL_HRTIM_BM_TRIG_MASTER_RESET);
  LL_HRTIM_BM_Enable(HRTIM1);
  LL_HRTIM_BM_Start(HRTIM1);

  LL_HRTIM_OUT_SetIdleLevel(HRTIM1, LL_HRTIM_OUTPUT_TA1, LL_HRTIM_OUT_IDLELEVEL_ACTIVE);
  LL_HRTIM_OUT_SetIdleLevel(HRTIM1, LL_HRTIM_OUTPUT_TC1, LL_HRTIM_OUT_IDLELEVEL_ACTIVE);

  LL_HRTIM_TIM_CounterEnable(HRTIM1, LL_HRTIM_TIMER_A);
  LL_HRTIM_TIM_CounterEnable(HRTIM1, LL_HRTIM_TIMER_C);
	LL_HRTIM_TIM_CounterEnable(HRTIM1, LL_HRTIM_TIMER_B);
  LL_HRTIM_TIM_CounterEnable(HRTIM1, LL_HRTIM_TIMER_MASTER);

  burst_mode = 1;
}

void bsp_hrtim_set(int set)
{
  if (set < 15392.4f)
  {
    buck_duty = set * -0.493553f + 7996.96f;
    boost_duty = 0.95f * PWM_PER_0_5;
  }
  else if (set >= 15392.4f && set < 16000.0f)
  {
    buck_duty = set * -0.475313f + 8005.0f;
    boost_duty = 0.95f * PWM_PER_0_5;
  }
  else if (set >= 16000.0f && set < 16631.6f)
  {
    buck_duty = 0.05f * PWM_PER_0_5;
    boost_duty = -0.457251 * set + 14916.0f;
  }
  else if (set >= 16631.6f)
  {
    buck_duty = 0.05f * PWM_PER_0_5;
    boost_duty = -0.40915f * set + 14285.1f;
  }

  
/*
if (set < 14694.0f)
  {
    buck_duty = set * -0.447675f + 7966.14f;
    boost_duty = 0.9f * PWM_PER_0_5;
  }
  else if (set >= 14694.0f && set < 16000.0f)
  {
    buck_duty = set * -0.45023f + 8003.68f;
    boost_duty = 0.9f * PWM_PER_0_5;
  }
  else if (set >= 16000.0f && set < 17422.0f)
  {
    buck_duty = 0.1f * PWM_PER_0_5;
    boost_duty = -0.413502f * set + 13816.0f;
  }
  else if (set >= 17422.0f)
  {
    buck_duty = 0.1f * PWM_PER_0_5;
    boost_duty = -0.381344 * set + 13843.8f;
  }
  */


  // if (set > 0.95f * HTTimPer)
  // {
  // }
  // else if (set <= 0.95f * HTTimPer && set > 0.9f * HTTimPer) // 14400, 14401 = 24.104
  // {
  //   boost_duty = set * 0.5f + 126; // 7600
  //   buck_duty = 0.08f * PWM_PER_0_5;

  //   if (burst_mode == 1)
  //   {
  //     LL_HRTIM_OUT_SetIdleMode(HRTIM1, LL_HRTIM_OUTPUT_TA1, LL_HRTIM_OUT_NO_IDLE);
  //     LL_HRTIM_OUT_SetIdleMode(HRTIM1, LL_HRTIM_OUTPUT_TA2, LL_HRTIM_OUT_NO_IDLE);
  //     LL_HRTIM_OUT_SetIdleMode(HRTIM1, LL_HRTIM_OUTPUT_TC1, LL_HRTIM_OUT_NO_IDLE);
  //     LL_HRTIM_OUT_SetIdleMode(HRTIM1, LL_HRTIM_OUTPUT_TC2, LL_HRTIM_OUT_NO_IDLE);
  //   }
  // }
  // else
  // {
  //   boost_duty = set * 0.5f + 705; // 7600
  //   buck_duty = 0.11f * PWM_PER_0_5;

  //   if (burst_mode == 1)
  //   {
  //     LL_HRTIM_OUT_SetIdleMode(HRTIM1, LL_HRTIM_OUTPUT_TC1, LL_HRTIM_OUT_IDLE_WHEN_BURST);
  //     LL_HRTIM_OUT_SetIdleMode(HRTIM1, LL_HRTIM_OUTPUT_TC2, LL_HRTIM_OUT_IDLE_WHEN_BURST);
  //     LL_HRTIM_OUT_SetIdleMode(HRTIM1, LL_HRTIM_OUTPUT_TA1, LL_HRTIM_OUT_NO_IDLE);
  //     LL_HRTIM_OUT_SetIdleMode(HRTIM1, LL_HRTIM_OUTPUT_TA2, LL_HRTIM_OUT_NO_IDLE);
  //   }
  // }

  LL_HRTIM_TIM_SetCompare1(HRTIM1, LL_HRTIM_TIMER_A, PWM_PER_0_5 + boost_duty);
  LL_HRTIM_TIM_SetCompare4(HRTIM1, LL_HRTIM_TIMER_A, PWM_PER_0_5 - boost_duty);

  LL_HRTIM_TIM_SetCompare2(HRTIM1, LL_HRTIM_TIMER_C, PWM_PER_0_5 - buck_duty);
  LL_HRTIM_TIM_SetCompare3(HRTIM1, LL_HRTIM_TIMER_C, PWM_PER_0_5 + buck_duty);
}

void bsp_set_hrtim_mode(uint8_t mode)
{
  switch (mode)
  {
  case 0:

    LL_HRTIM_OUT_SetIdleMode(HRTIM1, LL_HRTIM_OUTPUT_TA1, LL_HRTIM_OUT_IDLE_WHEN_BURST);
    LL_HRTIM_OUT_SetIdleMode(HRTIM1, LL_HRTIM_OUTPUT_TA2, LL_HRTIM_OUT_IDLE_WHEN_BURST);
    LL_HRTIM_OUT_SetIdleMode(HRTIM1, LL_HRTIM_OUTPUT_TC1, LL_HRTIM_OUT_NO_IDLE);
    LL_HRTIM_OUT_SetIdleMode(HRTIM1, LL_HRTIM_OUTPUT_TC2, LL_HRTIM_OUT_NO_IDLE);
    break;
  case 1:
  case 2:
    LL_HRTIM_OUT_SetIdleMode(HRTIM1, LL_HRTIM_OUTPUT_TA1, LL_HRTIM_OUT_NO_IDLE);
    LL_HRTIM_OUT_SetIdleMode(HRTIM1, LL_HRTIM_OUTPUT_TA2, LL_HRTIM_OUT_NO_IDLE);
    LL_HRTIM_OUT_SetIdleMode(HRTIM1, LL_HRTIM_OUTPUT_TC1, LL_HRTIM_OUT_NO_IDLE);
    LL_HRTIM_OUT_SetIdleMode(HRTIM1, LL_HRTIM_OUTPUT_TC2, LL_HRTIM_OUT_NO_IDLE);
    break;
  case 3:
    LL_HRTIM_OUT_SetIdleMode(HRTIM1, LL_HRTIM_OUTPUT_TC1, LL_HRTIM_OUT_IDLE_WHEN_BURST);
    LL_HRTIM_OUT_SetIdleMode(HRTIM1, LL_HRTIM_OUTPUT_TC2, LL_HRTIM_OUT_IDLE_WHEN_BURST);
    LL_HRTIM_OUT_SetIdleMode(HRTIM1, LL_HRTIM_OUTPUT_TA1, LL_HRTIM_OUT_NO_IDLE);
    LL_HRTIM_OUT_SetIdleMode(HRTIM1, LL_HRTIM_OUTPUT_TA2, LL_HRTIM_OUT_NO_IDLE);
    break;
  default:
    LL_HRTIM_OUT_SetIdleMode(HRTIM1, LL_HRTIM_OUTPUT_TA1, LL_HRTIM_OUT_NO_IDLE);
    LL_HRTIM_OUT_SetIdleMode(HRTIM1, LL_HRTIM_OUTPUT_TA2, LL_HRTIM_OUT_NO_IDLE);
    LL_HRTIM_OUT_SetIdleMode(HRTIM1, LL_HRTIM_OUTPUT_TC1, LL_HRTIM_OUT_NO_IDLE);
    LL_HRTIM_OUT_SetIdleMode(HRTIM1, LL_HRTIM_OUTPUT_TC2, LL_HRTIM_OUT_NO_IDLE);
    break;
  }
  burst_mode = mode;
}

void bsp_hrtim_on(void)
{
  LL_HRTIM_EnableOutput(HRTIM1, LL_HRTIM_OUTPUT_TA1 | LL_HRTIM_OUTPUT_TA2);
  LL_HRTIM_EnableOutput(HRTIM1, LL_HRTIM_OUTPUT_TC1 | LL_HRTIM_OUTPUT_TC2);
}

void bsp_hrtim_off(void)
{
  LL_HRTIM_DisableOutput(HRTIM1, LL_HRTIM_OUTPUT_TA1 | LL_HRTIM_OUTPUT_TA2);
  LL_HRTIM_DisableOutput(HRTIM1, LL_HRTIM_OUTPUT_TC1 | LL_HRTIM_OUTPUT_TC2);
}

void HRTIM1_Master_IRQHandler(void)
{
  if (LL_HRTIM_IsActiveFlag_REP(HRTIM1, LL_HRTIM_TIMER_MASTER) != 0)
  {
    LL_HRTIM_ClearFlag_REP(HRTIM1, LL_HRTIM_TIMER_MASTER);
  }
}
