HKUSTGZ-ROBOMASTER-PNX/RM25_SC5.5_OpenSource/代码/Core/BSP/bsp_adc.c

#include "bsp_adc.h"
#include "stm32g4xx_ll_adc.h"
#include "stm32g4xx_ll_dma.h"
#include "stm32g4xx_ll_gpio.h"
#include "stm32g4xx_ll_tim.h"
#include "stm32g4xx_ll_rcc.h"
#include "stm32g4xx_ll_bus.h"
#include "stm32g474xx.h"

void bsp_adc1_init()
{
  LL_ADC_InitTypeDef ADC_InitStruct = {0};
  LL_ADC_REG_InitTypeDef ADC_REG_InitStruct = {0};
  LL_ADC_CommonInitTypeDef ADC_CommonInitStruct = {0};

  LL_GPIO_InitTypeDef GPIO_InitStruct = {0};

  LL_RCC_SetADCClockSource(LL_RCC_ADC12_CLKSOURCE_SYSCLK);

  LL_AHB2_GRP1_EnableClock(LL_AHB2_GRP1_PERIPH_ADC12);
  LL_AHB2_GRP1_EnableClock(LL_AHB2_GRP1_PERIPH_GPIOA);
  LL_AHB2_GRP1_EnableClock(LL_AHB2_GRP1_PERIPH_GPIOB);

  GPIO_InitStruct.Pin = LL_GPIO_PIN_0;
  GPIO_InitStruct.Mode = LL_GPIO_MODE_ANALOG;
  GPIO_InitStruct.Pull = LL_GPIO_PULL_NO;
  LL_GPIO_Init(GPIOA, &GPIO_InitStruct);

  GPIO_InitStruct.Pin = LL_GPIO_PIN_1;
  GPIO_InitStruct.Mode = LL_GPIO_MODE_ANALOG;
  GPIO_InitStruct.Pull = LL_GPIO_PULL_NO;
  LL_GPIO_Init(GPIOA, &GPIO_InitStruct);

  GPIO_InitStruct.Pin = LL_GPIO_PIN_2;
  GPIO_InitStruct.Mode = LL_GPIO_MODE_ANALOG;
  GPIO_InitStruct.Pull = LL_GPIO_PULL_NO;
  LL_GPIO_Init(GPIOA, &GPIO_InitStruct);

  GPIO_InitStruct.Pin = LL_GPIO_PIN_3;
  GPIO_InitStruct.Mode = LL_GPIO_MODE_ANALOG;
  GPIO_InitStruct.Pull = LL_GPIO_PULL_NO;
  LL_GPIO_Init(GPIOA, &GPIO_InitStruct);

  GPIO_InitStruct.Pin = LL_GPIO_PIN_1;
  GPIO_InitStruct.Mode = LL_GPIO_MODE_ANALOG;
  GPIO_InitStruct.Pull = LL_GPIO_PULL_NO;
  LL_GPIO_Init(GPIOB, &GPIO_InitStruct);

  ADC_InitStruct.Resolution = LL_ADC_RESOLUTION_12B;
  ADC_InitStruct.DataAlignment = LL_ADC_DATA_ALIGN_RIGHT;
  ADC_InitStruct.LowPowerMode = LL_ADC_LP_MODE_NONE;
  LL_ADC_Init(ADC1, &ADC_InitStruct);

  ADC_REG_InitStruct.TriggerSource = LL_ADC_REG_TRIG_EXT_HRTIM_TRG1;
  ADC_REG_InitStruct.SequencerLength = LL_ADC_REG_SEQ_SCAN_ENABLE_2RANKS;
  ADC_REG_InitStruct.SequencerDiscont = LL_ADC_REG_SEQ_DISCONT_1RANK;
  ADC_REG_InitStruct.ContinuousMode = LL_ADC_REG_CONV_SINGLE;
  ADC_REG_InitStruct.DMATransfer = LL_ADC_REG_DMA_TRANSFER_UNLIMITED;
  ADC_REG_InitStruct.Overrun = LL_ADC_REG_OVR_DATA_OVERWRITTEN;
  LL_ADC_REG_Init(ADC1, &ADC_REG_InitStruct);

  LL_ADC_SetGainCompensation(ADC1, 0);
  LL_ADC_SetOverSamplingScope(ADC1, LL_ADC_OVS_GRP_REGULAR_CONTINUED);
  LL_ADC_ConfigOverSamplingRatioShift(ADC1, LL_ADC_OVS_RATIO_8, LL_ADC_OVS_SHIFT_NONE);

  ADC_CommonInitStruct.CommonClock = LL_ADC_CLOCK_SYNC_PCLK_DIV2;
  ADC_CommonInitStruct.Multimode = LL_ADC_MULTI_INDEPENDENT;
  LL_ADC_CommonInit(__LL_ADC_COMMON_INSTANCE(ADC1), &ADC_CommonInitStruct);

  LL_ADC_REG_SetTriggerEdge(ADC1, LL_ADC_REG_TRIG_EXT_RISING);

  LL_ADC_DisableDeepPowerDown(ADC1);

  LL_ADC_EnableInternalRegulator(ADC1);

  volatile uint32_t wait_loop_index;
  wait_loop_index = ((LL_ADC_DELAY_INTERNAL_REGUL_STAB_US * (SystemCoreClock / (100000 * 2))) / 10);
  while (wait_loop_index != 0)
  {
    wait_loop_index--;
  }

  LL_ADC_StartCalibration(ADC1, LL_ADC_SINGLE_ENDED);

  while (LL_ADC_IsCalibrationOnGoing(ADC1) != 0)
  {
  }

  volatile uint32_t cal = LL_ADC_GetCalibrationFactor(ADC1, LL_ADC_SINGLE_ENDED);

  wait_loop_index = ((LL_ADC_DELAY_CALIB_ENABLE_ADC_CYCLES * 32) >> 1);
  while (wait_loop_index != 0)
  {
    wait_loop_index--;
  }

  LL_ADC_Enable(ADC1);

  while (LL_ADC_IsActiveFlag_ADRDY(ADC1) != SET)
  {
  }

  LL_ADC_SetCalibrationFactor(ADC1, LL_ADC_SINGLE_ENDED, cal);

  // LL_ADC_SetCommonPathInternalCh(ADC12_COMMON,LL_ADC_PATH_INTERNAL_VREFINT);

//  LL_ADC_REG_SetSequencerRanks(ADC1, LL_ADC_REG_RANK_1, LL_ADC_CHANNEL_1);
//  LL_ADC_SetChannelSamplingTime(ADC1, LL_ADC_CHANNEL_1, LL_ADC_SAMPLINGTIME_6CYCLES_5);
//  LL_ADC_SetChannelSingleDiff(ADC1, LL_ADC_CHANNEL_1, LL_ADC_SINGLE_ENDED);

  // LL_ADC_REG_SetSequencerRanks(ADC1, LL_ADC_REG_RANK_2, LL_ADC_CHANNEL_2);
  // LL_ADC_SetChannelSamplingTime(ADC1, LL_ADC_CHANNEL_2, LL_ADC_SAMPLINGTIME_12CYCLES_5);
  // LL_ADC_SetChannelSingleDiff(ADC1, LL_ADC_CHANNEL_2, LL_ADC_SINGLE_ENDED);

  LL_ADC_REG_SetSequencerRanks(ADC1, LL_ADC_REG_RANK_1, LL_ADC_CHANNEL_3);
  LL_ADC_SetChannelSamplingTime(ADC1, LL_ADC_CHANNEL_3, LL_ADC_SAMPLINGTIME_12CYCLES_5);
  LL_ADC_SetChannelSingleDiff(ADC1, LL_ADC_CHANNEL_3, LL_ADC_SINGLE_ENDED);

  LL_ADC_REG_SetSequencerRanks(ADC1, LL_ADC_REG_RANK_2, LL_ADC_CHANNEL_4);
  LL_ADC_SetChannelSamplingTime(ADC1, LL_ADC_CHANNEL_4, LL_ADC_SAMPLINGTIME_12CYCLES_5);
  LL_ADC_SetChannelSingleDiff(ADC1, LL_ADC_CHANNEL_4, LL_ADC_SINGLE_ENDED);

//  LL_ADC_REG_SetSequencerRanks(ADC1, LL_ADC_REG_RANK_4, LL_ADC_CHANNEL_12);
//  LL_ADC_SetChannelSamplingTime(ADC1, LL_ADC_CHANNEL_12, LL_ADC_SAMPLINGTIME_12CYCLES_5);
//  LL_ADC_SetChannelSingleDiff(ADC1, LL_ADC_CHANNEL_12, LL_ADC_SINGLE_ENDED);

  LL_ADC_REG_StartConversion(ADC1);
}

void bsp_adc1_DMA_init(uint16_t *buffer)
{
  LL_AHB1_GRP1_EnableClock(LL_AHB1_GRP1_PERIPH_DMAMUX1);
  LL_AHB1_GRP1_EnableClock(LL_AHB1_GRP1_PERIPH_DMA1);

  LL_DMA_InitTypeDef DMA_InitStruct = {0};

  DMA_InitStruct.Mode = LL_DMA_MODE_CIRCULAR;
  DMA_InitStruct.Direction = LL_DMA_DIRECTION_PERIPH_TO_MEMORY;
  DMA_InitStruct.PeriphOrM2MSrcAddress = (uint32_t)&ADC1->DR;
  DMA_InitStruct.PeriphOrM2MSrcDataSize = LL_DMA_PDATAALIGN_HALFWORD;
  DMA_InitStruct.MemoryOrM2MDstDataSize = LL_DMA_MDATAALIGN_HALFWORD;
  DMA_InitStruct.NbData = 2;
  DMA_InitStruct.Priority = LL_DMA_PRIORITY_VERYHIGH;
  DMA_InitStruct.MemoryOrM2MDstAddress = (uint32_t)buffer + 0x10018000;
  DMA_InitStruct.PeriphRequest = LL_DMAMUX_REQ_ADC1;
  DMA_InitStruct.PeriphOrM2MSrcIncMode = LL_DMA_PERIPH_NOINCREMENT;
  DMA_InitStruct.MemoryOrM2MDstIncMode = LL_DMA_MEMORY_INCREMENT;
  LL_DMA_Init(DMA1, LL_DMA_CHANNEL_1, &DMA_InitStruct);

  LL_DMA_EnableIT_TC(DMA1, LL_DMA_CHANNEL_1);

  NVIC_SetPriority(DMA1_Channel1_IRQn, NVIC_EncodePriority(NVIC_GetPriorityGrouping(), 3, 0));
  NVIC_EnableIRQ(DMA1_Channel1_IRQn);

  LL_DMA_EnableChannel(DMA1, LL_DMA_CHANNEL_1);
}

void bsp_adc2_init()
{
  LL_ADC_InitTypeDef ADC_InitStruct = {0};
  LL_ADC_REG_InitTypeDef ADC_REG_InitStruct = {0};
  LL_ADC_CommonInitTypeDef ADC_CommonInitStruct = {0};

  LL_GPIO_InitTypeDef GPIO_InitStruct = {0};

  LL_RCC_SetADCClockSource(LL_RCC_ADC12_CLKSOURCE_SYSCLK);

  LL_AHB2_GRP1_EnableClock(LL_AHB2_GRP1_PERIPH_ADC12);

  ADC_InitStruct.Resolution = LL_ADC_RESOLUTION_12B;
  ADC_InitStruct.DataAlignment = LL_ADC_DATA_ALIGN_RIGHT;
  ADC_InitStruct.LowPowerMode = LL_ADC_LP_MODE_NONE;
  LL_ADC_Init(ADC2, &ADC_InitStruct);

  ADC_REG_InitStruct.TriggerSource = LL_ADC_REG_TRIG_EXT_HRTIM_TRG1;
  ADC_REG_InitStruct.SequencerLength = LL_ADC_REG_SEQ_SCAN_ENABLE_2RANKS;
  ADC_REG_InitStruct.SequencerDiscont = LL_ADC_REG_SEQ_DISCONT_1RANK;
  ADC_REG_InitStruct.ContinuousMode = LL_ADC_REG_CONV_SINGLE;
  ADC_REG_InitStruct.DMATransfer = LL_ADC_REG_DMA_TRANSFER_UNLIMITED;
  ADC_REG_InitStruct.Overrun = LL_ADC_REG_OVR_DATA_OVERWRITTEN;
  LL_ADC_REG_Init(ADC2, &ADC_REG_InitStruct);

  LL_ADC_SetGainCompensation(ADC2, 0);
  LL_ADC_SetOverSamplingScope(ADC2, LL_ADC_OVS_GRP_REGULAR_CONTINUED);
  LL_ADC_ConfigOverSamplingRatioShift(ADC2, LL_ADC_OVS_RATIO_8, LL_ADC_OVS_SHIFT_NONE);

  ADC_CommonInitStruct.CommonClock = LL_ADC_CLOCK_SYNC_PCLK_DIV2;
  ADC_CommonInitStruct.Multimode = LL_ADC_MULTI_INDEPENDENT;
  LL_ADC_CommonInit(__LL_ADC_COMMON_INSTANCE(ADC2), &ADC_CommonInitStruct);

  LL_ADC_REG_SetTriggerEdge(ADC2, LL_ADC_REG_TRIG_EXT_RISING);

  LL_ADC_DisableDeepPowerDown(ADC2);

  LL_ADC_EnableInternalRegulator(ADC2);

  volatile uint32_t wait_loop_index;
  wait_loop_index = ((LL_ADC_DELAY_INTERNAL_REGUL_STAB_US * (SystemCoreClock / (100000 * 2))) / 10);
  while (wait_loop_index != 0)
  {
    wait_loop_index--;
  }

  LL_ADC_StartCalibration(ADC2, LL_ADC_SINGLE_ENDED);

  while (LL_ADC_IsCalibrationOnGoing(ADC2) != 0)
  {
  }

  volatile uint32_t cal = LL_ADC_GetCalibrationFactor(ADC2, LL_ADC_SINGLE_ENDED);

  wait_loop_index = ((LL_ADC_DELAY_CALIB_ENABLE_ADC_CYCLES * 32) >> 1);
  while (wait_loop_index != 0)
  {
    wait_loop_index--;
  }

  LL_ADC_Enable(ADC2);

  while (LL_ADC_IsActiveFlag_ADRDY(ADC2) != SET)
  {
  }

  LL_ADC_SetCalibrationFactor(ADC2, LL_ADC_SINGLE_ENDED, cal);


  LL_ADC_REG_SetSequencerRanks(ADC2, LL_ADC_REG_RANK_1, LL_ADC_CHANNEL_1);
  LL_ADC_SetChannelSamplingTime(ADC2, LL_ADC_CHANNEL_1, LL_ADC_SAMPLINGTIME_12CYCLES_5);
  LL_ADC_SetChannelSingleDiff(ADC2, LL_ADC_CHANNEL_1, LL_ADC_SINGLE_ENDED);
	
	LL_ADC_REG_SetSequencerRanks(ADC2, LL_ADC_REG_RANK_2, LL_ADC_CHANNEL_2);
  LL_ADC_SetChannelSamplingTime(ADC2, LL_ADC_CHANNEL_2, LL_ADC_SAMPLINGTIME_12CYCLES_5);
  LL_ADC_SetChannelSingleDiff(ADC2, LL_ADC_CHANNEL_2, LL_ADC_SINGLE_ENDED);

  LL_ADC_REG_StartConversion(ADC2);
}

void bsp_adc2_DMA_init(uint16_t* buffer)
{
  LL_AHB1_GRP1_EnableClock(LL_AHB1_GRP1_PERIPH_DMAMUX1);
  LL_AHB1_GRP1_EnableClock(LL_AHB1_GRP1_PERIPH_DMA1);

  LL_DMA_InitTypeDef DMA_InitStruct = {0};

  DMA_InitStruct.Mode = LL_DMA_MODE_CIRCULAR;
  DMA_InitStruct.Direction = LL_DMA_DIRECTION_PERIPH_TO_MEMORY;
  DMA_InitStruct.PeriphOrM2MSrcAddress = (uint32_t)&ADC2->DR;
  DMA_InitStruct.PeriphOrM2MSrcDataSize = LL_DMA_PDATAALIGN_HALFWORD;
  DMA_InitStruct.MemoryOrM2MDstDataSize = LL_DMA_MDATAALIGN_HALFWORD;
  DMA_InitStruct.NbData = 2;
  DMA_InitStruct.Priority = LL_DMA_PRIORITY_VERYHIGH;
  DMA_InitStruct.MemoryOrM2MDstAddress = (uint32_t)buffer + 0x10018000;
  DMA_InitStruct.PeriphRequest = LL_DMAMUX_REQ_ADC2;
  DMA_InitStruct.PeriphOrM2MSrcIncMode = LL_DMA_PERIPH_NOINCREMENT;
  DMA_InitStruct.MemoryOrM2MDstIncMode = LL_DMA_MEMORY_INCREMENT;
  LL_DMA_Init(DMA1, LL_DMA_CHANNEL_2, &DMA_InitStruct);

  LL_DMA_EnableIT_TC(DMA1, LL_DMA_CHANNEL_2);

  NVIC_SetPriority(DMA1_Channel2_IRQn, NVIC_EncodePriority(NVIC_GetPriorityGrouping(), 3, 0));
  NVIC_EnableIRQ(DMA1_Channel2_IRQn);

  LL_DMA_EnableChannel(DMA1, LL_DMA_CHANNEL_2);
}

void bsp_adc3_init()
{
  LL_ADC_InitTypeDef ADC_InitStruct = {0};
  LL_ADC_REG_InitTypeDef ADC_REG_InitStruct = {0};
  LL_ADC_CommonInitTypeDef ADC_CommonInitStruct = {0};

  LL_GPIO_InitTypeDef GPIO_InitStruct = {0};

  LL_RCC_SetADCClockSource(LL_RCC_ADC345_CLKSOURCE_SYSCLK);

  LL_AHB2_GRP1_EnableClock(LL_AHB2_GRP1_PERIPH_ADC345);

  ADC_InitStruct.Resolution = LL_ADC_RESOLUTION_12B;
  ADC_InitStruct.DataAlignment = LL_ADC_DATA_ALIGN_RIGHT;
  ADC_InitStruct.LowPowerMode = LL_ADC_LP_MODE_NONE;
  LL_ADC_Init(ADC3, &ADC_InitStruct);

  ADC_REG_InitStruct.TriggerSource = LL_ADC_REG_TRIG_EXT_HRTIM_TRG1;
  ADC_REG_InitStruct.SequencerLength = LL_ADC_REG_SEQ_SCAN_DISABLE;
  ADC_REG_InitStruct.SequencerDiscont = LL_ADC_REG_SEQ_DISCONT_DISABLE;
  ADC_REG_InitStruct.ContinuousMode = LL_ADC_REG_CONV_SINGLE;
  ADC_REG_InitStruct.DMATransfer = LL_ADC_REG_DMA_TRANSFER_UNLIMITED;
  ADC_REG_InitStruct.Overrun = LL_ADC_REG_OVR_DATA_OVERWRITTEN;
  LL_ADC_REG_Init(ADC3, &ADC_REG_InitStruct);

  LL_ADC_SetGainCompensation(ADC3, 0);
  LL_ADC_SetOverSamplingScope(ADC3, LL_ADC_OVS_GRP_REGULAR_CONTINUED);
  LL_ADC_ConfigOverSamplingRatioShift(ADC3, LL_ADC_OVS_RATIO_8, LL_ADC_OVS_SHIFT_NONE);

  ADC_CommonInitStruct.CommonClock = LL_ADC_CLOCK_SYNC_PCLK_DIV2;
  ADC_CommonInitStruct.Multimode = LL_ADC_MULTI_INDEPENDENT;
  LL_ADC_CommonInit(__LL_ADC_COMMON_INSTANCE(ADC3), &ADC_CommonInitStruct);

  LL_ADC_REG_SetTriggerEdge(ADC3, LL_ADC_REG_TRIG_EXT_RISING);

  LL_ADC_DisableDeepPowerDown(ADC3);

  LL_ADC_EnableInternalRegulator(ADC3);

  volatile uint32_t wait_loop_index;
  wait_loop_index = ((LL_ADC_DELAY_INTERNAL_REGUL_STAB_US * (SystemCoreClock / (100000 * 2))) / 10);
  while (wait_loop_index != 0)
  {
    wait_loop_index--;
  }

  LL_ADC_StartCalibration(ADC3, LL_ADC_SINGLE_ENDED);

  while (LL_ADC_IsCalibrationOnGoing(ADC3) != 0)
  {
  }

  volatile uint32_t cal = LL_ADC_GetCalibrationFactor(ADC3, LL_ADC_SINGLE_ENDED);

  wait_loop_index = ((LL_ADC_DELAY_CALIB_ENABLE_ADC_CYCLES * 32) >> 1);
  while (wait_loop_index != 0)
  {
    wait_loop_index--;
  }

  LL_ADC_Enable(ADC3);

  while (LL_ADC_IsActiveFlag_ADRDY(ADC3) != SET)
  {
  }

  LL_ADC_SetCalibrationFactor(ADC3, LL_ADC_SINGLE_ENDED, cal);

  LL_ADC_REG_SetSequencerRanks(ADC3, LL_ADC_REG_RANK_1, LL_ADC_CHANNEL_1);
  LL_ADC_SetChannelSamplingTime(ADC3, LL_ADC_CHANNEL_12, LL_ADC_SAMPLINGTIME_12CYCLES_5);
  LL_ADC_SetChannelSingleDiff(ADC3, LL_ADC_CHANNEL_12, LL_ADC_SINGLE_ENDED);
	
  LL_ADC_REG_StartConversion(ADC3);
}

void bsp_adc3_DMA_init(uint16_t* buffer)
{
  LL_AHB1_GRP1_EnableClock(LL_AHB1_GRP1_PERIPH_DMAMUX1);
  LL_AHB1_GRP1_EnableClock(LL_AHB1_GRP1_PERIPH_DMA1);

  LL_DMA_InitTypeDef DMA_InitStruct = {0};

  DMA_InitStruct.Mode = LL_DMA_MODE_CIRCULAR;
  DMA_InitStruct.Direction = LL_DMA_DIRECTION_PERIPH_TO_MEMORY;
  DMA_InitStruct.PeriphOrM2MSrcAddress = (uint32_t)&ADC3->DR;
  DMA_InitStruct.PeriphOrM2MSrcDataSize = LL_DMA_PDATAALIGN_HALFWORD;
  DMA_InitStruct.MemoryOrM2MDstDataSize = LL_DMA_MDATAALIGN_HALFWORD;
  DMA_InitStruct.NbData = 1;
  DMA_InitStruct.Priority = LL_DMA_PRIORITY_VERYHIGH;
  DMA_InitStruct.MemoryOrM2MDstAddress = (uint32_t)buffer + 0x10018000;
  DMA_InitStruct.PeriphRequest = LL_DMAMUX_REQ_ADC3;
  DMA_InitStruct.PeriphOrM2MSrcIncMode = LL_DMA_PERIPH_NOINCREMENT;
  DMA_InitStruct.MemoryOrM2MDstIncMode = LL_DMA_MEMORY_INCREMENT;
  LL_DMA_Init(DMA1, LL_DMA_CHANNEL_3, &DMA_InitStruct);

  LL_DMA_EnableIT_TC(DMA1, LL_DMA_CHANNEL_3);

  NVIC_SetPriority(DMA1_Channel3_IRQn, NVIC_EncodePriority(NVIC_GetPriorityGrouping(), 3, 0));
  NVIC_EnableIRQ(DMA1_Channel3_IRQn);

  LL_DMA_EnableChannel(DMA1, LL_DMA_CHANNEL_3);
}
