HKUSTGZ-ROBOMASTER-PNX/RM25_SC5.5_OpenSource/(commit log)

2025-10-22 初始化仓库，搬运文件
    [BOM_G4SC5.5_PCB_G4SC5.5_2025-03-14.xlsx, PickAndPlace_PCB_G4SC5.5_2025-06-19.csv, ProPrj_G4SC5.5开源版.epro]
2025-10-23 已知问题：输入电流采样与Burst Mode有关。Buck->BuckBoost->Boost功能异常。功率控制响应速度较慢。 解决方案：Burst Mode从15：1改为3：1。限制占空比只工作在Buck。 计划提高控制频率和使用前馈。
    [BuckBoostController.cpp, BuckBoostStatePowerLimited.cpp, bsp_hrtim.c]
2025-10-26 新建dev分支，主要测试前馈功能和修复bug。大幅简化代码，已实装前馈控制，实测功率充放电切换时间在1ms内。
2025-10-26 改为默认使能debug_flag，防止上电就炸
2026-02-28 重构Buck Boost占空比计算和Burst切换，未测试
2026-03-04 使用移相修复Burst Mode下不正常占空比问题，之后更新文档说明
