HKUSTGZ-ROBOMASTER-PNX/RM25_SC5.5_OpenSource/(notices)

Notices in the files:
代码/Core/MAIN/main.cpp:
Copyright (c) 2023 STMicroelectronics.
All rights reserved.
This software is licensed under terms that can be found in the LICENSE file
